OpenAir-Lab/capstone-project/README.md

# capstone-project
ECE 438X Senior Design Capstone Project
