OpenAir-Lab/capstone-project/Documentation/Reference Designs/Texas Instruments/BOOSTXL-BATPAKMKII/Readme.txt

BOOSTXL-BATPAKMKII Hardware Design Files v1.00.00
Texas Instruments, Inc.

********************************************************************************
Welcome to the BOOSTXL-BATPAKMKII BoosterPack!
********************************************************************************

In this package, you will find hardware design files that can help you quickly
get started on developing your own project.

Available in the 'Hardware' folder are the complete board schematic and layout,
bill of material, and Gerber files.

You can also find various web links in the 'Documentation' folder pointing to
the Tool Page, Quick Start Guide, and User's Guide.

For more resources, be sure to visit www.ti.com/tool/boostxl-batpakmkii

********************************************************************************
Revision History
********************************************************************************
Ver 1.00.00 - June 3rd, 2016
- Initial Release

********************************************************************************
Project File Listing
********************************************************************************
|--Documentation                      : Folder containing links to more resources
|--Hardware                           : Folder containing hardware design files,
                                        bill of material and gerber files
|--Readme.txt                         : This file
