OpenAir-Lab/capstone-project/Documentation/RF Subsystem/Radio Transceiver/cc1200/Readme.txt

XXXXXXXXXXXXXXXXXXXXXXXXXXXXXXXXXXXXXXXXXXXXXXXXXXXXXXXXXXXXXXXX
X       Artwork and documentation done by: FRS/a0190551        X
X                                                              X
X       TEXAS INSTRUMENTS NORWAY LPRF                          X
X                                                              X
X       Address: Gaustadalléen 21, 0349 OSLO, Norway           X
X       web: www.ti.com/lprF                                   X
X                                                              X
XXXXXXXXXXXXXXXXXXXXXXXXXXXXXXXXXXXXXXXXXXXXXXXXXXXXXXXXXXXXXXXX

PCB NAME: CC120xEM_420_470
REVISION: 1.1
DATE: 2012-10-22

FILE:  PACKED WITH WinZIP 

PCB DESCRIPTION:4 LAYER PCB 1.24 MM nominal
      Copper        1   35 um
      Dielectric  1-2   0.4 mm (e.g. 2x Prepreg 7628 AT05 47% Resin)
      Copper        2   35 um
      Dielectric  2-3   0.3 mm (2 x 2157 49% Resin)
      Copper        3   35 um
      Dielectric  3-4   0.4 mm (e.g. 2x Prepreg 7628 AT05 47% Resin)
      Copper        4   35 um

      DE104iML or equivalent substrate (Resin contents around 45%, which gives Er=4.45@1GHz, TanD=0.016)
      Dimensions in mil (0.001 inch)
      DOUBLE SIDE SOLDER MASK,
      DOUBLE SIDE SILKSCREEN,
      6 MIL MIN TRACE WIDTH AND 6 MIL MIN ISOLATION.

FILE NAME            		      DESCRIPTION                                               FILE TYPE
-----------------------------------------------------------------------------------------------------------------------
***PCB MANUFACTURING FILES:
Layer1.art                            LAYER 1 TOP SIDE/POSITIVE                                 EXT. GERBER
Layer2.art                            LAYER 2/POSITIVE                                          EXT. GERBER
Layer3.art                            LAYER 3/POSITIVE                                          EXT. GERBER
Layer4.art                            LAYER 4 SOLDER SIDE/POSITIVE                              EXT. GERBER
outline.art                           Outline of PCB                                            EXT. GERBER
soldmask_top.art                      SOLDER MASK COMPONENT SIDE/NEGATIVE                       EXT. GERBER
soldmask_bottom.art                   SOLDER MASK SOLDER SIDE/NEGATIVE                          EXT. GERBER
silk_top.art	                      SILKSCREEN COMPONENT SIDE/POSITIVE                        EXT. GERBER
silk_bottom.art                       SILKSCREEN SOLDER SIDE/POSITIVE                           EXT. GERBER
CC120xEM_420_470-1-4.drl              NC DRILL                                                  EXCELLON
CC120xEM_420_470-1-4-np.drl           NC DRILL                                                  EXCELLON

ncdrill.log                           DRILL/NC DRILL REPORT                                     ASCII

*** ASSEMBLY FILES:
paste_top.art                         SOLDER PAST COMPONENT SIDE/POSITIVE                       EXT. GERBER
paste_bottom.art                      SOLDER PAST SOLDER SIDE/POSITIVE                          EXT. GERBER
assembly_top.art                      ASSEMBLY DRAWING COMPONENT SIDE/NEGATIVE                  EXT. GERBER
assembly_bottom.art                   ASSEMBLY DRAWING SOLDER SIDE/NEGATIVE                     EXT. GERBER
pcp_rep.rpt                           PICK AND PLACE FILE                                       ASCII
CC1200EM_420_470_partlist_1_1_0.xlsx  BOM                                                       Excel

PDF FILES:
CC120XEM_420_470_layout_1_1.pdf       Layout                                                    pdf
CC120XEM_420_470_schematic_1_1_0.pdf  Schematic diagram                                         pdf

README.TXT                            THIS FILE                                                 ASCII

END.
Revision history
----------------
rev.0.1.0 Initial design based on CC112xEM
rev.1.0.0 First design CC120xEM_420_470 (Cadence). Included PCB antanna
rev.1.1.0 Minor PCB change; redesigned PCB antanna.
