OpenAir-Lab/capstone-project/Documentation/RF Subsystem/Radio Transceiver/swrr070/Readme.txt

XXXXXXXXXXXXXXXXXXXXXXXXXXXXXXXXXXXXXXXXXXXXXXXXXXXXXXXXXXXXXXXXXXXXXXXXXXXXXXXXX
X                                                                                                                                                                                  X
X   Artwork and documentation done by: Texas Instruments Norway AS              			    X
X   Company: Texas Instruments Norway AS                                                                                                             X
X   Address: Gaustadalléen 21    0349 OSLO                                      					    X
X                                                                                                                                                                                  X
XXXXXXXXXXXXXXXXXXXXXXXXXXXXXXXXXXXXXXXXXXXXXXXXXXXXXXXXXXXXXXXXXXXXXXXXXXXXXXXXX

PCB NAME : CC-Antenna-DK
REVISION:  1.0 (PCB 1.0.0, BOM 1.0.2)
DATE:         2010-08-26

FILE:           SWRR070.ZIP PACKED WITH WinZIP V.11.0 

PCB DESCRIPTION: 

CC-Antenna-DK -  EtchLayer1Top	-------------------------------------------- 	0.5oz +plating
					CORE  57.68mil	 
CC-Antenna-DK -  EtchLayer2	-------------------------------------------- 	0.5oz+ plating
					
                 2 LAYER PCB 1.6 MM NOMINAL THICKNESS FR4		
                 DOUBLE SIDE SOLDER MASK,
                 SINGLE SIDE SILKSCREEN,
                 8 MIL MIN TRACE WIDTH AND 8 MIL MIN ISOLATION
                 Dielectric constant for FR4 is 4.2

FILE NAME            		                        DESCRIPTION                               	                       FILE TYPE
------------------------------------------------------------------------------------------------------------------
***PCB MANUFACTURING FILES:

CC-Antenna-DK -  EtchLayer1Top.gdo            LAYER 1 COMPONENT SIDE/POSITIV                     EXT. GERBER
CC-Antenna-DK -  EtchLayer2.gdo                  LAYER 2 BOTTOM layer/POSITIV                          EXT. GERBER

CC-Antenna-DK -  SoldermaskTop.gdo            SOLDER MASK COMPONENT SIDE/NEGATIVE         EXT. GERBER
CC-Antenna-DK -  SoldermaskBottom.gdo      SOLDER MASK BOTTOM SIDE/NEGATIVE               EXT. GERBER

CC-Antenna-DK -  SilkscreenTop.gdo              SILKSCREEN COMPONENT SIDE/POSITIVE              EXT. GERBER

CC-Antenna-DK -  SolderPasteTop.gdo           SOLDER PAST COMPONENT SIDE/POSITIVE          EXT. GERBER

CC-Antenna-DK -  Vcut.gdo 	                         V-CUT TRACK COMPONENT SIDE/POSITIVE           EXT. GERBER

CC-Antenna-DK -  DrillDrawingThrough.gdo   DRILL THROUGH HOLE                                           EXT. GERBER
CC-Antenna-DK -  ThruHoleNonPlated.ncd     DRILL NON-PLATED                                               EXT. GERBER
CC-Antenna-DK -  ThruHolePlated.ncd           DRILL PLATED                                                       EXT. GERBER

CC-Antenna-DK -  Rev 1_0_2 BOM and XY Coordinates.xls   BOM & PICK AND PLACE FILE        EXCEL
CC-Antenna-DK -  Outline.gdo	        PCB OUTLINE				     EXT. GERBER

***PDF FILES:
CC-Antenna-DK -  Rev 1_0_2 - COMPONENT PLACEMENT BOTTOM.pdf			     PDF
CC-Antenna-DK -  Rev 1_0_2 - COMPONENT PLACEMENT TOP.pdf			     PDF
CC-Antenna-DK -  Rev 1_0_2 - GERBER.pdf					     PDF
CC-Antenna-DK -  Rev 1_0_2 - SCHEMATIC.pdf					     PDF
									
README.TXT              THIS FILE                                   				     ASCII

***REVISION HISTORY
Rev 1.0                 Release of CC-Antenna-DK

END.
