OpenAir-Lab/capstone-project/Meeting Notes/August 25 - First Meeting of Senior Design 2.md

# Meeting Overview Summary - August 26. 2025
#### Attendees: Zack Potersnak, Eric Mutton, Jairo Thiongo, Adrianne Quick
## Meeting Goals
- Discuss and begin CDR slides to present to Dr.Tacca
- Further expand Gantt chart to include more task-based details
- Align on project requirements and goals
- Further elaborate on design specification of modules
- Plan future meetings for the team with and without Dr.Tacca

## Action Items
- [ ] Order parts by Wednesday afternoon (8.29)
  - All members will need to submit their orders by noon Wednesday (8.29)
- [ ] Send email to Dr. Tacca about planning to meet for CDR at 11:00am Friday (and lock in time for future advisor/team meetings)
- [ ] Fill out all slides for CDR by Thursday at 4:00pm
- [ ] Begin assigning tasks with timelines and descriptions under larger parent items in GitHub
- [ ] Identify and label all blockers (using GitHub Relationships)
- [ ] Attend KiCAD tutorial Friday after Lecture
- [ ] Begin design of PCBs (files due by 9.15)
- [ ] Complete all Summer project design tasks assigned to you in GitHub and place them in 'In Review' column
- [ ] Schedule Team Meeting for Tuesday in the Library study rooms

## Items Discussed & Updates
- Explored more of what Arduino Plug and Make is and how we can use it as a framework for design
  - Discussed packaging our final "kit" in the packaging provided or similar to (if applicable)
- Discussed 3d printing a case for protoboard if needed in the future
- EYESPI and QWIIC connectors will need to be ordered and the team will need to familiarize themelves with it
- Schematics are all in one 'master' document in the 'system-testbed' branch of the GitHub
- Issues in GitHub have been split into Summer and Fall Projects
  - We will need to complete and mark completed or merge all remaining summer tasks 
- Discussed putting the USB-PD on the Base PCB and adding power and ground rails to it similar to a breadboard
- Will use a protoboard to configure initial prototype while making sure all modules work
- Power sequencing was discussed and will need to be further clarified
  - RF Power Amplifier will need 5V but all remaining individual component power needs are 3.3V or below
- Discussed pros & cons of software defined power sequence vs hardwired power sequence
- Discovered need for and will be designing a PCB for the MCU (Adrianne)

#### The timeline for September at a glance is:
  - PCB files completed by September 15th (2nd week)
  - Spend following week reviewing designs and placing order (3rd week)
  - Develop Test Plan and receive PCBs (4th week)

## Future Meeting Details & Acknowledgements
For future meetings each team member is responsible for showing up on time, with deliverables and all applicable talking points 
needed for discussion in the meeting taking place. Each member will be expected to contribute not only to the projects but also in 
every meeting going forward. All meetings are madatory, excluding personal reasons, and if a team member is unable to attend a meeting 
or contribute for any reason, this must be communicated to the team in advance so that contigency plans can be made. Communication 
going forward is a vital part of the team work that has to happen for this project to succeed. Each team member is expected to act with 
professionalism when representing themselves and the team in these meetings.

### ** Team Meeting & Working session (members only): Tuesdays 1:00pm - 5:00pm in McDermott Library 
### ** Pre-Advisor Meeting Side Review (members only): Thursdays 4:00pm - 4:30pm on Teams
### ** Advisor Meeting: Fridays 11:00am (pending Dr.Tacca's approval)
