OpenAir-Lab/capstone-project/Documentation/Reference Designs/Texas Instruments/BOOSTXL-BATPAKMKII/Hardware/gerber/Transcode Report.txt

   ---- Transcoding 'C:\Users\a0273630\Documents\EVMs\BoosterPacks\FuelTank\Battery Boosterpack_v5\gerber\Battery Boosterpack_v2.LayerBottom.ger' ----   Thu Nov 20 16:38:33 2014

D10   --> D100
D11   --> D101
-----------------------------------------------------------------

   ---- Transcoding 'C:\Users\a0273630\Documents\EVMs\BoosterPacks\FuelTank\Battery Boosterpack_v5\gerber\Battery Boosterpack_v2.LayerTop.ger' ----   Thu Nov 20 16:38:33 2014

D10   --> D102
D11   --> D103
D12   --> D104
D13   --> D105
D14   --> D106
D15   --> D107
D16   --> D108
D17   --> D109
D18   --> D110
D19   --> D111
D20   --> D112
D21   --> D113
D22   --> D114
-----------------------------------------------------------------

   ---- Transcoding 'C:\Users\a0273630\Documents\EVMs\BoosterPacks\FuelTank\Battery Boosterpack_v5\gerber\Battery Boosterpack_v2.SilkscreenBottom.ger' ----   Thu Nov 20 16:38:34 2014

D10   --> D115
D11   --> D116
D12   --> D117
D13   --> D118
D14   --> D119
D15   --> D120
D16   --> D121
D17   --> D122
D18   --> D123
D19   --> D124
D20   --> D125
D21   --> D126
D22   --> D127
D23   --> D128
D24   --> D129
D25   --> D130
D26   --> D131
D27   --> D132
D28   --> D133
D29   --> D134
D30   --> D135
D31   --> D136
D32   --> D137
D33   --> D138
D34   --> D139
D35   --> D140
D36   --> D141
D37   --> D142
D38   --> D143
D39   --> D144
D40   --> D145
D41   --> D146
D42   --> D147
D43   --> D148
D44   --> D149
D45   --> D150
D46   --> D151
D47   --> D152
D48   --> D153
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

D10   --> D839
D11   --> D840
D12   --> D841
D13   --> D842
D14   --> D843
D15   --> D844
D16   --> D845
D17   --> D846
-----------------------------------------------------------------

   ---- Transcoding 'C:\space\BOOSTXL-BATPAKMKII\pcb\gerber\BOOSTXL-BATTPACKMKII.SolderStopMaskTop.ger' ----   Thu Sep 17 17:39:15 2015

D10   --> D847
D11   --> D848
D12   --> D849
D13   --> D850
D14   --> D851
D15   --> D852
D16   --> D853
D17   --> D854
D18   --> D855
D19   --> D856
D20   --> D857
D21   --> D858
D22   --> D859
D23   --> D860
D24   --> D861
D25   --> D862
D26   --> D863
D27   --> D864
D28   --> D865
D29   --> D866
D30   --> D867
D31   --> D868
D32   --> D869
D33   --> D870
D34   --> D871
D35   --> D872
D36   --> D873
D37   --> D874
D38   --> D875
D39   --> D876
D40   --> D877
-----------------------------------------------------------------
