OpenAir-Lab/capstone-project/Meeting Notes/Midterm Review.md

# OpenAir Lab Capstone — Schedule

**Current Phase:** Fabrication / Assembly  (IV.C in Final Report Structure)
**Objective:** Backfill Wiki with Final Report information up to [IV.B] and transition into firmware, testing, and documentation.

---

## Project Schedule (Weeks 8–13)

| **Week** | **Dates** | **Focus Area(s)** | **Tasks & Milestones** | **Supporting Work** |
|---|---|---|---|---|
| **Week 8** | Oct 12 – Oct 18 | PCB Finalization & Ordering | - Review & finalize PCBs<br>- Firmware workshop<br>- Order PCBs!!<br>- Advisor meeting & firmware updates<br>- Begin fabrication prep | - Begin building out Wiki<br>- Set up YouTube page |
| **Week 9** | Oct 19 – Oct 25 | Firmware Development & Test Setup | - Begin firmware testing framework<br>- Establish initial test setup | - Implement RTOS structure |
| **Week 10** | Oct 26 – Nov 1 | Test Setup & Software Integration | - Hardware/software integration<br>- Refine test procedures<br>- Start system-level software debugging | - Outline & begin YouTube video structure<br>- Continue Wiki documentation |
| **Week 11** | Nov 2 – Nov 8 | **DEMO WEEK** | - Conduct full system tests<br>- Firmware + software validation<br>- Demo preparation and delivery | - Record and edit YouTube videos<br>- Update Wiki with demo results |
| **Week 12** | Nov 9 – Nov 15 | Development & Troubleshooting | - Develop firmware features<br>- Debug system integration<br>- Troubleshoot PCB and interconnect issues | - Begin creating tutorials and lab documentation |
| **Week 13** | Nov 16 – Nov 22 | Refinement & Documentation | - Continue development and testing<br>- Finalize troubleshooting<br>- Build tutorials and educational lab materials | - Publish YouTube tutorials<br>- Finalize Wiki and final report sections |

---

**Deliverables by End of Week 13:**
- All subsystem PCBs fabricated and tested  
- Firmware and RTOS integrated across modules  
- Wiki fully populated with documentation, schematics, and video walkthroughs  
- YouTube tutorials and educational lab materials published  
- Final report completed and cross-referenced to Wiki sections  

# GitHub Wiki Structure

> **Legend:**  
> 🟢 = Backfill (content mostly complete; needs upload/cleanup)  
> 🟠 = In progress  
> 🔴 = Not started  

---

## 1. Background 🟢

---

## 2. Preliminary Design 🟠
- Problem Analysis  
- Specs / Features / Criteria  
- Decision Analysis  
  - Solution Analysis 🟢  
  - Effectiveness Criteria 🟢  

---

## 3. Solution Description 🟠
- List of Subsystems  
- Firmware? (TBD clarification)

---

## 4. Performance Optimization 🟠
- System Component Design  
- Design Criteria 🟢  
- Components (for each subsystem) 🟢  
- Fabrication Process 🔴  
- Performance Evaluation  
  - Metrics (e.g., CS, etc.) 🔴  

---

## 5. Performance Evaluation 🔴
- Metrics (CS, ...)

---

## 6. Project Implementation / Assessment 🟢
- Implementation Overview  
- Quantitative Results  
- Results Related to Design Criteria  

---

## 7. Conclusion, Overview of Work Statements 🟢

---

## 8. Future Work Recommendations 🟢
- Proposal as Conference Material or Lab Resource  

---

## 9. Other Issues 🟢
- Ethics / Environmental Discussion of Issues  
- Operating Instructions  
  - Setup, Modes of Operation  

---

## 10. Cost Estimate 🔴
- Materials, Construction  
- Purchase, Travel, Misc.  

---

## 11. Project Management Summary 🟢
- Tasks Completed / Pending  
- Time Allocated  
- Facilities and Personnel  

---

## 12. Appendices 🟢
- Bibliography  
- Design Schedule 🟠  
- Construction Schedule 🟢  
- Equipment List & Cost Breakdown 🟢  
- Subsystem PCB Pages 🟢  
- Design Drawings  
  - Method Design / Final Design 🟢  
- Code 🟢  

---

### 🔧 Notes
- Wiki sections correspond to Final Report structure ([IV.B] through [IV.C]).  
- Items marked 🟢 are ready to be ported or backfilled into the Wiki.  
- Items marked 🟠 are under current development (firmware, RTOS, design criteria, etc.).  
- Items marked 🔴 have not yet been started and should be scheduled during Weeks 9–11.  

---

**Next Steps**
1. Backfill all 🟢 sections from existing documentation and reports.  
2. Continue developing 🟠 sections during firmware and demo phase.  
3. Assign leads for 🔴 sections before final report compilation.
