OpenAir-Lab/capstone-project/Meeting Notes/september 4 - Team Slide Review.md

# Team Slide Review – Meeting Summary

## General Notes
- Meeting focused on slide preparation for advisor updates.
- Some technical issues with screen sharing and connectivity at the start.
- Emphasis on keeping updates forward-looking (covering both last week’s work and upcoming goals).

---

## Slide Updates & Deadlines
- **Update Content**: Each team member must update their slides with accomplishments and planned tasks by **tomorrow night**.
- **Deadline Concern**: Avoid last-minute updates; aim to finish before going to bed tonight if possible.
- **Format**: Each slide should include at least **3 action items**, broken down into smaller tasks to show steady progress.

---

## Key Slide Sections
1. **Timeline & Testing**
   - Add updated Gantt chart snapshot.
   - Break down remaining testing phases into tasks.
   - Prioritize testing breakdown urgently.

2. **Budget/BOM (Bill of Materials)**
   - Show starting budget, amount spent, and remaining balance.
   - Add tables with order forms.
   - Keep a running slide that tracks BOM progress with color coding:
     - Ordered
     - Received
     - Pending

3. **Subsystem Updates**
   - **Power Supply**: Questions around load switches. Concerns raised about introducing them too early without team-wide discussion.
   - **Microcontroller (Adrianne)**: Completed pin-mapping for CC1200, HMI display, USB-PD, keypad expander, microphone, and amp. Linked GitHub table for updates.
   - **RF System (Eric)**: Created footprints for modular connectors. Focus on routing and SPI interfacing. Considering use of a diplexer for band switching.
   - **Audio (Dominic)**: Addressing CDR feedback about I²S protocol and audio amplifier pin functions. Needs clear action items.
   - **HMI**: Drafting modulino layouts to show how keypad, knobs, and display fit together. Not presentation-ready yet.

---

## Advisor & Presentation Strategy
- Advisor (Dr. Tacca) should review BOM updates weekly, even if approved earlier.
- Slides should highlight **new progress only** to avoid redundancy.
- Upcoming Friday meeting is critical: need presentable PCB drafts.

---

## Educational Deliverables
- Begin planning **educational documentation and videos** soon.
- Zack has video editing skills – formalize his role for tutorials.
- YouTube channel creation in progress.

---

## Action Items
- All team members update slides with:
  - Completed tasks (last week + expected by next Friday).
  - At least 3 action items (smaller, trackable steps).
- Add updated Gantt chart, BOM tables, and budget overview.
- Subsystem owners ensure schematic capture and PCB drafts are included where possible.
- Educational content planning to start – assign roles.
- Next **workflow workshop** scheduled for **Monday** (in person).

---
