OpenAir-Lab/capstone-project/Meeting Notes/june-21-Team-meeting.md

Dominic - Power 

Adrianne - MCU (w/minor RF) &PCB

Jairo - Power

Zach - Power/MCU

Eric - Power/MCU & PCB

Entire Team - Power Amplifier 

Clip board with log sheet at station

We need to make sure the kits don’t exist 

Action Items:

Once over the Team Charter

Turn in Team Charter 

Palatable way to package the project and present it to Dr. Tacca
