OpenAir-Lab/capstone-project/Meeting Notes/PDR-July 21.md

# PDR Meeting 7.21.25

Here is a summary of questions Dr. Tacca would like us to be able to answer & advice he had for our project so far:

### For the Requirements Slide: 

- What constitutes a “standard educational framework”?  
- The requirements should be more attuned to ‘checkpoints’ instead of broad statements about the project. They need to be completable and have justifiable metrics that can verify the requirement has been met by others outside of the team.  
- “Easily accessible” means what? 

### For the Lithium-Ion Battery:

- Cover all bases that entail safety for this type of battery   
  - This includes how to store it when the device is not in use   
  - how to store it before or after assembly  
  - How to monitor it safely 

\*→ He discussed power output values with Jairo, I am a little unclear on what he was asking, I apologize. There was a mention of keeping the power below 20 watts at some point. If Jairo can fill in a little more information here about what they spoke about it would be greatly appreciated ←\*

### For the MCU:

- Look into whether both cores can be used with the Arduino IDE a  
- Is one dedicated to bluetooth/wi-fi?  
- 2 dedicated ports for I2S  
- Consider Pi-W  
- Use custom devkit for WROVER or espressif prebuilt?

### For the Audio:

- Look into what PCM entails and familiarize ourselves with it  
- Look into I2S and what that entails  
- Figure out the sampling rate for ham radio  
- Talk about a combination mic & speaker together in one IC   
- Figure out what we need to know for the audio to communicate with the MCU  
- How many ports and what protocols are needed

### For the HMI:

- Consider Pi-W if we are using a GUI or intricate display

#### Advice moving forward and presenting our project at the Expo as well as CDR:

- We need to be highlighting the educational aspect of our project more \- even at a high level (This means **by the Expo**)  
- Look into the IEEE framework and how our project fits into this  
- How are we going to make it exciting (i.e. documentation is boring)  
- Consider a video-style documentation  
- Consider a YouTube Channel (would Zach or anyone else be interested in the production/filming/editing aspect of this?) (Zach - yes)

We also have permission to start ordering parts as we see fit.

If anyone has anything else to add to this, please feel free
