OpenAir-Lab/capstone-project/Meeting Notes/Team Meeting for CDR slide review.md

# Capstone Team Meeting – CDR Slide Review

**Date/Time:** August 28, 2025  
**Attendees:** Eric Mutton, Adrianne Quick, Zack Potersnak, Jairo Thiongo, Dominic Nguyen  

## Agenda / Purpose  
- Review CDR slide deck in detail.  
- Assign presenters for each section.  
- Confirm content completeness (requirements, subsystems, statements).  
- Identify open questions for Dr. Tacca during the CDR.  

## Discussion Summary  
- **Agenda & Updates:** Agenda aligns with CDR requirements. Hours logged weekly. Gantt chart complete at high level, more detail needed. “Initial communication verification between CC1200 and MCU” added as next step.  
- **Abstract:** Condensed to three main points. Zack presenting.  
- **Presenter Assignments:**  
  - Agenda/Updates: Eric  
  - Abstract & Requirements: Zack  
  - Power Delivery: Jairo  
  - MCU & Interfaces: Adrianne  
  - RF: Eric  
  - Audio: Dominic  
  - HMI: Eric (backup Adrianne)  
  - Educational Goals: Zack  
  - Ethics: Dominic  
  - Lifelong Learning: Eric  
  - Contemporary Issues: Jairo  
  - Multidisciplinary: Adrianne  
- **Materials & Budget:** Slide is a summary; renamed “Materials & Budget.” $400 spent of $2000 budget.  
- **Subsystem Slides:** Power Delivery, MCU, RF, Audio, HMI covered. Notes on refinements: risk mitigation for RF, complete MCU schematics, expand Audio notes.  
- **Educational Goals:** Documentation to include schematics and firmware notes plus GitHub Wiki and YouTube channel tutorials.  
- **Statements:** Ethics, Lifelong Learning, Contemporary Issues, and Multidisciplinary statements assigned.  
- **Questions for DT:** OLED vs. TFT trade-offs; final product expectations (breadboard vs. enclosure); additional subsystem questions (Jairo, Domi
