OpenAir-Lab/capstone-project/Meeting Notes/notion/data-Sheets.md

# Data Sheets

[BQ24193](https://www.ti.com/product/BQ24193)

### Sub-1 GHz Radio Transceivers

The CC1101 is used in the [Flipper Zero](https://docs.flipper.net/sub-ghz)!

[CC1101](https://www.ti.com/product/CC1101)

There are two CC1200 evaluation boards currently at our table 👀

[CC1200](https://www.ti.com/product/CC1200)
