OpenAir-Lab/capstone-project/Meeting Notes/notion/resource-links.md

# Resource Links
#### When adding links to this file please include a brief description along with the link for ease and organization

- The UTDesign official [general project schedule](https://utdesignstudents.utdallas.edu/resources/project-schedule/) that gives a high level flow chart
- The [Team Charter](https://cometmail-my.sharepoint.com/:w:/g/personal/ejm190004_utdallas_edu/EQ1LKnZOM8VIiSS7B3VIxckBgWL9uP-HIgmwtFDW-8lb2w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) that opens Microsoft Office in your browser
- Amateur Radio Licensing [study application](https://blog.hamstudy.org/links/) - opens to helpful links
- KiCAD [Getting Started](https://docs.kicad.org/9.0/en/getting_started_in_kicad/getting_started_in_kicad.pdf) docs
- [GitHub Projects](https://docs.github.com/en/issues/planning-and-tracking-with-projects/learning-about-projects/about-projects) docs
- [GitHub Repositories](https://docs.github.com/en/repositories) docs
- [Learn Git Branching](https://learngitbranching.js.org/)
- [AWR RF Design Environment](https://www.cadence.com/en_US/home/tools/system-analysis/rf-microwave-design/awr-design-environment-platform.html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)
- [RF Cafe](https://www.rfcafe.com/) - recommended by Dr. Tacca
- Microwave [Information](https://www.microwaves101.com/) Resource
- Textbook information on [Matching Networks](https://eng.libretexts.org/Bookshelves/Electrical_Engineering/Electronics/Microwave_and_RF_Design_III_-_Networks_(Steer)/06%3A_Chapter_6/6.2%3A_Matching_Networks)
- Open Source Hardware (OSHWA) [Certification](https://certification.oshwa.org/)
