OpenAir-Lab/capstone-project/Meeting Notes/notion/youtube-channels.md

## PCB Design Guidance

[Phil’s Lab](https://www.youtube.com/@PhilsLab)

[PCB Design](https://www.youtube.com/playlist?list=PLXSyc11qLa1b9VA7nw8-DiLRXVhZ2iUN2)

### Power Delivery Board Design

[USB-C Power Delivery Hardware Design - Phil's Lab #104](https://www.youtube.com/watch?v=W13HNsoHj7A&list=PLXSyc11qLa1YhVCZ5xWPuPsE5MkgEy5TF&index=9&pp=iAQB)

### Design-for-Manufacturing

[PCB Design for Manufacturing Tips (DFM) - Phil's Lab #40](https://www.youtube.com/watch?v=T922aFyN6bw&list=PLXSyc11qLa1YhVCZ5xWPuPsE5MkgEy5TF&index=44&pp=iAQB)

Investigate [Hammond Cases](https://www.hammfg.com/part/1455L801BK?referer=1203) for common PCB sizing constraints and project enclosures

[Making Enclosure Panels Using PCBs - Phil's Lab #102](https://www.youtube.com/watch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)

### RF PC Board Design

[Practical RF Hardware and PCB Design Tips - Phil's Lab #19](https://www.youtube.com/watch?v=_Hfzq1QES-Q&list=PLXSyc11qLa1YhVCZ5xWPuPsE5MkgEy5TF&index=56&pp=iAQB)

[PCB Traces 101 - Phil's Lab #112](https://www.youtube.com/watch?v=xEVntmYLARw&list=PLXSyc11qLa1YhVCZ5xWPuPsE5MkgEy5TF&index=3&pp=iAQB)

## Low-Level Programming Guidance

[Ben Eater](https://www.youtube.com/@BenEater)
