OpenAir-Lab/capstone-project/Meeting Notes/notion/previous-SD-posters.md

## Wi-SUN Smart Traffic System

[Submit-Poster-for-EXPO_Team-2024_attempt_2024-12-09-21-13-23_FinalPosterFall2024-Copy(1).pptx](attachment:9f649d76-8c50-418c-89ad-cf9f179707b4:Submit-Poster-for-EXPO_Team-2024_attempt_2024-12-09-21-13-23_FinalPosterFall2024-Copy(1).pptx)

- IoT Mesh using TI radio chips (CoAP Packet Error Rates)
- Embedded Programming (RTOS)
- PCB Design for Concept Testbench
- Long-Distance Smart City EMCOMM

## Hackers: Dynamic Engineering Puzzle Game

[Submit-Poster-for-EXPO_Team-2028_attempt_2024-12-09-21-33-17_PosterTeam2028-Copy.pptx](attachment:733f7303-a750-412c-9e36-0c41140147e4:Submit-Poster-for-EXPO_Team-2028_attempt_2024-12-09-21-33-17_PosterTeam2028-Copy.pptx)

- High-school ECE Fundamentals Educational Platform
- PCB design for Vault Puzzle Games
- Embedded Programming and Game Design

## Solar Charging Station

[Submit-Poster-for-EXPO_Team-2052_attempt_2024-12-09-21-16-13_Team-2052-Senior-Project-Expo-Poster-Solar-Charging-Station-UTDExpo21-Copy.pptx](attachment:7120a6c9-f75b-4df4-9edf-7ee4e6276949:Submit-Poster-for-EXPO_Team-2052_attempt_2024-12-09-21-16-13_Team-2052-Senior-Project-Expo-Poster-Solar-Charging-Station-UTDExpo21-Copy.pptx)

- Initial Project Work as Recreational/Hobby Drone Battery charger
- Extended to more Power Delivery options for different LiPo batteries
- Ethics Statement: Our team pledges that our project will conform to IEC and UL safety guidelines and standards for charging devices.
- 3D Printed Chassis

## Project 21cm

[Submit-Poster-for-EXPO_Team-2022_attempt_2024-12-09-23-56-22_EXPO2_Poster_Team2022-Copy.pptx](attachment:e78a06b2-2662-46c9-a283-69ed7613edb1:Submit-Poster-for-EXPO_Team-2022_attempt_2024-12-09-23-56-22_EXPO2_Poster_Team2022-Copy.pptx)

- Hobbyist Astronomic Telescopy using Software Defined Radio
- Actuating antenna (Az/El) for Magnitude Heatmap
- Embedded Programming for stepper motor driver boards and 6-DoF Gyro
- Rectangular Horn Antenna Modelling (Gain/Beam Plot)
