OpenAir-Lab/capstone-project/Documentation/Datasheets/Adafruit/adafruit-eyespi-pinout.png

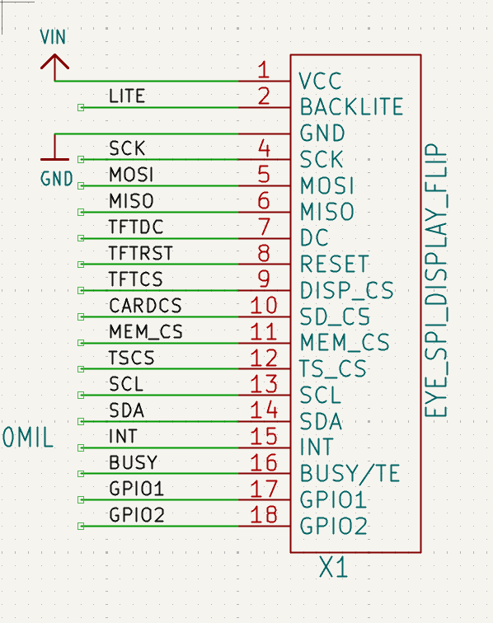
Documentation/Datasheets/Adafruit/adafruit-eyespi-pinout.png
