OpenAir-Lab/capstone-project/Documentation/RF Subsystem/Radio Transceiver/cc1200/8623.timing.png

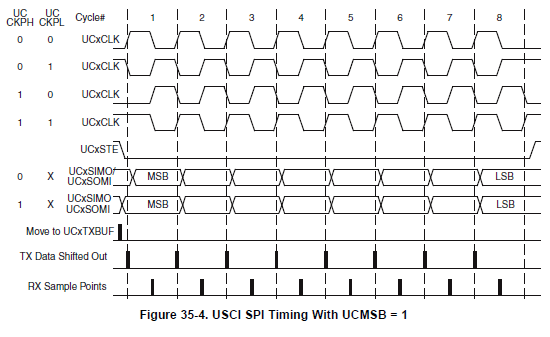
Documentation/RF Subsystem/Radio Transceiver/cc1200/8623.timing.png
