OpenAir-Lab/capstone-project/Documentation/RF Subsystem/Radio Transceiver/swrr070/CC-Antenna-DK -  Rev 1_0_2 BOM and XY Coordinates.xls

Sheet: TI BOM Rev 1.0.2
AntennaKit Board Rev: 1.0.2
This list is automatically linked up to the G:\06_TEKNISK\06H_Cadstar\purchase_library\PurchaseLib.xls
Enter columns in green
Ref. | Part name | Pcs/unit | Description | Manufacturer | Part number | Supplier | Ordering code | Alt. Manufacturer | Alt. Part number | Alt. Supplier | Alt. Ordering code | Comments
P1, P2, P3, P4, P5, P6, P7, P8, P9, P10, P11, P12, P13, P14, P15, P16 | SMA_Female_ThroughHole | 16 | SMA connector, female, through hole | Wellshow Techology | C02AN31P00101 | Freber | C02AN31P00101
R21, R22 | R_100_0402_F | 2 | Resistor, 100 ohms, 0402, ±1% | Koa | RK73H1ETTP1000F | ELFA | 60-475-75
A3, A12 | AMD1103-ST01T | 2 | MITSUBISHI CHIP ANTENNA | Mitsubishi | AMD1103-ST01T | Mitsubishi | AMD1103-ST01T
A4 | W3013 | 1 | PULSE CHIP ANTENNA | Pulse | W3013 | Pulse | W3013
A8 | W3127 | 1 | PULSE HELICAL ANTENNA | Pulse | W3127 | Pulse | W3127
A16 | W3126 | 1 | PULSE HELICAL ANTENNA | Pulse | W3126 | Pulse | W3126
A141, A142 | ANT-315-HETH | 2 | ANTENNA FACTOR (ANT-315-HETH), ANTENNA 315MHZ THRU HOLE | Linx Technologies Inc | ANT-315-HETH | Digikey | ANT-315-HETH-ND
A13 | ANT-433-HETH | 1 | ANTENNA FACTOR (ANT-433-HETH), ANTENNA 433MHZ THRU HOLE | Linx Technologies Inc | ANT-433-HETH | Digikey | ANT-433-HETH-ND
A11 | ANT-916-HETH | 1 | ANTENNA FACTOR (ANT-916-HETH), ANTENNA 916MHZ THRU HOLE | Linx Technologies Inc | ANT-916-HETH | Digikey | ANT-916-HETH-ND
Z31, Z42, Z53, Z63, Z71, Z73, Z103, Z111, Z121, Z131, Z141, Z151 | C_0402 | 12 | Capacitor, general, 0402; Do not mount
Z33, Z41, Z54, Z72, Z83, Z104, Z152 | R_0_0402 | 7 | Resistor, 0 ohm, 0402 | Koa | RK73Z1ETTP | ELFA | 60-470-05
Z113, Z132 | L_27N_0402_J | 2 | Inductor, 27n, 0402, ±5% | Murata | LQG15HS27NJ02D | ACTE
Z43 | C_8P2_0402_NP0_C_50 | 1 | Capacitor, 8p2, 0402, NP0, +-0.25pF, 50V | Murata | GRM1555C1H8R2CZ01D
Z101, Z61 | L_10N_0402_J | 2 | Inductor, 10n, 0402, ±5% | Murata | LQG15HS10NJ02D |  |  | Coilcraft
Z32, Z82, Z162 | L_22N_0402_J | 3 | Inductor, 22n, 0402, ±5% | Murata | LQG15HS22NJ02D | ACTE
Z102 | L_12N_0402_J | 1 | Inductor, 12n, 0402, ±5% | Murata | LQG15HS12NJ02D | ACTE
Z123 | L_39N_0402_J | 1 | Inductor, 39n, 0402, ±5% | Murata | LQG15HS39NJ02D
Z112 | L_18N_0402_J | 1 | Inductor, 18n, 0402, ±5% | Murata | LQG15HS18NJ02D | ACTE
Z62 | C_2P7_0402_NP0_C_50 | 1 | Capacitor, 2p7, 0402, NP0, +-0.25pF, 50V | Murata | GRM1555C1H2R7CZ01D
Z81 | C_7P5_0402_NP0_C_50 | 1 | Capacitor, 7p5, 0402, NP0, +/-0.25pF 50V | Murata | GRM1555C1H7R5CZ01D
Z122 | L_68N_0402_J | 1 | Inductor, 68n, 0402, ±5% | Coilcraft
Z51 | C_6P2_0402_NP0_C_50 | 1 | Capacitor, 6p8, 0402, NP0, +-0.25pF 50V | Murata | GRM1555C1H6R2CZ01D
Z133 | C_5P6_0402_NP0_C_50 | 1 | Capacitor, 5p6, 0402, NP0, +-0.25pF, 50V | Murata | GRM1555C1H5R6CZ01D
Z142 | L_47N_0402_J | 1 | Inductor, 47n, 0402, ±5% | Murata | LQG15HS47NJ02D
Z143 | L_100N_0402_J | 1 | Inductor, 100n, 0402, ±5% | Murata | LQG15HSR10J02
Z153 | C_1P2_0402_NP0_C_50 | 1 | Capacitor, 1p2, 0402, NP0, +/-0.25pF 50V | Murata | GRM1555C1H1R2CZ01D
Z161 | C_22P_0402_NP0_J_50 | 1 | Capacitor, 22p, 0402, NP0, 5%, 50V | Murata | GRM1555C1H220JZ01D
Z52 | L_5N6_0402_S | 1 | Inductor, 5n6, 0402, Monolithic type, +/-0.3 nH | Murata | LQG15HS5N6S02D | ACTE |  | Coilcraft |  | FINNES IKKE SOM 5%, GJO 18_03_2004, bruk S-tolerance
Z163 | L_4N7_0402_S | 1 | Inductor, 4n7, 0402, +/-0.3 nH | Murata | LQG15HS4N7S02D | ACTE
 |  | 68

Sheet: XY Coordinates Rev 1.0.2
XY Coordinates
Reference Designator | X | Y | Side
P9 | 20.00 | 51.70 | BOTTOM
P10 | 40.00 | 51.70 | BOTTOM
P11 | 66.00 | 51.70 | BOTTOM
P12 | 98.00 | 51.70 | BOTTOM
P13 | 135.00 | 51.70 | BOTTOM
P14 | 175.00 | 51.70 | BOTTOM
P15 | 214.00 | 51.70 | BOTTOM
P16 | 246.00 | 51.70 | BOTTOM
P8 | 246.00 | 146.70 | BOTTOM
P7 | 217.30 | 146.70 | BOTTOM
P6 | 182.40 | 146.70 | BOTTOM
P5 | 136.00 | 146.70 | BOTTOM
P4 | 110.00 | 150.90 | BOTTOM
P3 | 65.00 | 146.70 | BOTTOM
P2 | 40.00 | 146.70 | BOTTOM
P1 | 20.00 | 146.70 | BOTTOM
A11 | 65.95 | 88.41 | TOP
Z83 | 245.95 | 168.45 | TOP
Z163 | 245.95 | 73.41 | TOP
A142 | 182.60 | 99.00 | TOP
A141 | 182.60 | 86.60 | TOP
A13 | 137.90 | 99.00 | TOP
Z71 | 217.70 | 165.26 | TOP
Z61 | 182.80 | 165.26 | TOP
Z51 | 136.40 | 165.27 | TOP
Z31 | 65.40 | 165.27 | TOP
Z101 | 40.40 | 70.27 | TOP
Z121 | 98.40 | 70.27 | TOP
Z131 | 135.40 | 70.27 | TOP
Z133 | 135.40 | 72.97 | TOP
Z143 | 175.40 | 72.97 | TOP
Z153 | 214.40 | 72.97 | TOP
Z103 | 40.40 | 72.97 | TOP
Z73 | 217.70 | 167.97 | TOP
Z63 | 182.79 | 167.97 | TOP
Z53 | 136.40 | 167.97 | TOP
Z151 | 214.39 | 70.27 | TOP
Z141 | 175.40 | 70.27 | TOP
Z112 | 65.95 | 71.62 | TOP
Z111 | 66.39 | 70.27 | TOP
Z113 | 66.41 | 72.97 | TOP
A8 | 254.75 | 174.25 | TOP
A16 | 254.75 | 79.25 | TOP
Z32 | 64.95 | 169.40 | TOP
Z33 | 64.95 | 171.40 | TOP
A12 | 86.70 | 101.70 | TOP
A3 | 56.50 | 196.95 | TOP
Z42 | 92.13 | 151.30 | TOP
Z43 | 89.43 | 151.30 | TOP
Z41 | 90.78 | 150.85 | TOP
A4 | 83.00 | 159.90 | TOP
Z122 | 97.93 | 74.40 | TOP
Z123 | 97.91 | 76.26 | TOP
Z162 | 245.95 | 71.60 | TOP
Z161 | 246.40 | 70.24 | TOP
Z81 | 246.40 | 165.26 | TOP
Z82 | 245.95 | 166.62 | TOP
Z104 | 39.95 | 75.10 | TOP
Z54 | 135.96 | 169.92 | TOP
R22 | 40.84 | 165.27 | TOP
R21 | 39.03 | 165.27 | TOP
Z132 | 134.95 | 71.62 | TOP
Z142 | 174.95 | 71.62 | TOP
Z152 | 213.95 | 71.62 | TOP
Z102 | 39.95 | 71.62 | TOP
Z52 | 135.95 | 166.62 | TOP
Z62 | 182.35 | 166.62 | TOP
Z72 | 217.25 | 166.62 | TOP
