OpenAir-Lab/capstone-project/Documentation/Reference Designs/Texas Instruments/BOOSTXL-BATPAKMKII/Hardware/BOOSTXL-BATPAKMKII.xls

Item | Embest P/N | Material Name | Material P/N |  | Usage | Location | Manufacturer | Description | Package
1 | 1009002200110 | Pin Socket | CRD-081413-A-G | PCS | 2 | J1,J2, J3, J4 | Major League | Connector,Pin Socket,Straight,Female,2x10Pin,2.54MM pitch,8.5,9.92,Gold Flash 1u, black,DIP | DIP
2 | 1009001200003 | Pin Header | P6E02A-602530-B1 | PCS | 1 | JP6 | CHI-BAN | Connector,Pin Header,Straight,Male,1x2Pin,2.54MM pitch,6.06,3.00,Gold Flash 1u, black,DIP | DIP
3 | 1009003100046 | Wafer | S2B-PH-SM4-TB(LF)(SN) | PCS | 1 | BATT | JST | Connector,PH Series PCB Header,Right Angle,Male,1x2Pin,2.0MM pitch,Tin Plated,white,SMD | SMD
4 | 1003001100161 | Thick film Resistor | RC0603JR-070RL | PCS | 7 | R2, R11, R12, R13, R25, R26,R28 | YAGEO | RES,0R,+/-5%,1/10W,SMD0603 | 0603
5 | 1003001100456 | Thick film Resistor | CRF1206-FX-R010ELF | PCS | 1 | R10 | Bourns | RES,0R01,+/-1%,1W,SMD1206 | 1206
6 | 1004001100116 | Ceramic Capacitor | GRM188R71C474KA88D | PCS | 3 | C6, C11, C12 | Murata | CAP,470NF,+/-10%,X7R,16V,SMD0603 | 0603
7 | 1003001100654 | Thick film Resistor | RC0603FR-071M8L | PCS | 1 | R14 | YAGEO | RES,1M8,+/-1%,1/10W,SMD0603 | 0603
8 | 1003001100202 | Thick film Resistor | RC0603JR-071KL | PCS | 1 | R3 | YAGEO | RES,1K,+/-5%,1/10W,SMD0603 | 0603
9 | 1004001100120 | Ceramic Capacitor | GRM188R71C105KA12D | PCS | 5 | C3, C8, C13, C16, C17 | Murata | CAP,1UF,+/-10%,X7R,16V,SMD0603 | 0603
10 | 1005004100006 | Inductor | LQM2HPN1R0MG0L | PCS | 1 | L3 | Murata | Power Inductor,Magnetic shielded,1uH,1.6A,0.055ohm,2.5X2.0X0.9mm,SMD | 1008
11 | 1005004100074 | Inductor | VLF4012AT-2R2M1R5 | PCS | 2 | L1, L2 | TDK | Power Inductor,Magnetic shielded,2.2uH,1.5A,0.076ohm,3.7x3.5x1.2mm,SMD | 3.7x3.5x1.2mm
12 | 1003001100223 | Thick film Resistor | RC0603JR-075K1L | PCS | 4 | R15,R5, R6, R7 | YAGEO | RES,5K1,+/-5%,1/10W,SMD0603 | 0603
13 | 1003001100229 | Thick film Resistor | RC0603FR-077K5L | PCS | 1 | R16 | YAGEO | RES,7K5,+/-1%,1/10W,SMD0603 | 0603
14 | 1003001100235 | Thick film Resistor | RC0603JR-0710KL | PCS | 6 | R8, R18, R20, R29, R30, R31 | YAGEO | RES,10K,+/-5%,1/10W,SMD0603 | 0603
15 | 1004001100129 | Ceramic Capacitor | GRM188R61A106KE69D | PCS | 4 | C1, C2, C9, C10 | Murata | CAP,10UF,+/-10%,X5R,10V,SMD0603 | 0603
16 | 1004001100162 | Ceramic Capacitor | GRM21BR60J226ME39L | PCS | 1 | C15 | Murata | CAP,22UF,+/-20%,X5R,6.3V,SMD0805 | 0805
17 | 1004001100106 | Ceramic Capacitor | GRM188R71C333KA01D | PCS | 1 | C14 | Murata | CAP,33NF,+/-10%,X7R,16V,SMD0603 | 0603
18 | 1003001100270 | Thick film Resistor | RC0603FR-07100KL | PCS | 1 | R22 | YAGEO | RES,100K,+/-1%,1/10W,SMD0603 | 0603
19 | 1003001100191 | Thick film Resistor | RC0603FR-07200RL | PCS | 2.00 | R23, R24 | YAGEO | RES,200R,+/-1%,1/10W,SMD0603 | 0603
20 | 1003001100584 | Thick film Resistor | RC0603FR-07270RL | PCS | 1 | R1 | YAGEO | RES,270R,+/-1%,1/10W,SMD0603 | 0603
21 | 1003001100655 | Thick film Resistor | RC0603FR-07274KL | PCS | 1 | R21 | YAGEO | RES,274K,+/-1%,1/10W,SMD0603 | 0603
22 | 1003001100364 | Thick film Resistor | RC0603FR-07499RL | PCS | 1 | R4 | YAGEO | RES,499R, +/-1%,1/10W,SMD0603 | 0603
23 | 1002004100080C | Power Management | BQ24250RGE | PCS | 1 | U2 | TI | IC,2A Single Input I2C, Standalone Switch-Mode Li-Ion Battery Charger with Power-Path Ion Battery Charger with Power-Path,VQFN-24,SMD | VQFN-24
24 | 1002004100081C | Power Management | BQ27441DRZT-G1A | PCS | 1 | U1 | TI | IC,ystem-Side Impedance Track. Fuel Gauge,SON-12,SMD | SON-12
25 | 1009007100030 | USB Connector | ZX62-B-5PA | PCS | 1 | USB | Hirose | Connector,MicroUSB B port,5 Position,Right Angle,Gold Flash 1u,black,SMD | SMD
26 | 1006002100036 | Diode | DFLS130L-7 | PCS | 2 | D1, D2 | Diodes | Diode,Schottky Diode,DFLS130L-7,21V,1A,PowerDI-123,SMD | PowerDI-123
Replaced |  | Thick film Resistor | RC0805JR-070RL | PCS | 2 |  | YAGEO | 0 ohm
27 | 1002005100052 | DC-DC | TPS63001DRCTG4 | PCS | 1 | IC3 | TI | IC,High efficient single inductor buck-boost converter,1.2A,QFN10,SMD;Customer Supply | QFN-10
28 | 1002005100053 | DC-DC | TPS63002DRCTG4 | PCS | 1 | IC4 | TI | IC,High efficient single inductor buck-boost converter,1.2A,QFN10,SMD;Customer Supply | QFN-10
29 | 1010002200002 | Toggle switch | TS-6 | PCS | 1 | S1 | Hongju | Switch,Toggle switch SPDT,right angle,3A@120VAC,red housing,nature plunger,19.63*9.13MM,DIP | DIP
30 | 1006001100033 | LED | FY1101F-TR | PCS | 1 | LED2 | Stanley | LED,Brightness Yellow,Water Clear,Right Angle Type,20mA,3.2x2.0mm,SMD | 3.2x2.0mm
31 | 1016001000004 | Battery | AE503759P6HA | PCS | 1 |  | AEenergy | Battery,Li Polymer Rechargeable Battery,3.7V,1200mAh,37x60x5mm
32 | 1001001000364 | PCB | Boostxl-Battpack PCB | PCS | 1 |  |  | 2 layers PCB,Green Soldermask,white Silkscreen,66x58mm,Immersion gold,Boostxl-Battpack PCB
