OpenAir-Lab/capstone-project/Documentation/RF Subsystem/Radio Transceiver/CC120X vs CC112X.xlsx

CC1200 EM 446 MHz version
Including LPF
Ref. | CC112X selection | CC120X selection
C11 | C_47N_0402_X7R_K_25 | 47nF | Same value
C12 | C_100N_0402_X5R_K_10 | DNM | FOR REGULATOR
C41 | C_10N_0402_X7R_K_25 | DNM | FOR REGULATOR
C51 | C_47N_0402_X7R_K_25 | 47nF | Same value
C52 | C_2U2_0603_X5R_K_10 | 2.2uF | Same value
C53 | DNM | 47nF | FOR REGULATOR
C61 | C_220N_0402_X5R_K_10 | 220nF | Same value
C121 | C_47N_0402_X7R_K_25 | 47nF | Same value
C131 | C_47N_0402_X7R_K_25 | 47nF | Same value
C151 | C_47N_0402_X7R_K_25 | 47nF | Same value
C171 | C_10N_0402_X7R_K_25 | 10nF | Same value
C172 | C_100P_0402_NP0_J_50 | 100pF | Same value
C173 | C_100P_0402_NP0_J_50 | 56pF | Frequency dependence?
C174 | C_82P_0402_NP0_J_50 | 39pF | Frequency dependence?
C175 | C_15P_0402_NP0_J_50 | 6.2pF | Frequency dependence?
C176 | C_12P_0402_NP0_J_50 | 2.2pF | Frequency dependence?
C177 | C_1P2_0402_NP0_B_50 | DNM
C181 | C_12P_0402_NP0_J_50 | 5.1pF | Frequency dependence?
C191 | C_12P_0402_NP0_J_50 | 5.1pF | Frequency dependence?
C201 | C_12P_0402_NP0_J_50 | 5.1pF | Frequency dependence?
C211 | C_10N_0402_X7R_K_25 | 10nF | Same value
C221 | C_47N_0402_X7R_K_25 | 47nF | Same value
C231 | C_1N8_0402_U2J_J_10 | 1.5nF | Frequency dependence?
C251 | C_47N_0402_X7R_K_25 | 47nF | Same value
C261 | C_47N_0402_X7R_K_25 | 47nF | Same value
C271 | C_47N_0402_X7R_K_25 | 47nF | Same value
C281 | C_47N_0402_X7R_K_25 | 47nF | Same value
C291 | C_47N_0402_X7R_K_25 | 47nF | Same value
C301 | C_15P_0402_NP0_J_50 | 15pF | 0k FOR TCXO
C302 | C_0402 | DNM
C311 | C_15P_0402_NP0_J_50 | 15pF | Same value
C321 | C_100N_0402_X5R_K_10 | DNM | FOR TCXO
C322 | C_22P_0402_NP0_J_50 | DNM | FOR TCXO
L1 | L_BEAD_102_0402 | BLM15HG102SN1 | FOR REGULATOR
L171 | L_220N_0402_J | 56nH | Frequency dependence?
L172 | L_18N_0402_J_LQW | 15nH | Frequency dependence?
L173 | L_100N_0402_J_LQW | 43mH | Frequency dependence?
L174 | L_68N_0402_J_LQW | 22nH | Frequency dependence?
L191 | L_150N_0402_J | 56nH | Frequency dependence?
L192 | L_82N_0402_J_LQW | 27nH | Frequency dependence?
L193 | L_39N_0402_J_LQW | 15nH | Frequency dependence?
L201 | L_82N_0402_J_LQW | 27nH | Frequency dependence?
P1 | SMD_SOCKET_2x10 | SFM-110-02-S-D-A-K-TR | Mechanical
P2 | SMD_SOCKET_2x10 | SFM-110-02-S-D-A-K-TR | Mechanical
P3 | SMA_SMD | SMA-10V21-TGG | Mechanical
R12 | 0 | 0 | IS XTAL SHUNT FOR EXT_XOSC
R141 | R_56K_0402_F | 56k | Same value
R171 | R_22_0402_J | 18 | Different value
R321 | DNM | DNM | NO TCXO & XTAL?
R322 | R_0_0402 | DNM | FOR TCXO
U1 | CC112X | CC120xRHB | SAME FAMILY
U2 | TPS79930 | DNM | FOR REGULATOR
X1 | X_32.000/10/20/60/10 | 40MHz | IS XTAL
X2 | TG_5021CG | DNM | IS TCXO
