OpenAir-Lab/capstone-project/Documentation/Reference Designs/Guerrilla RF/GRF-DFN6-15-23A/DFN6-15-23-A.dxf

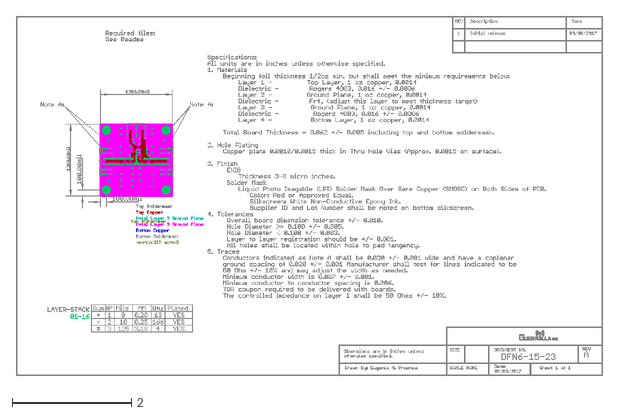
[picture p3: CAD file, 2025-10-23]
Documentation/Reference Designs/Guerrilla RF/GRF-DFN6-15-23A/DFN6-15-23-A.dxf
9.82 x 6.02
