OpenAir-Lab/capstone-project/Documentation/Reference Designs/Arduino/ABX00110-cad-files/ABX00110 DXF/ABX00110_DXF_BOTTOM ASSEMBLY.DXF

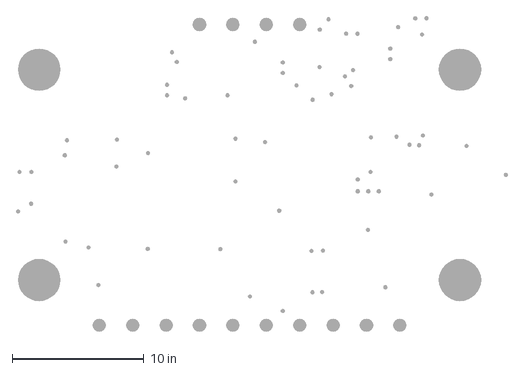
[picture p4: CAD file, 2025-10-23]
Documentation/Reference Designs/Arduino/ABX00110-cad-files/ABX00110 DXF/ABX00110_DXF_BOTTOM ASSEMBLY.DXF
37.4 x 24.0 in
