OpenAir-Lab/capstone-project/Documentation/Reference Designs/Arduino/ABX00110-cad-files/ABX00110 STEP/ABX00110.step

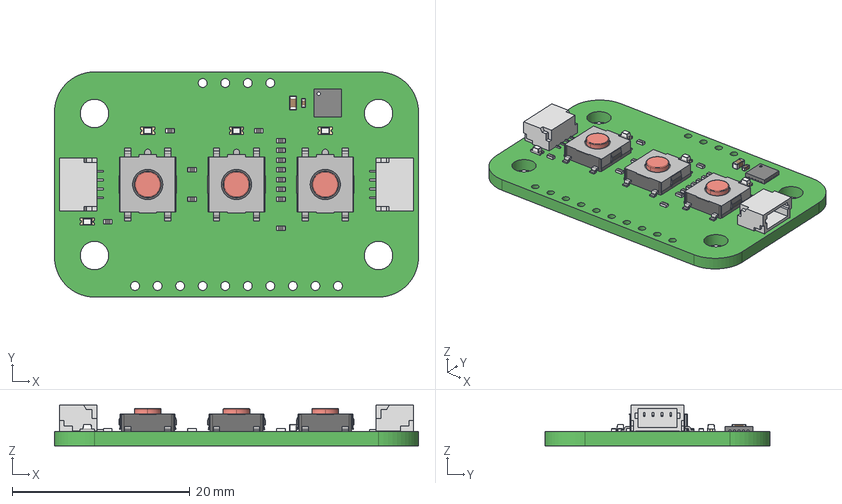
[picture p5: CAD file, 2025-10-23]
Documentation/Reference Designs/Arduino/ABX00110-cad-files/ABX00110 STEP/ABX00110.step
41.0 x 25.4 x 4.58 mm
RES-0402 x 13
CAP-0603
CAP-0402
SM04B-SRSS-TB_RGB12040119 x 2
HSMx-190 x 4
TETactileSwitch1571636 x 3
