OpenAir-Lab/capstone-project/Documentation/Reference Designs/Arduino/ABX00110-cad-files/ABX00110 DXF/ABX00110_DXF_BOTTOM SOLDER.DXF

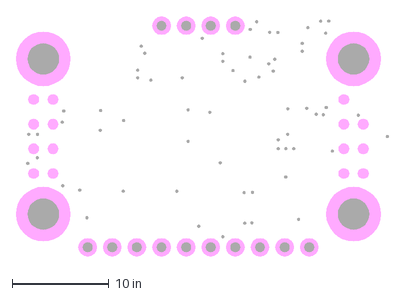
[picture p6: CAD file, 2025-10-23]
Documentation/Reference Designs/Arduino/ABX00110-cad-files/ABX00110 DXF/ABX00110_DXF_BOTTOM SOLDER.DXF
38.4 x 24.8 in
