OpenAir-Lab/capstone-project/(list of files, cad)

Other CAD files:
Documentation/Reference Designs/Guerrilla RF/QFN16-30-46-A/QFN16-30-46-A.DWG
Documentation/Reference Designs/Arduino/ABX00110-cad-files/ABX00110 DXF/ABX00110_DXF_TOP ASSEMBLY.DXF
Documentation/Reference Designs/Arduino/ABX00110-cad-files/ABX00110 DXF/ABX00110_DXF_TOP SOLDER.DXF
Documentation/Reference Designs/Arduino/ABX00110-cad-files/ABX00110 DXF/ABX00110_DXF_TOP.DXF
Documentation/Reference Designs/Arduino/ABX00110-cad-files/ABX00110 DXF/ABX00110_DXF_ALL.DXF
Documentation/Reference Designs/Arduino/ABX00110-cad-files/ABX00110 DXF/ABX00110_DXF_OUTLINE.DXF
Documentation/Reference Designs/Arduino/ABX00110-cad-files/ABX00110 DXF/ABX00110_DXF_BOTTOM.DXF
