OpenAir-Lab/capstone-project/(threads)

Thread 2 (2025-06-30):

Research and compare MCUs for project

AdrianneQuick, 2025-06-30:
I will be comparing different MCUs to use for the project. I know we want one that can operate in low power and has bluetooth capabilities. If the are more requirements or constraints I should be looking out for please comment below and let me know

ericmutton, 2025-07-01:
Along the RP2040/RP2350 route, the newly released $4 [Radio Module 2](https://www.raspberrypi.com/news/raspberry-pi-radio-module-2-available-now-at-4/) adds comprehensive wireless connectivity for the RPI SoCs.

Dominicc1, 2025-07-17:
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

Thread 3 (2025-07-01):

Research on Battery Management System

RawToast54, 2025-07-01:
Utilizing a USB-C to deliver 5V charging power to the battery. Research on the components needed to design a circuit to manage the distribution and safety measures for a lithium-ion battery.

Relevant Resources:
- [TI-BOOSTER PACK users guide](https://www.ti.com/lit/ug/slau618a/slau618a.pdf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)
- [BQ25620 User Guide](https://www.ti.com/lit/ug/sluuck2a/sluuck2a.pdf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)

BMS Datasheets:
- [BQ25620](https://www.ti.com/lit/ds/symlink/bq25620.pdf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) (3.5A)
- [BQ24250](https://www.ti.com/lit/ds/symlink/bq24250.pdf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) (2A)
- [MAX8903A](https://www.analog.com/media/en/technical-documentation/data-sheets/MAX8903-MAX8903Y.pdf) (2A)
- [BQ25611D](https://www.ti.com/lit/ds/symlink/bq25611d.pdf?ts=1752858513315) (BQ25611DRTWR) (3A)

Resource on why we use a BMS and its function/benifits:
- [How BMS ensure safety and performance](https://www.monolithicpower.com/en/learning/resources/how-lithium-ion-battery-management-systems-enhance-battery-performance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)

DigiKey Links:
- [BQ25620RYKR](https://www.digikey.com/en/products/detail/texas-instruments/BQ25620RYKR/16982067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)

ericmutton, 2025-07-02:
Here is the direct download for the [BOOSTXL-BATPAKMKII](https://software-dl.ti.com/msp430/msp430_public_sw/mcu/msp430/BOOSTXL-BATPAKMKII/latest/index_FDS.html) design files.

ericmutton, 2025-07-05:
This may also require evaluating whether to go single-cell or multi-cell.

Once the estimated power consumption of the system is known, current limits and system voltage settings can be defined in our specification.

Mobile amateur radio stations, such as those in consumer vehicles, are typically rated for 12A 13.8V supply power and output approximately 50W. In QRP applications, the ratings are lower, allowing for the use of 3.7V Li-Ion cells with lower current ratings (e.g. <10A)

RawToast54, 2025-07-19:
Current Progress on mapping and Organizing favored BMS

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

Closed 2025-09-02.

Thread 4 (2025-07-01):

Deciding on whether using a Linear Voltage Regulator or Switching Regulator

RawToast54, 2025-07-01:
Linear Reg -> Low Noise, Easy to implement, Find one with Low-Drop-Out to minimize P-loss

Switching Reg -> If we need more than 3.3V in the circuit, we will most likely need to implement a boost regulator.
                        -> High Efficiency, however, at the cost of Noise, more components

Thread 5 (2025-07-01):

Select between ESP32-WROOM and ESP32-WROVER

AdrianneQuick, 2025-07-01:
All of my MCU research for this parent and sub issue will be located in the repository called [NOTION-merge](https://github.com/OpenAir-Lab/NOTION-merge.git) in the file [MCU-info](https://github.com/OpenAir-Lab/NOTION-merge/blob/7720a083adbd99a688af0d599e59c1ee48b8a8a7/mcu-info.md)

We need to choose between ESP32-WROOM and ESP32-WROVER. I will put my comparisons in the file I linked above.

We also need to decide how much memory (flash) and PSRAM we should include with the board in order to select the right model.

AdrianneQuick, 2025-07-02:
Some questions that need to be answered:
- Will we be processing audio, doing any digital buffering, or storing modulated data streams?
- Will we have voice compression/decompression as a feature?
- Offline recordings of transmissions?
- Graphical displays & file system logs?
- Do we want to give target audience freedom to experiment?
- Digital Signal Processing done with MCU?

ericmutton, 2025-07-04:
Having an SD card or PSRAM partition readied for settings persistence and messages (i.e. images, voice recordings) could address the offline transmissions aspect of this work.

Thread 10 (2025-07-02):

Develop a subsystem block diagram for ESP32

AdrianneQuick, 2025-07-02:
In the block diagram specifically for the ESP32 subsystem it will need to show pin/function mapping, peripherals, and power sources that will be controlled (high level). Also need to include reset and boot sequence logic.

AdrianneQuick, 2025-07-17:
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

Thread 6 (2025-07-02):

Define Schematic Recapture

ericmutton, 2025-07-02:
## Scope
Describe the process of going from captured schematics and board artifacts to valid KiCAD (9.0) Project files. In doing so, existing design artifacts can be clearly included as device evaluation and prototyping commences.

- Multiple KiCAD projects must be maintained under `Hardware/KiCAD`
  - `.gitignore` must ignore all local KiCAD files to avoid 'polluted' KiCAD Projects
  -  'polluted' KiCAD projects can result in KiCAD believing files are already open on local machine when unopened.
-  Recapture process must be repeatable and possibly defined for multiple vendors

### Texas Instruments
Many devices have their evaluation board design files published in CADStar format. This will involve sourcing an archive of all corresponding designs made publicly available for download, then converting the fabrication files into an importable form for KiCAD project creation. Must seek conformity across vendors for ease of import and design evaluation.

### Espressif Systems
All SoC (System-on-Chip) Development Kits and their corresponding Modules all have publicly available design and fabrication files, going so far as including design specification for 'interposer' and 'module' development.
- 'interposer' is the board that is to be soldered to an application board that mounts the requisite devices for an ESP32 SoC to interoperate with external peripheral devices.
- 'module' is the self-contained and shielded device purchasable with an integrated [Meandering F-type Antenna](https://en.wikipedia.org/wiki/Inverted-F_antenna) for the 2.4GHz wireless connectivity.

### Raspberry Pi Foundation
Many of the Raspberry Pi families of Broadcom evaluation boards offer extensive educational-quality technical documentation with varied amounts of design files publicly published for educational use. As such, KiCAD already has symbols and footprints for much of these offerings, and recapture may be wholly unnecessary.

ericmutton, 2025-07-05:
@RawToast54 could you share your thoughts after recapturing the TI BOOSTXL-BATPAKMKII?

Closed 2025-09-02.

Thread 7 (2025-07-02):

Clarify RF Subsystems

ericmutton, 2025-07-02:
## Scope
These Radio Frequency (RF) subsystems must satisfy the definition of an amateur experiment and offer feasible uses for the RFICs selected. In doing so, this subsystem constitutes a peripheral to be interacted with by amateur radio operators.

The amateur radio subsystem must be designed for device operating frequencies in the VHF and UHF amateur radio frequency bands, 2m (144-148 MHz) and 70cm (420-450 MHz) respectively. These are both considered narrowbands.

### Radio Transceiver (TRX)
The radio transceiver must be capable of receiving and transmitting amateur radio communications in a two-way fashion. This will require putting the radio control unit in the proper modes in a real-time operating system.

The ability to flow the radio control unit through its state diagram in software will meter the firmware design artifact.

### Impedance Matching Network (Z Match)
A major design artifact will be the impedance matching network necessary for 2m operation, as Texas Instruments does not seem to offer as many EMKs for the SRD (Short Range Device) frequency band settings compared to ISM (Industrial, Scientific, and Medical) bands. There exists an evaluation board for the CC1200 at 70cm operation and a CC1120 169 MHz RF frontend that can be used in developing the required matching networks.

The efficiency of transmission and reception must be evaluated for this design artifact.

### Power Amplifier (PA)
The PA is an RFIC that must provide the amount of gain necessary to operate the radio transceiver in transmit mode at a level comparable with handheld transceivers (HTs).

The PA must be chosen to either be wideband enough to fit the two narrowbands, or there must be an RF switch network of some kind such as a single-pole-double-throw (SPDT) rated for sub-GHz operation. If a switch is required, two tuned PAs for each narrowband is possible, raising efficiency at the cost of complexity and necessary downtimes in two-way communications for switching and thus must be evaluated for effectiveness and limitation.

This artifact can be evaluated through the capability of accessing the local amateur radio repeater infrastructure including that of the TAGER tower on campus. In addition, further localized testing can be done with existing two-way radios and HTs.

ericmutton, 2025-07-02:
[RF Signal Chain Basics](https://www.analog.com/en/resources/analog-dialogue/articles/rf-signal-chain-discourse-part-2-essential-building-blocks.html)

It appears that many RFICs operate at a VDD of +5VDC. This is an additional Power Delivery Network design artifact evaluation to make, notably in including this rail at a low enough noise factor relating to RF Ground.

ericmutton, 2025-07-07:
### Clarifying Power Amplifiers

From GuerrillaRF there are a few different offerings in the following [GRF_DFN6_Solutions.pdf](https://github.com/user-attachments/files/21110559/GRF_DFN6_Solutions.pdf) document.

The [GRF2106](https://www.guerrilla-rf.com/products/detail/sku/GRF2106) is wideband and has very linear behavior which reduces the need for narrowband tuning. This very well means that just one RF frontend can be created instead of two, simplifying this subsystem down to just the transmit or receive paths.

The path switching may be handled by the TRX_SW on the transceiver side, with special consideration taken in whether the TX power amplifier can remain in-chain when in RX. This must be clarified in a revised subsystem block diagram.

The GRF-DFN6-15-23A is an evaluation board available for recapture or purchase. The [GRF2016](https://mou.sr/3xaI5A6) chip standalone is the cheapest option found thus far.

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

#### Alternatives

NXP and Mini Circuits are other vendors that offer devices with similar specifications to those I have found in discovery.

NXP [MMZ09332BT1](https://mou.sr/4eunRCE) and Mini Circuits [GALI-74+](https://mou.sr/4kGBSzR)

Closed 2025-08-19.

Thread 9 (2025-07-02):

Build Pin Mapping Table

AdrianneQuick, 2025-07-02:
GPIOs will need to be allocated for:

- [ ] SPI interface (CC1200)
- [ ] UART for logging & debug
- [ ] GPIOs for PA control, buttons, status LEDs
- [ ] SPI or I2C for LCD

Also, it is important to be aware of any pin conflicts for bootstrapping purposes. Keep this in mind when allocating the pins

Thread 11 (2025-07-03):

Clarify Physical Subsystems and Their Purposes

ericmutton, 2025-07-03:
### Scope
The complete system to design is comprised of several peripherals connected to a microcontroller.
- The power supply shall communicate with the microcontroller any information regarding the status of the battery management system.
- The microcontroller shall handle any peripheral digital signals through a General Purpose Input/Output (GPIO) expander to ensure that the MCU's GPIO Multiplexer (MUX) can prioritize communications interfaces.
- The audio subsystem shall allow for the use of [Pulse-Code Modulated (PCM)](https://en.wikipedia.org/wiki/Pulse-code_modulation) audio for both source and sink to minimize signal conversions.
- The human-machine interface shall inform the end-user of the state of the system and enable the reconfiguration of subsystems into different operating modes.
- The amateur radio subsystem shall allow two-way ham radio communications on a selected one of two narrow frequency bands ranged for repeater access.

### Outcomes
By clarifying each physical subsystem and their purpose, each subsystem can then begin the **sourcing process** for parts that satisfy their specified requirements. Thus a project **Bill of Materials (BoM)** can be generated.

A BoM can be generated through the use of **KiCAD schematic capture** of device reference designs and application circuit diagrams from device datasheets.

Thread 12 (2025-07-03):

Clarify Firmware Requirements and Constraints

ericmutton, 2025-07-03:
### Scope
Firmware requirements shall be based upon the state diagrams of peripherals with communications interfaces throughout all subsystems. Devices with error handling considerations must be given priority.

Firmware constraints shall be made in good consideration of specifications outlined in the selected device's datasheet defined in task #2.

### Outcomes
With firmware requirements and constraints defined, design work can begin on writing the software artifacts including the firmware to be uploaded to the primary microcontroller defined in task #2.

Closed 2025-09-02.

Thread 13 (2025-07-03):

Clarify Audio Subsystem

Dominicc1, 2025-07-03:
Network and Data Communication Protocol base on Range, Latency, Bandwidth, Security, Power Consumption
[DFR0954](https://mou.sr/3U2zFTo) I2S for Speaker

Dominicc1, 2025-07-15:
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

Dominicc1, 2025-07-15:
https://wiki.dfrobot.com/SKU_DFR0954_MAX98357_I2S_Amplifier_Module,
https://piembsystech.com/i2s-protocol-framing-working-applications/,
https://www.robotics.org.za/DFR0954
https://diyi0t.com/i2s-sound-tutorial-for-esp32/
https://learn.adafruit.com/adafruit-max98357-i2s-class-d-mono-amp/overview
https://www.amazon.com/PAM8403-Channel-Amplifier-Envistia-Mall/dp/B07N12VPTS
https://www.atomic14.com/videos/posts/lgDu88Y411o

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
PAM8403 Mini 2 Channel 3W Stereo Class D Audio Power Amplifier 3W+3W
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
Adafruit MAX98357 I2S Class-D Mono Amp
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
DF Robot MAX98357A I2S Amp Module

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

Dominicc1, 2025-07-18:
https://web.ece.ucsb.edu/Faculty/rodwell/Classes/ece2c/labs/lm386.pdf
LM386

AdrianneQuick, 2025-07-18:
@Dominicc1 will you please start adding more comments written by you into this so that I can better understand what you are doing. I see a lot of links and images but I don’t know why each one is there or what to pay attention to. It  will help me organize everything better if you stay on top of commenting and documentation please and thank you!

Closed 2025-09-02.

Thread 16 (2025-07-15):

Clarify RF Power Amplifier

ericmutton, 2025-07-15:
### Scope

From GuerrillaRF there are a few different offerings in the following [GRF_DFN6_Solutions.pdf](https://github.com/user-attachments/files/21110559/GRF_DFN6_Solutions.pdf) document.

The [GRF2106](https://www.guerrilla-rf.com/products/detail/sku/GRF2106) is wideband and has very linear behavior which reduces the need for narrowband tuning. This very well means that just one RF frontend can be created instead of two, simplifying this subsystem down to just the transmit or receive paths.

The path switching may be handled by the TRX_SW on the transceiver side, with special consideration taken in whether the TX power amplifier can remain in-chain when in RX. This must be clarified in a revised subsystem block diagram.

The GRF-DFN6-15-23A is an evaluation board available for recapture or purchase. The [GRF2106](https://mou.sr/3xaI5A6) chip standalone is the cheapest option found thus far.

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

#### Alternatives

NXP and Mini Circuits are other vendors that offer devices with similar specifications to those I have found in discovery.

NXP [MMZ09332BT1](https://mou.sr/4eunRCE) and Mini Circuits [GALI-74+](https://mou.sr/4kGBSzR)

ericmutton, 2025-07-16:
GuerrillaRF has an [application note](https://www.guerrilla-rf.com/support/application/notes/amp-power-up-down-procedures) on power up and power down procedures for their RF amplifiers.

ericmutton, 2025-09-01:
This issue may be revisited throughout the semester as this amplifier currently does not have any publicly available S parameters. Given our current equipment capabilities, S11 and S22 parameters can be created with advice from Dr. Lehmann's office hours and Dr. Henderson's coursework.

Thread 21 (2025-07-19):

Power Supply System

CURAC, 2025-07-19:
The power supply unit for this project is a smart charging and power management system. It is designed to safely and efficiently power the HAM radio from a universal USB-C SOURCE while managing the internal battery.

Its function entails three key operations:
  1. **Intelligent Negotiation**: Using a USB Power Delivery (PD) controller, the unit communicates with a USB-C charger to request a higher voltage (e.g., 12 V or 15 V) needed for the radio's circuits
  2. **Power Conversion & Charging**: It takes the negotiated high voltage and uses an efficient buck-boost converter to charge the internal Li-ion battery pack.
  3. **System Power Management**: It features a "Power Path" that allows the radio to be powered directly from the USB-C source, even if the battery is completely drained, ensuring uninterrupted operation while charging.

The following parts make up a part of the power supply. A sample BOM for visualization has been added below

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

ericmutton, 2025-07-22:
I restructured this power supply issue as a parent issue for all research tasks regarding power.

@CURAC you mention the use of a different battery management system than the BQ25620 described in research task #3, the [BQ25792](https://www.ti.com/product/BQ25792). @RawToast54 what are your thoughts on this?

RawToast54, 2025-07-31:
USB-PD IC's

- [TPS25762-Q1](https://www.ti.com/lit/ds/symlink/tps25762-q1.pdf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)
- [TPS25751 ](https://www.ti.com/lit/ds/symlink/tps25751.pdf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)

ericmutton, 2025-08-19:
@RawToast54 please let me know if you need assistance finishing the symbol and footprint import for your BMS recapture. Make sure to use the [system-testbed](https://github.com/OpenAir-Lab/capstone-project/tree/system-testbed) branch. https://github.com/OpenAir-Lab/capstone-project/commit/53f1a9e2cd4bad450e87ae31cc7b78fd570bf8c6

Thread 26 (2025-07-22):

Battery Selection and Safety Guides

RawToast54, 2025-07-22:
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

 _Originally posted by @RawToast54 in [#3](https://github.com/OpenAir-Lab/capstone-project/issues/3#issuecomment-3102938063)_

Thread 29 (2025-08-11):

Research On Modular System Compatibility

ericmutton, 2025-08-11:
## Scope

Here is an introduction of the [Adafruit Stemma QT/SparkFun Qwiic](https://learn.adafruit.com/introducing-adafruit-stemma-qt/sparkfun-qwiic) I2C prototyping system. Many I2C-based modules have been created by vendors implementing these 4-pin connectors.

The Arduino [Plug and Make Kit](https://store-usa.arduino.cc/products/plug-and-make-kit) is a popular example of a kit with guided tutorials for pluggable modules using Stemma QT/Qwiic called "Modulinos." **Notably, this approach is namely for exploring I2C devices.**

Here is some quality Arduino [documentation](https://docs.arduino.cc/resources/datasheets/ABX00110-datasheet.pdf) describing one "Modulino."

Adafruit sells the [connectors, cables, and accessories](https://learn.adafruit.com/introducing-adafruit-stemma-qt/featured_products) for implementation.

For other communication interfaces, this connector should be avoided for risk of hardware incompatibility. This must also exclude [SeeedStudio Grove](https://wiki.seeedstudio.com/Grove_System/#interface-of-grove-modules) connectors. **This means investigating alternatives for SPI and I2S due to a mismatch of signal count and pin count.**

Thread 30 (2025-08-14):

Workflow Runthrough

RawToast54, 2025-08-14:
A sitdown so that we have consistency in our circuit/PCB designs

AdrianneQuick, 2025-09-02:
I would like to suggest we begin learning about kicad as a group. Perhaps we begin a tips and tricks document and we start familiarizing ourselves with it   in today’s working session (09.02.25)

Thread 43 (2025-08-14):

PSU PCB Testing

RawToast54, 2025-08-14:

RawToast54, 2025-09-02:
Testing Battery stabilization, output voltage, regulation control, communication, Batt level reading, charging.

Thread 53 (2025-09-02):

MCU Pin Mapping and Interconnects

AdrianneQuick, 2025-09-02:
This is where we are deciding how the MCU will physically talk to everything else.

This includes:
- Defining the subsystem interconnects
- Pin mapping
- Bootstrapping requirements

Here are the peripherals/subsystems we need to connect:
- CC1200 (SPI, GDO interrupts, reset pin) [forum discussing CC1200 GDO pin](https://e2e.ti.com/support/wireless-connectivity/sub-1-ghz-group/sub-1-ghz/f/sub-1-ghz-forum/399163/cc1200-and-gdo-pin-for-pa-lna-control)
- Dispay(TFT) (SPI)
- Keypad Matrix & Roatary Encoder (GPIO)
- BMS & Fuel Guage (I2C)
- Programming/Debug (UART, JTAG header, EN/reset lines)
- Audio(mic & speaker) (I2S)

AdrianneQuick, 2025-09-03:
| Bus/Subsystem | Signal | ESP32 GPIO | Notes |
|--------|--------|--------|--------|
| VSPI —> CC1200 | SCLK | GPIO18 | reliable at high speeds |
| | MOSI | GPIO23 |  |
|  | MISO | GPIO19 |  |
|  | CS | GPIO32 |  |
|  | GDO0(IRQ) | GPIO34 | interrupt |
|  | GDO2(IRQ) | GPIO35 | second interrupt line |
| HSPI —> TFT Display | SCLK | GPIO14 |  |
| | MOSI | GPIO13 |  |
| | MISO | -- | TFT doesn’t need MISO (for writing on SD card) leave NC |
| | CS | GPIO04 | separate CS from radio |
| | DC | GPIO26 | data/command |
| | RST | -- | tie to 3V3 w/RC or to board’s reset |
| I2C —> BQ25620 + I/O Expander + STUSB4500| SDA | GPIO21 | shared bus - use 4.7-10 kΩ pull-up resistor |
| | SCL | GPIO22 | |
| | Expander INT| GPIO39 | wakes HMI task on change |
| | STUSB4500 ALERT | GPIO38 | open‑drain, pull‑up to 3V3, PD event interrupt |
| I2S —> Audio (full-duplex) | BCLK | GPIO27 | connect to Mic SCK + Amp BCLK, one clock for both devices |
| | LRCLK/WS | GPIO25 | connect to Mic WS + Amp LRCLK, shared LRCLK/WS  |
| | DOUT (ESP32—>Amp) | GPIO33 | connected to MAX98357A DIN, no MCLK needed |
| | DIN (mic—>ESP32) | GPIO36 | connected to CS‑43434 SD, no MCLK needed |
| HMI encoder | A/B | -- | put both phases on expander, INT—>GPIO39 |
| Keypad | Rows/cols | -- | entire matrix on expander, INT—>GPIO39 |
| Debug UART | TX0 / RX0 | GPIO1/GPIO3 | keep default for logs/CLI |

Avoid boot strapping pins (GPIO0/2/5/12/15). GPIO34–39 are input‑only. WROVER modules reserve GPIO16/17 internally for PSRAM

Thread 57 (2025-09-02):

Recapture Modulino for Templating

ericmutton, 2025-09-02:
Using the Adafruit and Arduino documentation for Modulinos and Adafruit Stemma QT/SparkFun Qwicc, a blank Modulino PCB design file must be made available.

ericmutton, 2025-09-02:
Regarding the EYESPI connector on the [Adafruit EYESPI Breakout Board](https://learn.adafruit.com/adafruit-eyespi-breakout-board%20breakout%20board) referenced in the following:
- #29
- #34
- #33

The SMT, 18-pin, 0.5mm pitch FPC connector recommended by an [Adafruit Forums Admin](https://forums.adafruit.com/viewtopic.php?t=219305) is the DigiKey [687118149022](https://www.digikey.com/en/products/detail/w%C3%BCrth-elektronik/687118149022/5047793).

This connector will need to be put in the MCU (2x), RF (1x) and HMI (1x) for utilizing the SPI interfaces of the devices and peripherals used in these subsystems.

ericmutton, 2025-09-04:
Here is a mockup of a Modulino for the #32 so far. I need help finding what connector would make sense to use for the I2S interface (3 pins) #29

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

Thread 59 (2025-09-02):

Testing PSU Output Voltage (Regulation control)

RawToast54, 2025-09-02:
Measuring the voltage seen at the output of the power supply. Here we expect to see a stable 3.3V.
Also here we can test the efficiency of the system.

Thread 60 (2025-09-02):

Design MCU PCB

AdrianneQuick, 2025-09-02:
Use Modulino format see #57

AdrianneQuick, 2025-09-04:
@ericmutton Would an 8bit one be too little?

ericmutton, 2025-09-04:
No, not at all, especially if we have on on each Modulino. For reference the keypad matrix being 4x4 needs a port (8 bits) exactly. Port 2 of the 16-bit one is so far the three DIO for the rotary encoder, so a 16-bit one is almost perfect for #33

ericmutton, 2025-09-04:
Heads up that the volume control may need to be on the #63 seeing as it is an analog signal. However, according to GROVE system compatibility #29 the I2C pins of a third Adafruit Stemma QT connector could be repurposed as Analog IO pins. Or we can do what [Arduino Knob](https://store-usa.arduino.cc/products/modulino-knob) board did but for a potentiometer.

Thread 62 (2025-09-02):

Power Budget

CURAC, 2025-09-02:
Please input the power consumption of your modules in the table below. This will help in deciding which regulators to use among other safety considerations.

| Module| Voltage rail | Current (Rx Mode) | Current (Tx Mode) | Assigned To|
| :--- | :--- | :--- | :--- | :--- |
| `RF Module (PA)` | +5 V|_ |_|`@ Eric`
| `RF Module (LNA)` | * |_ |_ |`@ Eric`
| `Wrover Module` | +3.3 V| _ |_ |`@ Adrianne`
| `Audio Module` | +3.3 V| _|_| `@ Dominic`
| `HMI Module` | +3.3 V | _ |_|`@ Eric/Adrianne`

Thread 64 (2025-09-03):

Outline FreeRTOS task architecture

AdrianneQuick, 2025-09-03:
For this we are deciding what runs, how often, at what priority, how pieces talk to each other, and how hardware ISRs hand work to tasks.

What this entails (concrete deliverables):
- Task list & priorities (radio, HMI, power, logging, plus system services).
- Timing model: which tasks are periodic vs. event-driven, and their periods.
- Comms map: queues, stream buffers, and event groups between tasks.
- Driver/ISR handoff plan: exactly what each ISR does and which queue/event it pokes.
- Shared-bus arbitration: SPI/I²C mutex plan and device handles.
- Memory & stack sizing: initial stack sizes, queue depths, and where PSRAM is used.
- Fail-safes: watchdog, brownout & error reporting path.

Thread 66 (2025-09-04):

Review Hardware Design Guidelines for ESP32

AdrianneQuick, 2025-09-04:
In order to build a schematic for the WROVER, I will first need to familiarize myself with the hardware guidelines for the ESP32 when designing a board for it  .

The guidelines can be found [here](https://docs.espressif.com/projects/esp-hardware-design-guidelines/en/latest/esp32/index.html)
