OpenAir-Lab/capstone-project/Hardware/KiCAD/system-testbed/system-testbed.pdf

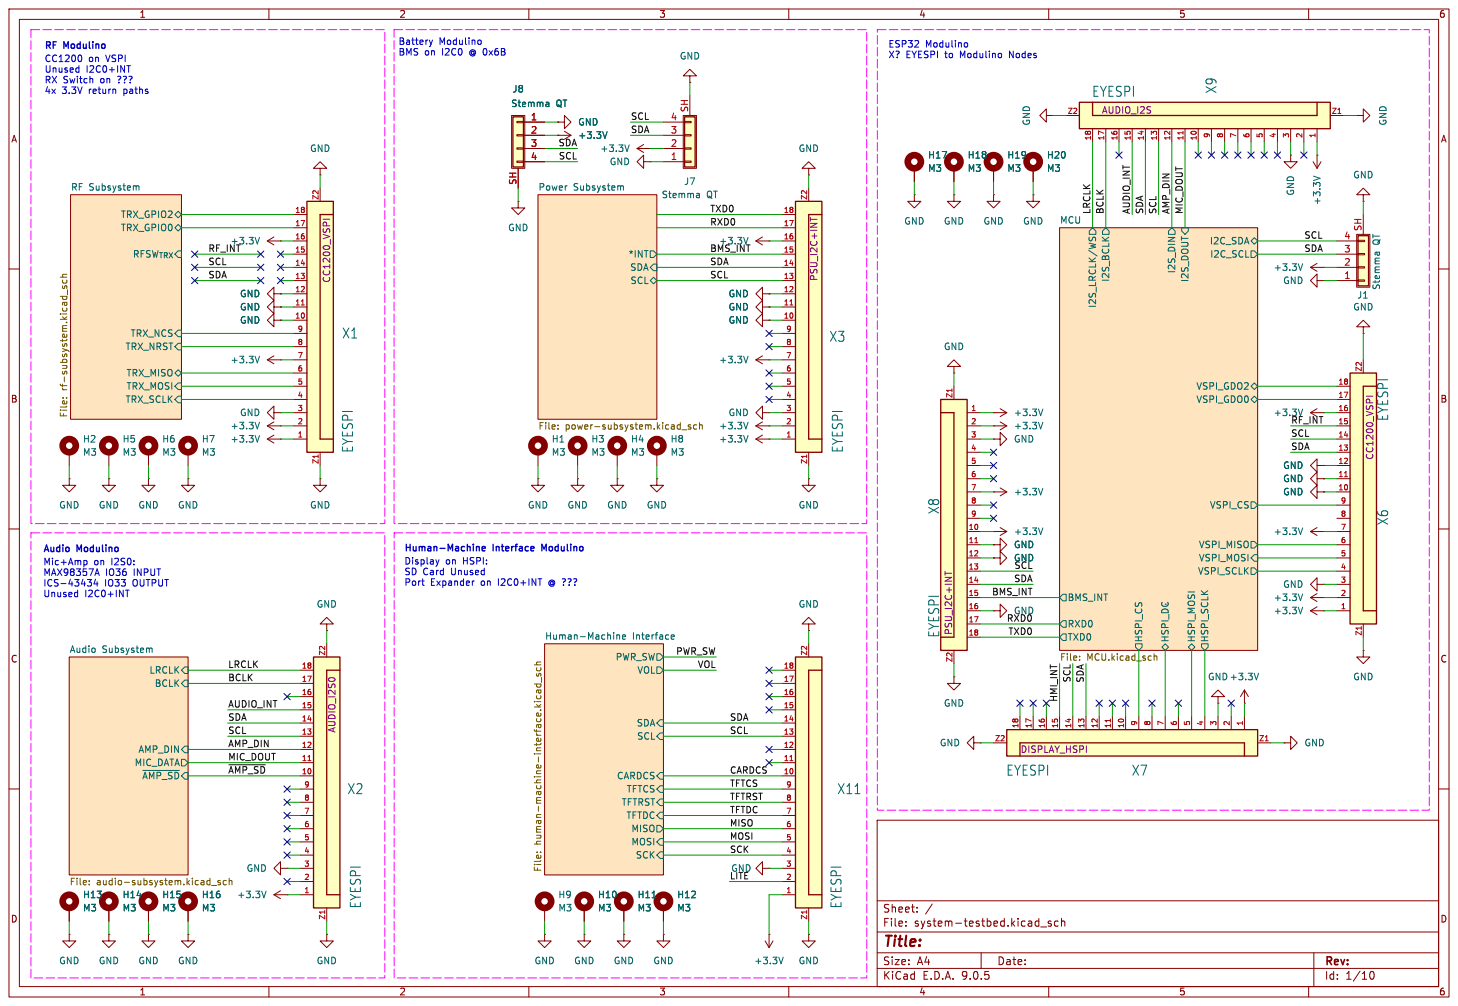
[picture p7: page 1]

RF Modulino CC1200 on VSPI Unused I2C0+INT RX Switch on ???

Battery Modulino BMS on I2C0 @ 0x6B

VOL
TFTCS CARDCS SCL SDA

Id: 1/10 Title: File: system-testbed.kicad_sch Sheet: /

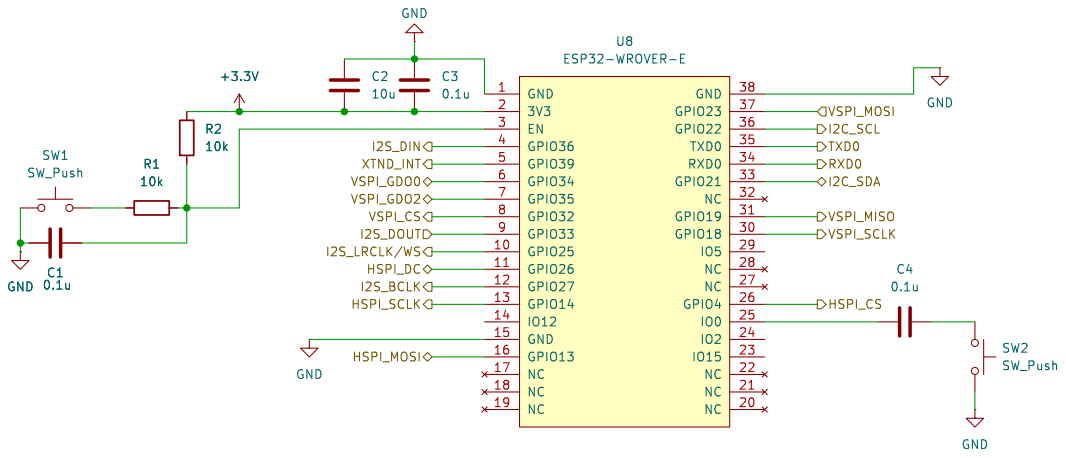
[picture p8: page 2]

Id: 2/10 Title: File: MCU.kicad_sch Sheet: /MCU/

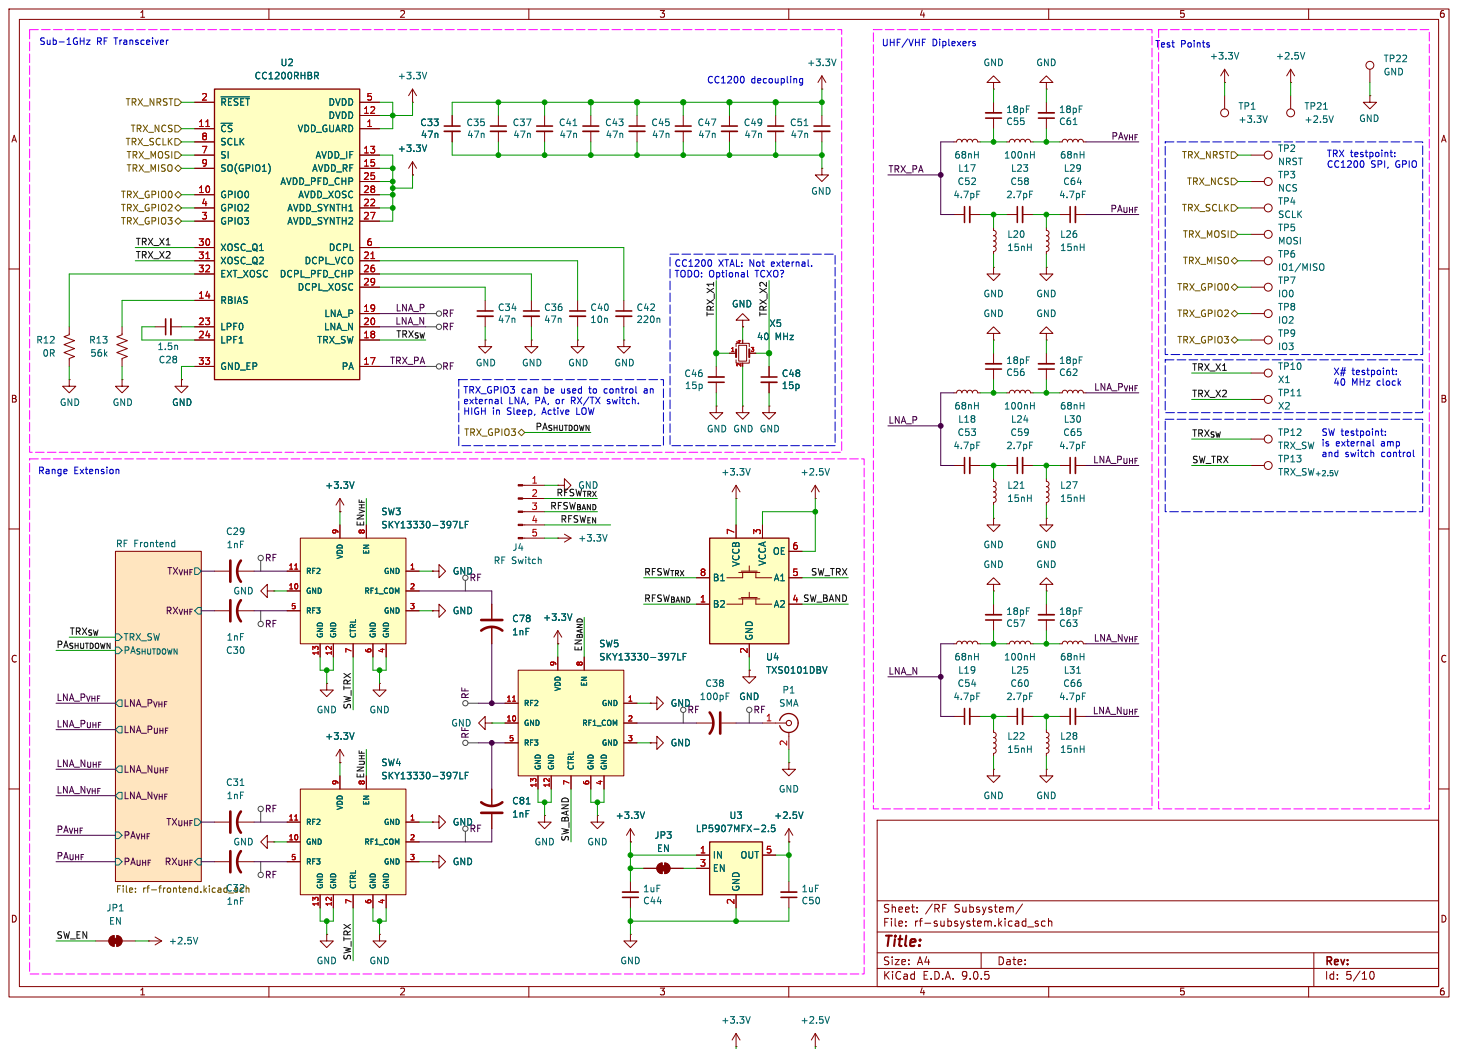
[picture p9: page 3]

RF Frontend File: rf-frontend.kicad_sch

9 GND 12 GND 13 RF2 11 GND 10 GND GND

9 GND 12 GND 13 RF2 11 GND 10 SW4 SKY13330-397LF OE 6 A1 5 A2 4 VCCA

9 GND 12 GND 13 RF2 11 GND 10 SW5 SKY13330-397LF GND

9 GND 12 GND 13 RF2 11 GND 10 GND

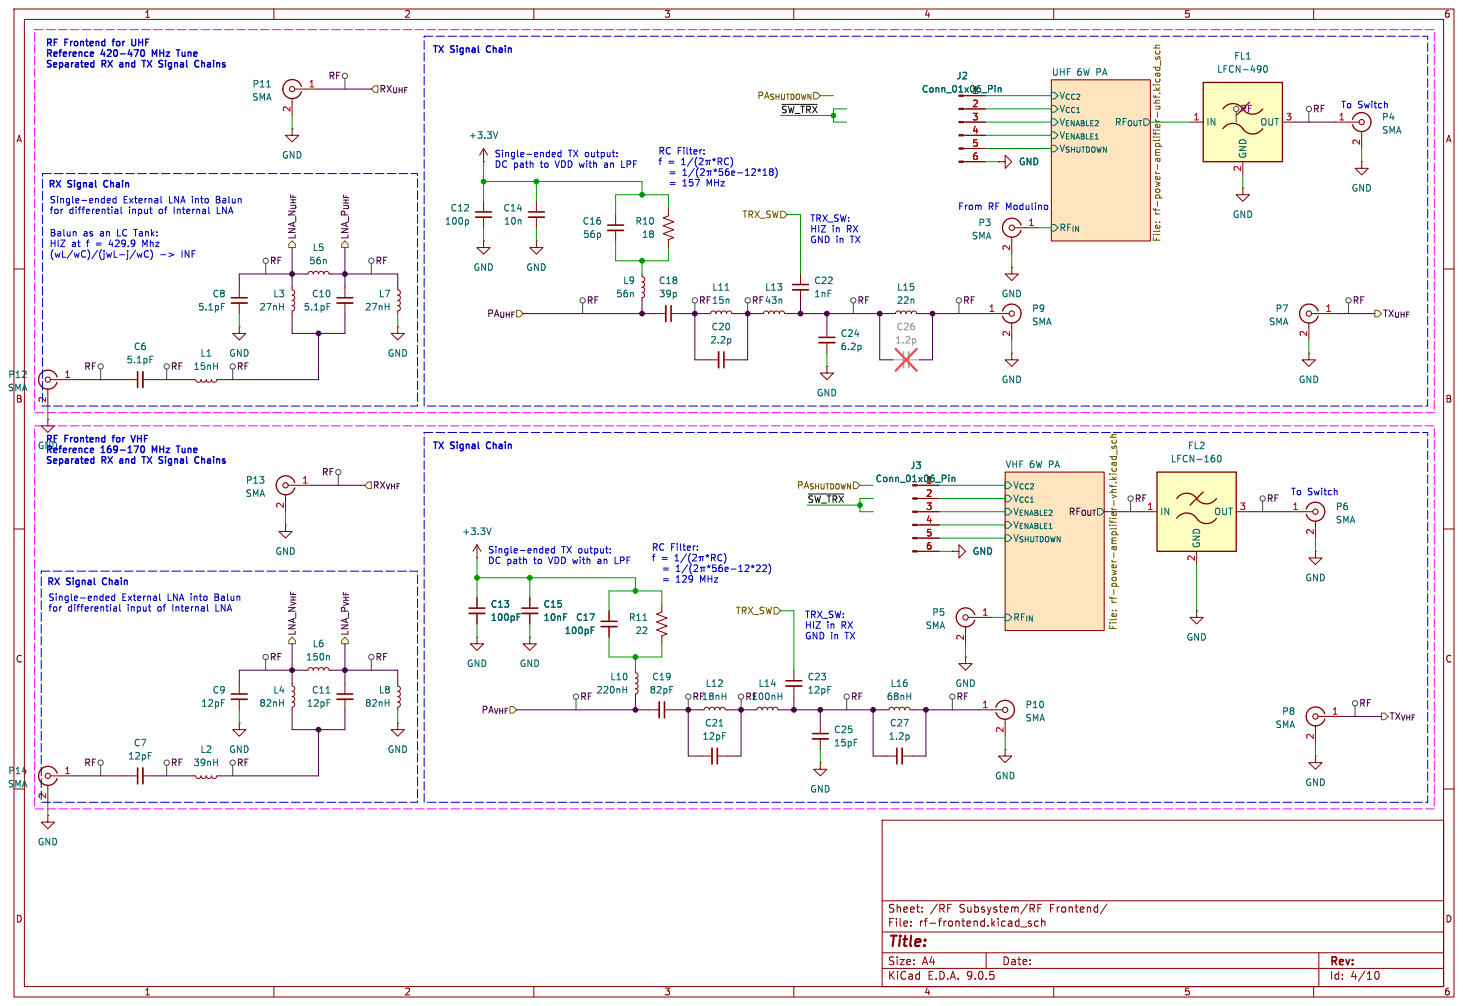
[picture p10: page 4]

TX Signal Chain Balun as an LC Tank: HIZ at f = 429.9 Mhz

From RF Modulino RX Signal Chain

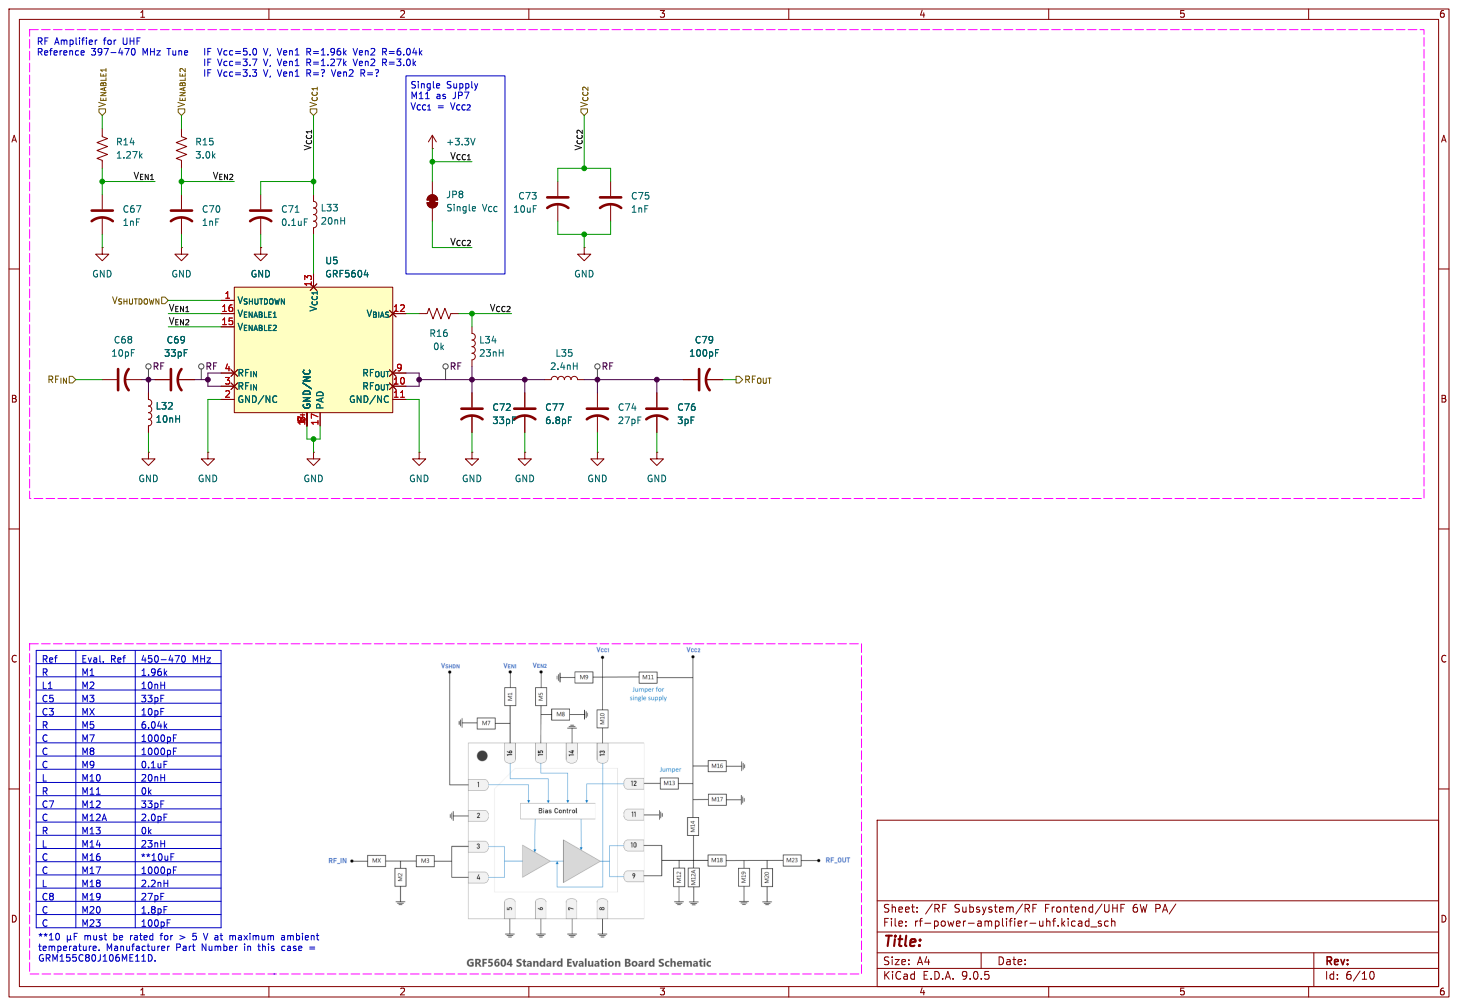
[picture p11: page 5]

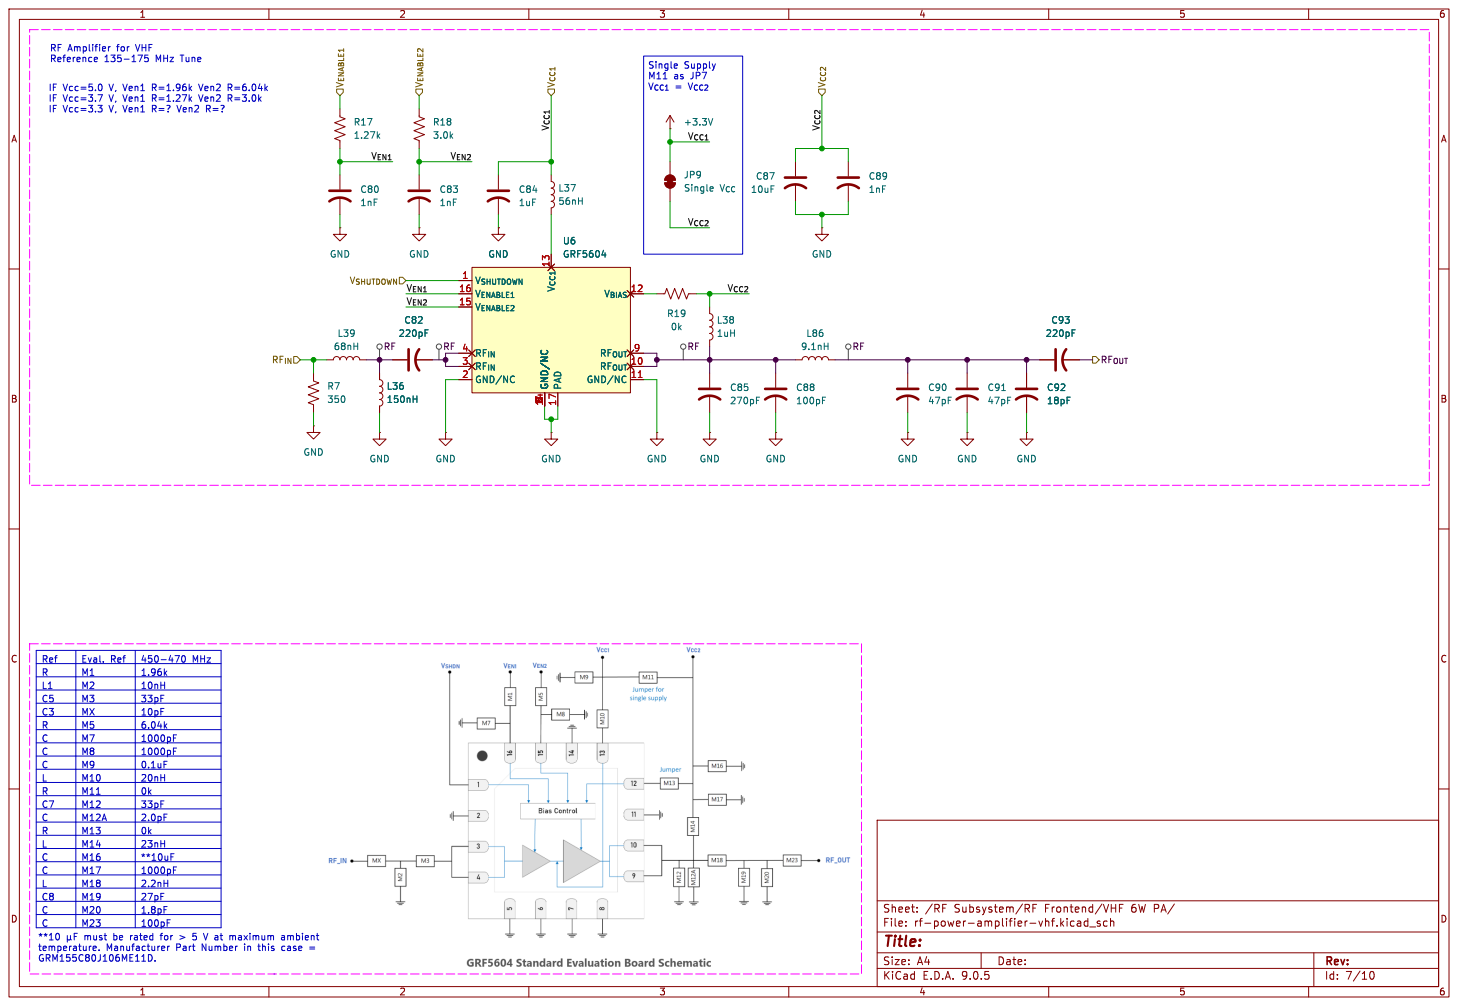
[picture p12: page 6]

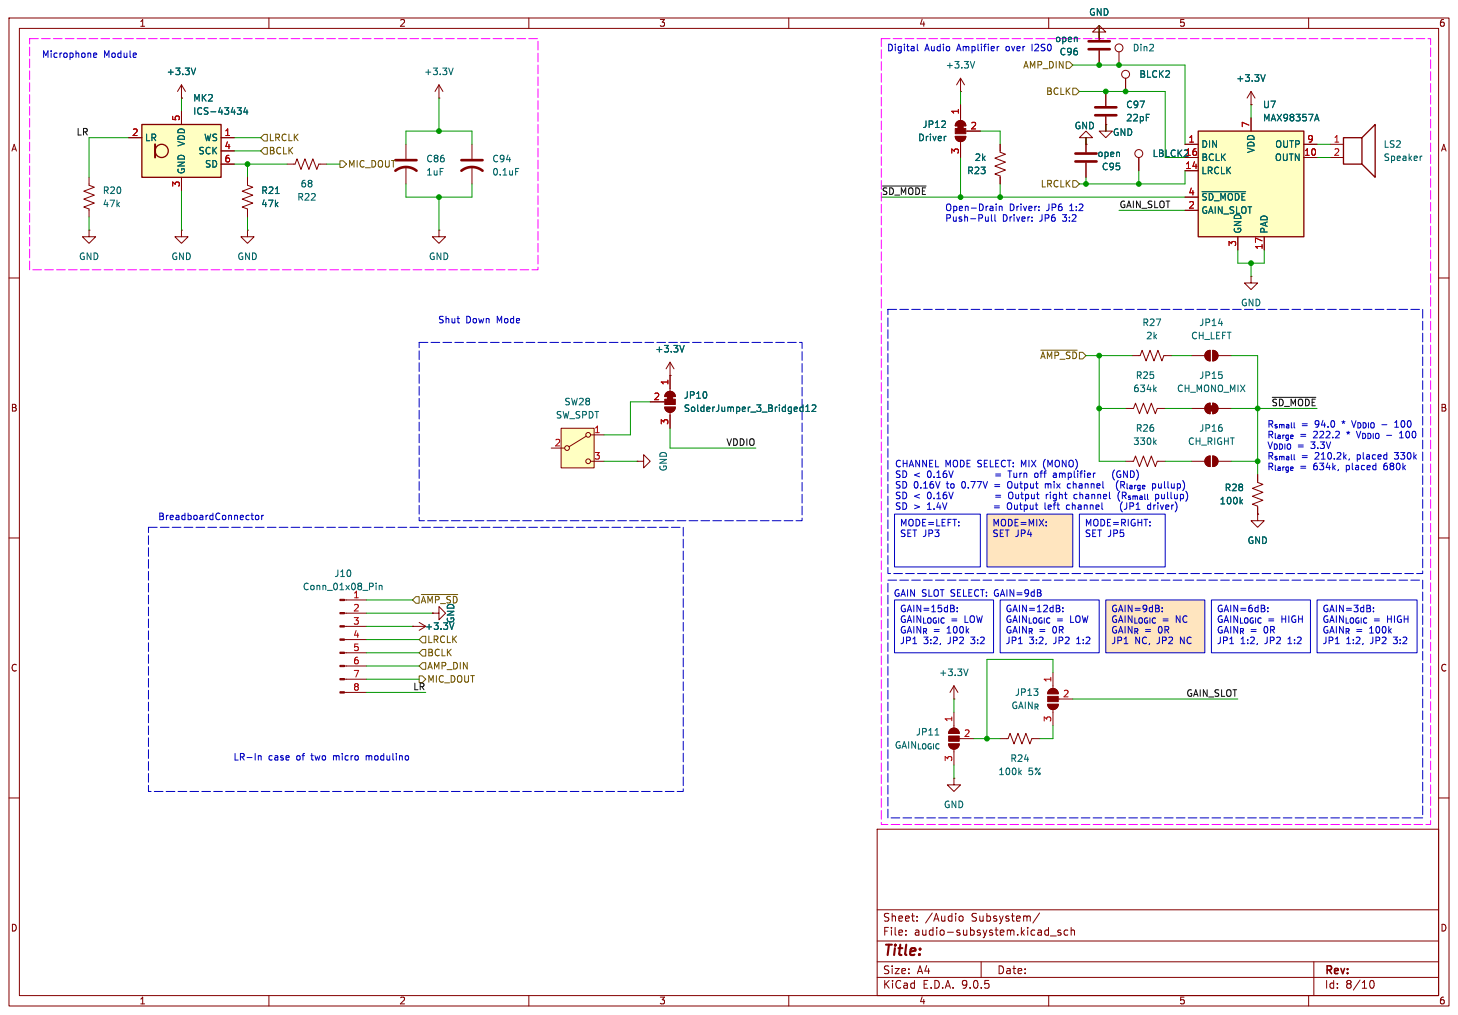
[picture p13: page 7]

7 PAD 17 OUTP 9 OUTN 10 GND

JP1 1:2, JP2 3:2 MODE=RIGHT: SET JP5 GAIN SLOT SELECT: GAIN=9dB

JP1 3:2, JP2 1:2 MODE=MIX: SET JP4 GAIN=15dB: GAIN_{LOGIC} = LOW

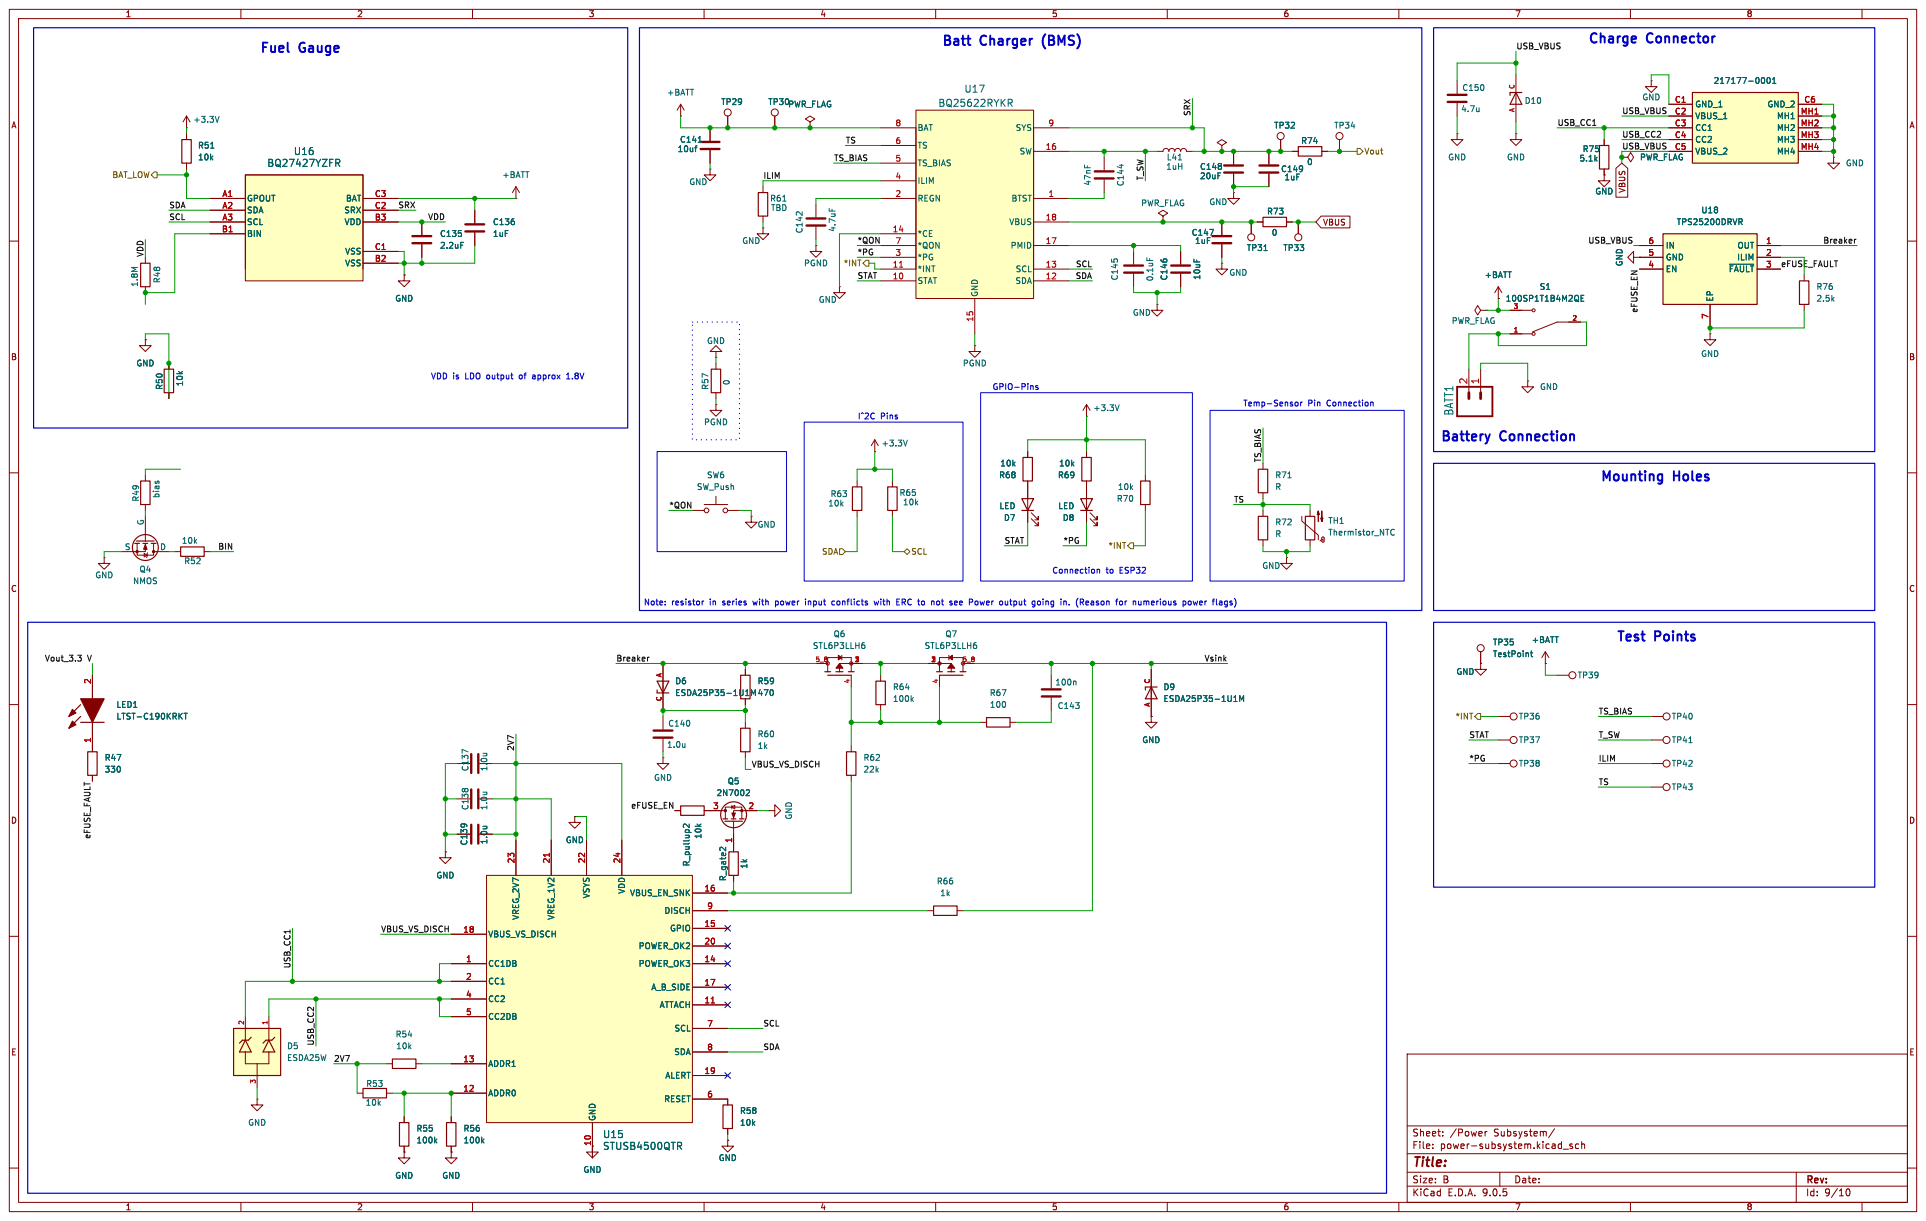
[picture p14: page 8]

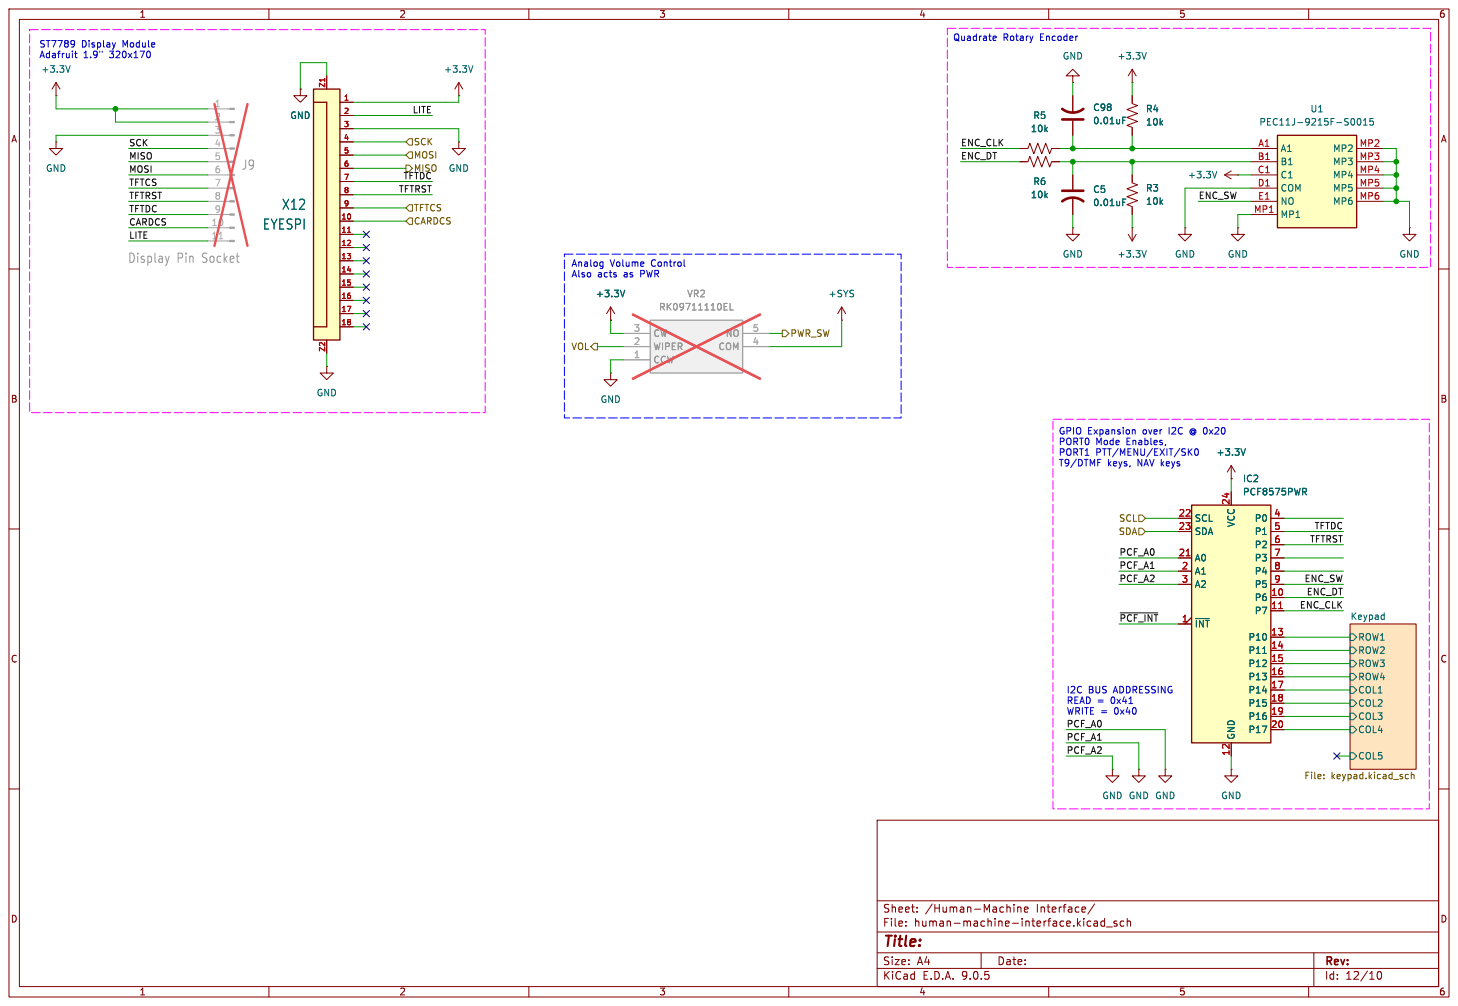
[picture p15: page 9]

VOL MOSI SCK CARDCS MISO

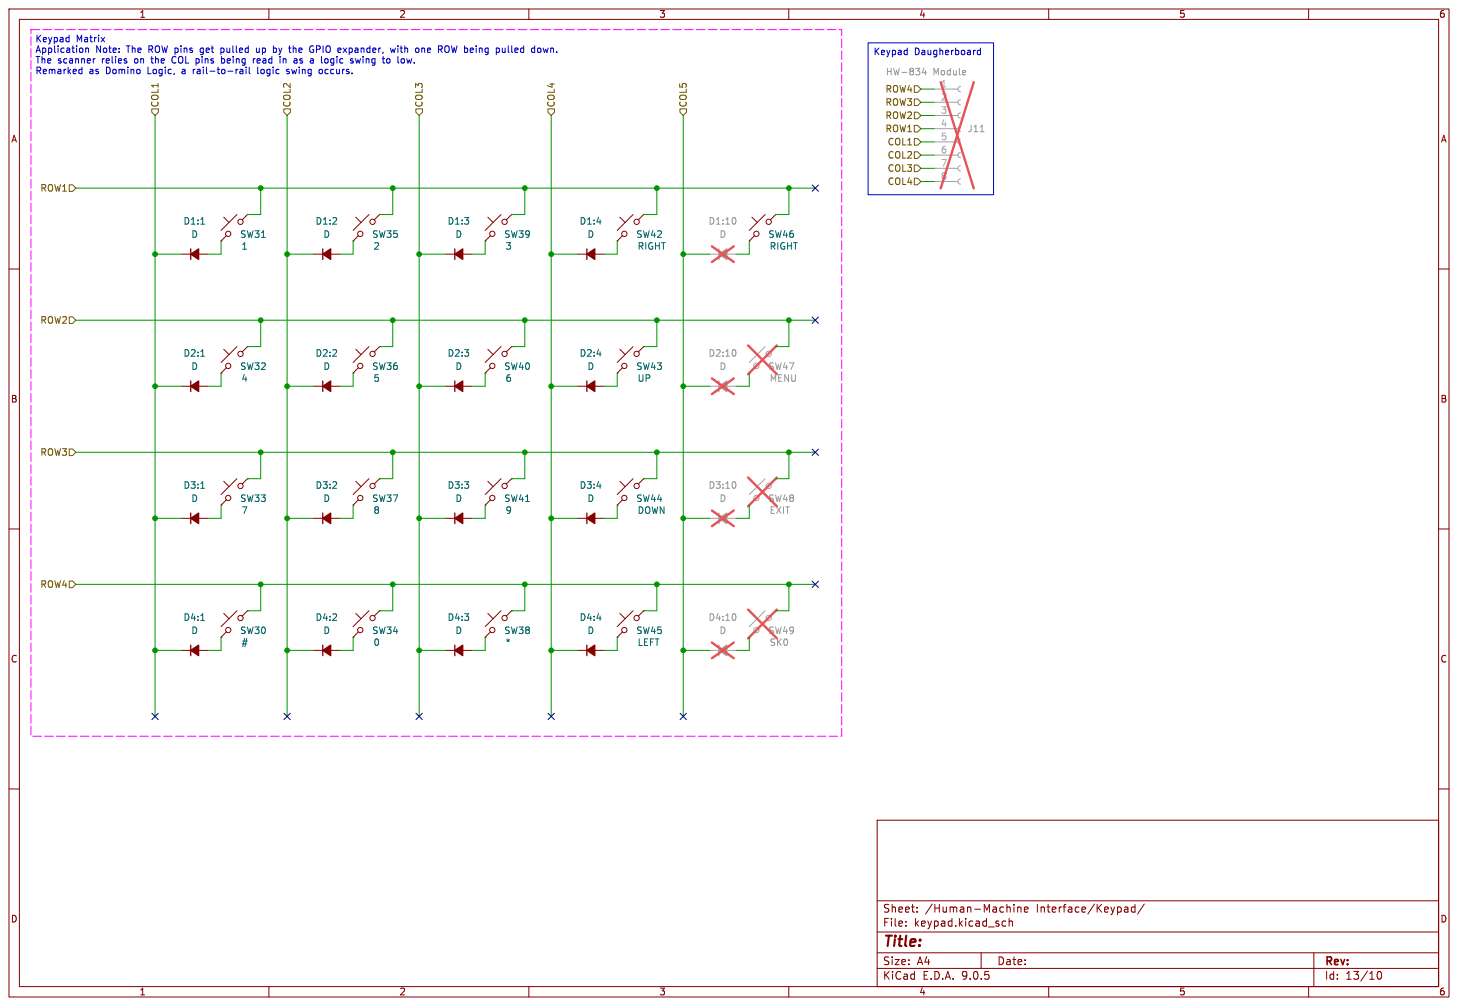
[picture p16: page 10]
