OpenAir-Lab/capstone-project/Documentation/Reference Designs/Guerrilla RF/GRF-DFN6-15-23A/GRF-DFN6-15-23A.pdf

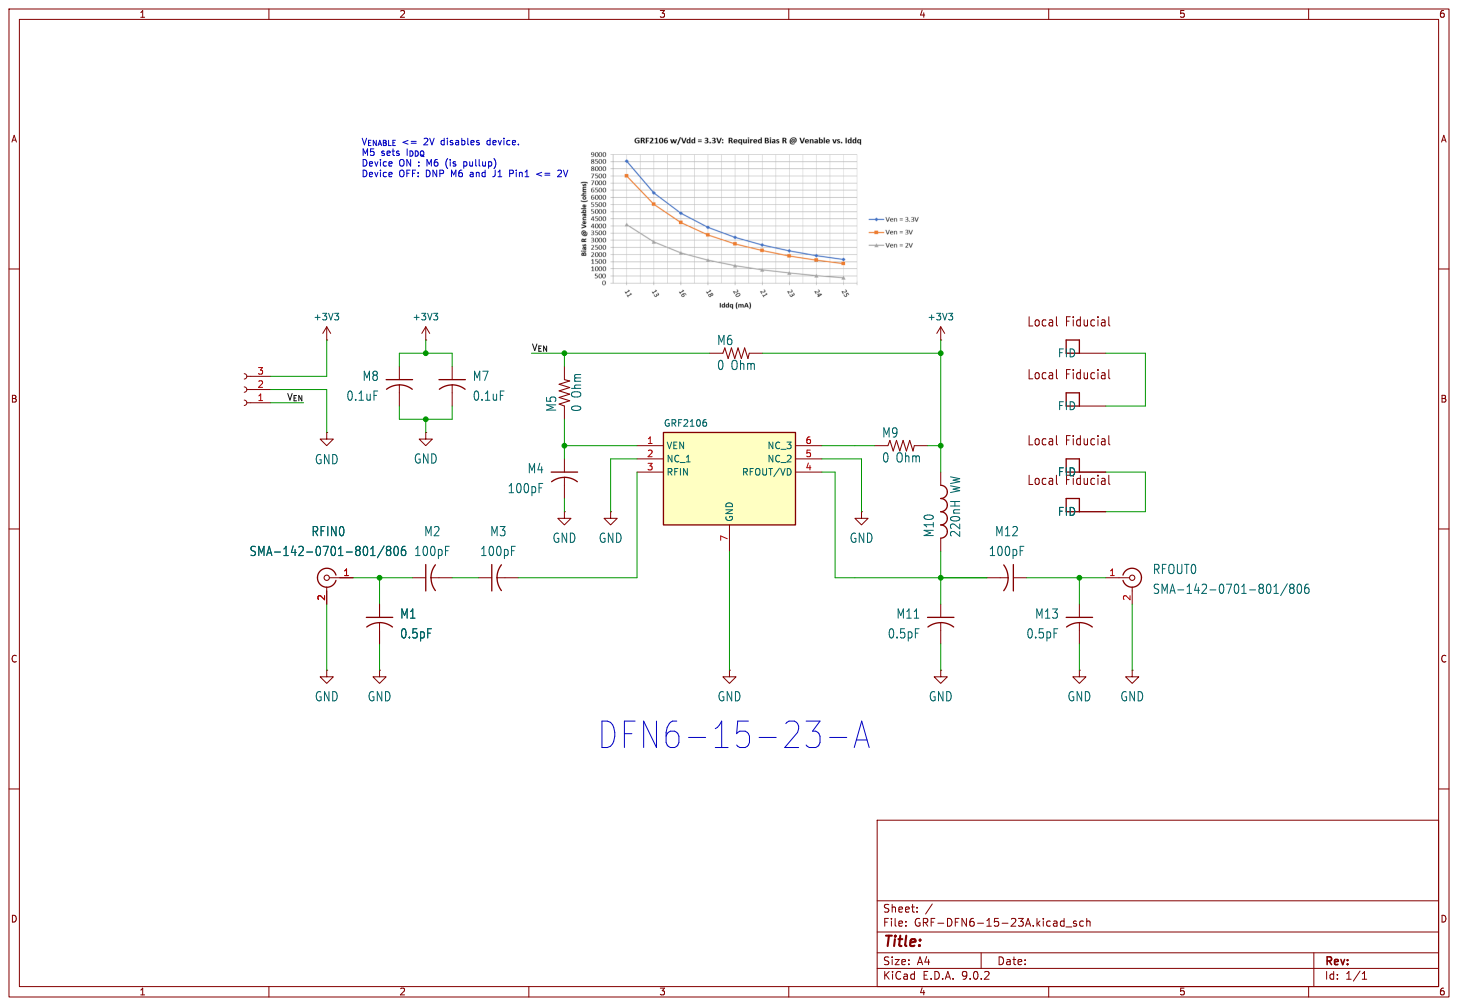
[picture p17: page 1]

Id: 1/1 Title: File: GRF-DFN6-15-23A.kicad_sch Sheet: /
