OpenAir-Lab/capstone-project/Documentation/RF Subsystem/Radio Transceiver/cc1200/CC120XEM_420_470_schematic_1_1_0.pdf

## L1 is a Bead to be mounted if the regulator U2 and capacitors C12 and C41 are not mounted. By

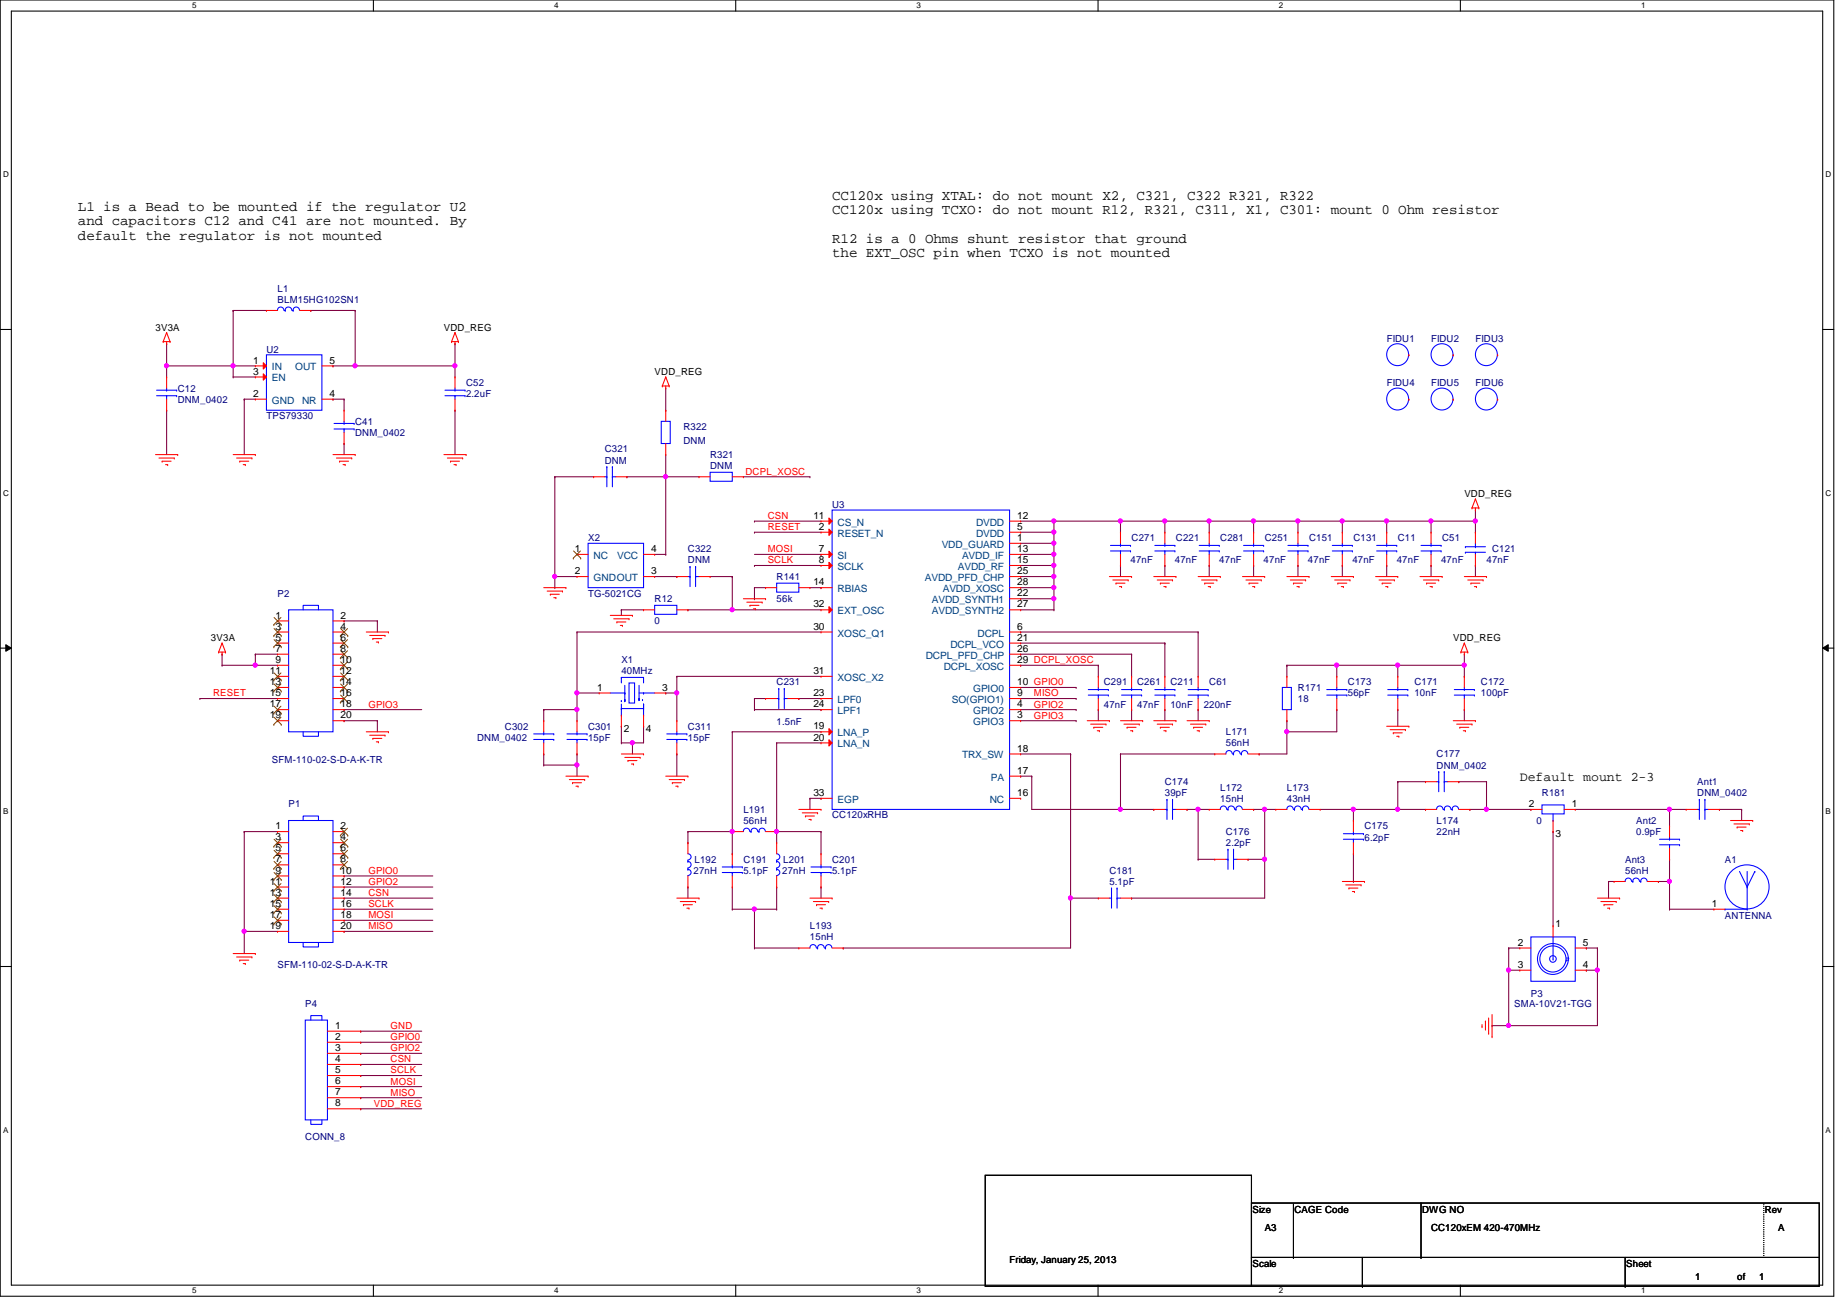
[picture p18: page 1]

CC120x using XTAL: do not mount X2, C321, C322 R321, R322
CC120x using TCXO: do not mount R12, R321, C311, X1, C301: mount 0 Ohm resistor
R12 is a 0 Ohms shunt resistor that ground
the EXT_OSC pin when TCXO is not mounted

default the regulator is not mounted
