OpenAir-Lab/capstone-project/Documentation/RF Subsystem/Radio Transceiver/swrr070/CC-Antenna-DK -  Rev 1_0_2 - COMPONENT PLACEMENT TOP.pdf

CC-Antenna-Kit | Texas Instruments | Component Placement - Top

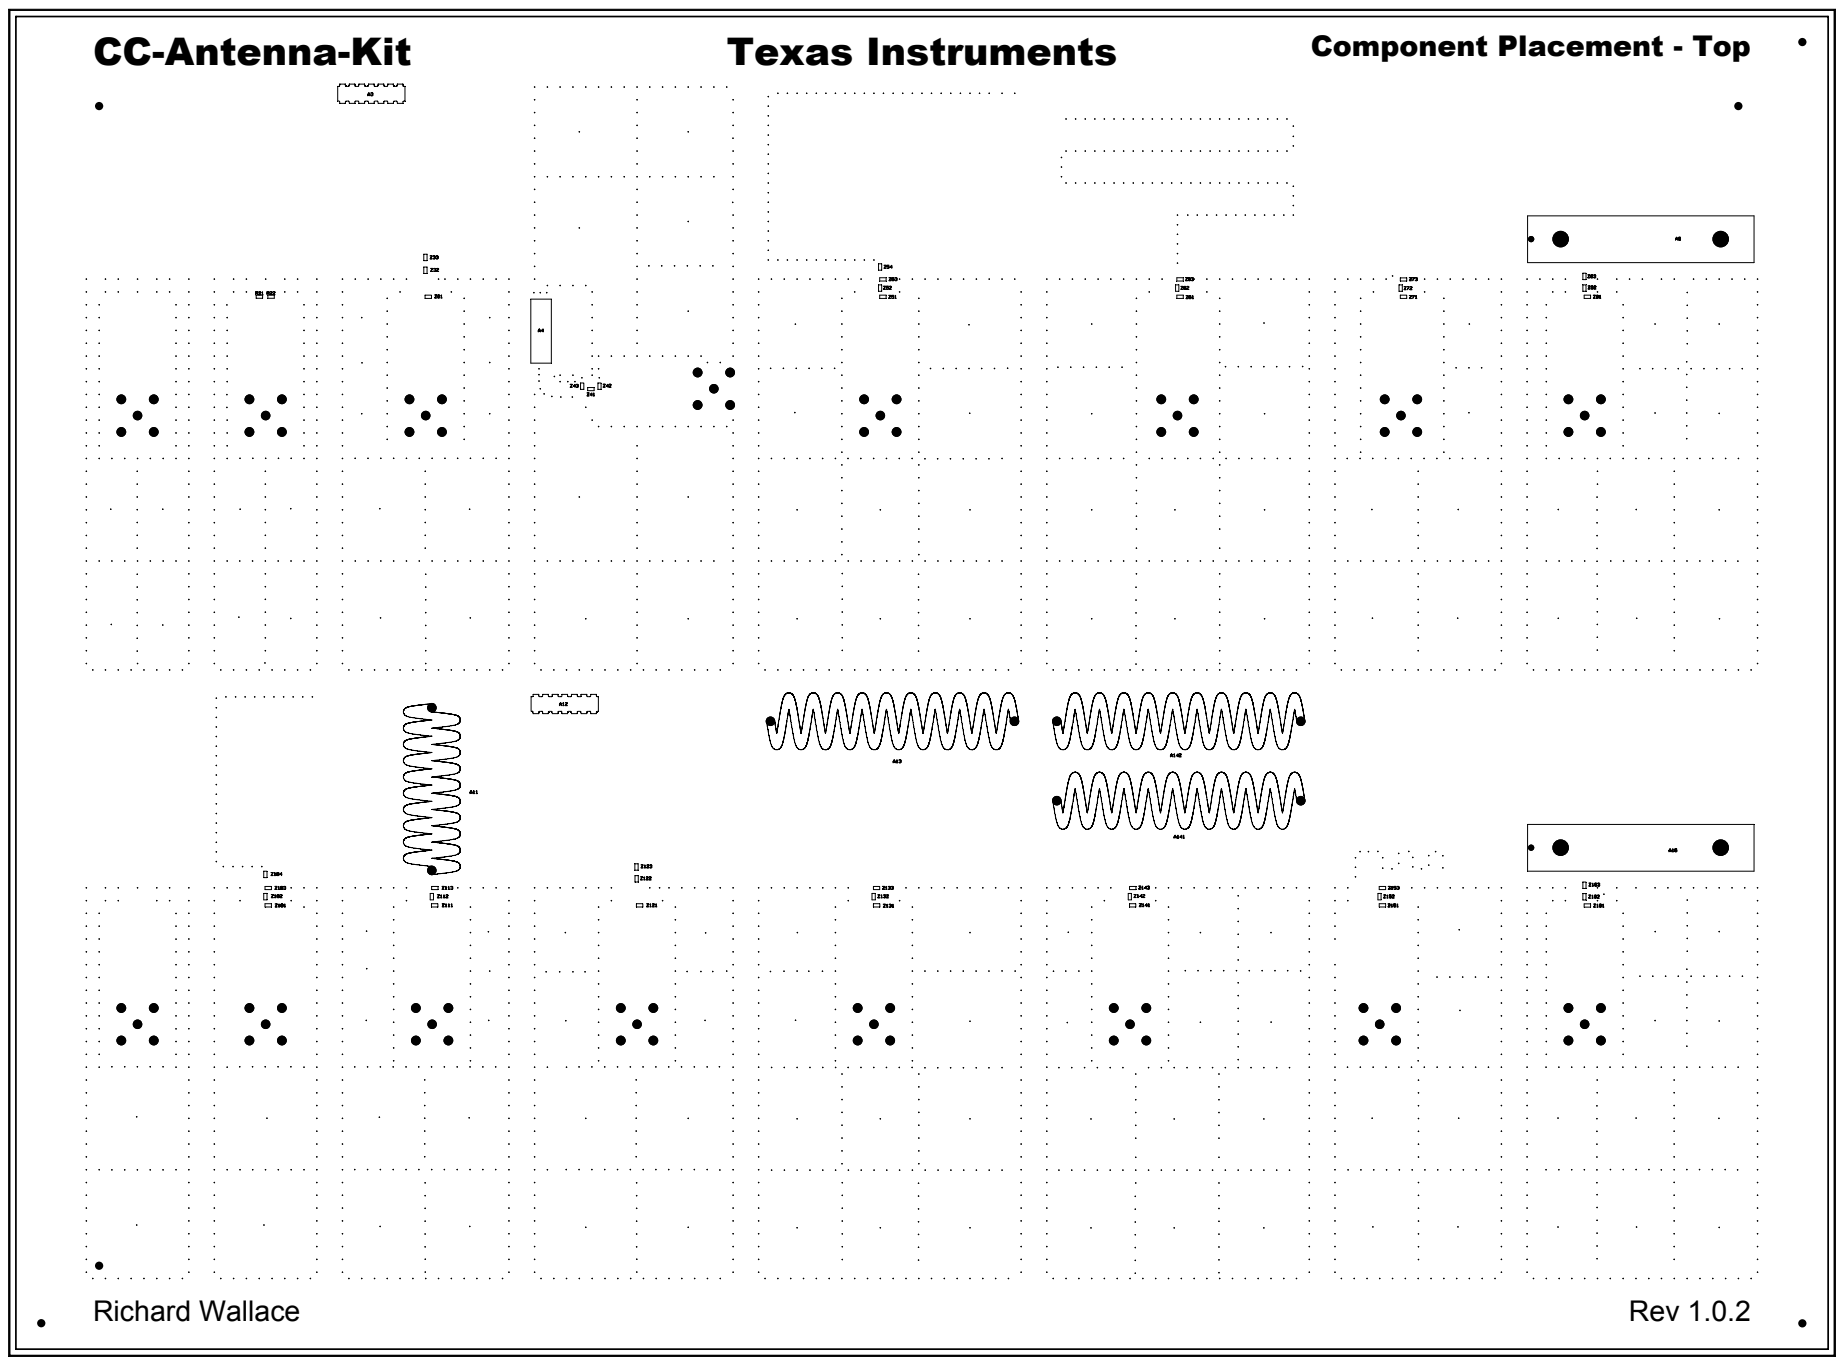
[picture p19: page 1]
Richard Wallace; Rev 1.0.2
