OpenAir-Lab/capstone-project/Documentation/RF Subsystem/Radio Transceiver/swrr070/CC-Antenna-DK -  Rev 1_0_2 - SCHEMATIC.pdf

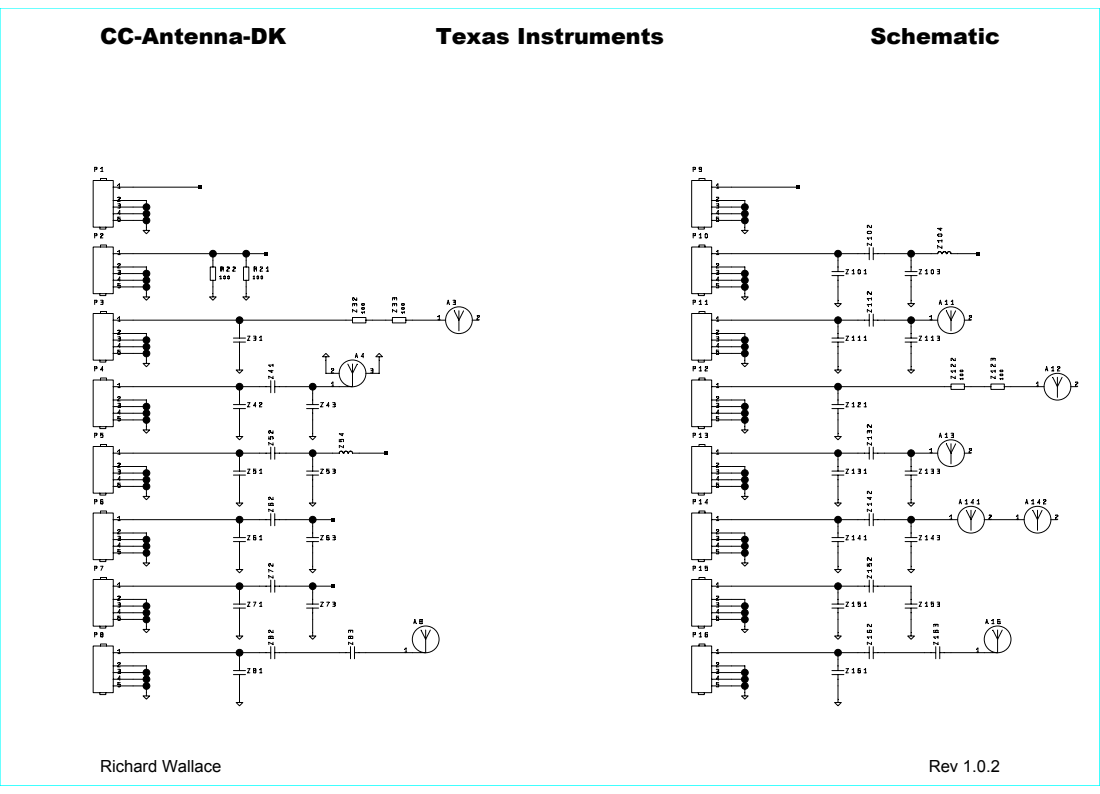
[picture p20: page 1]
CC-Antenna-DK; Texas Instruments; Schematic; Richard Wallace; Rev 1.0.2
