OpenAir-Lab/capstone-project/Documentation/Reference Designs/Guerrilla RF/QFN16-30-46-A/QFN16-30-46-A.PDF

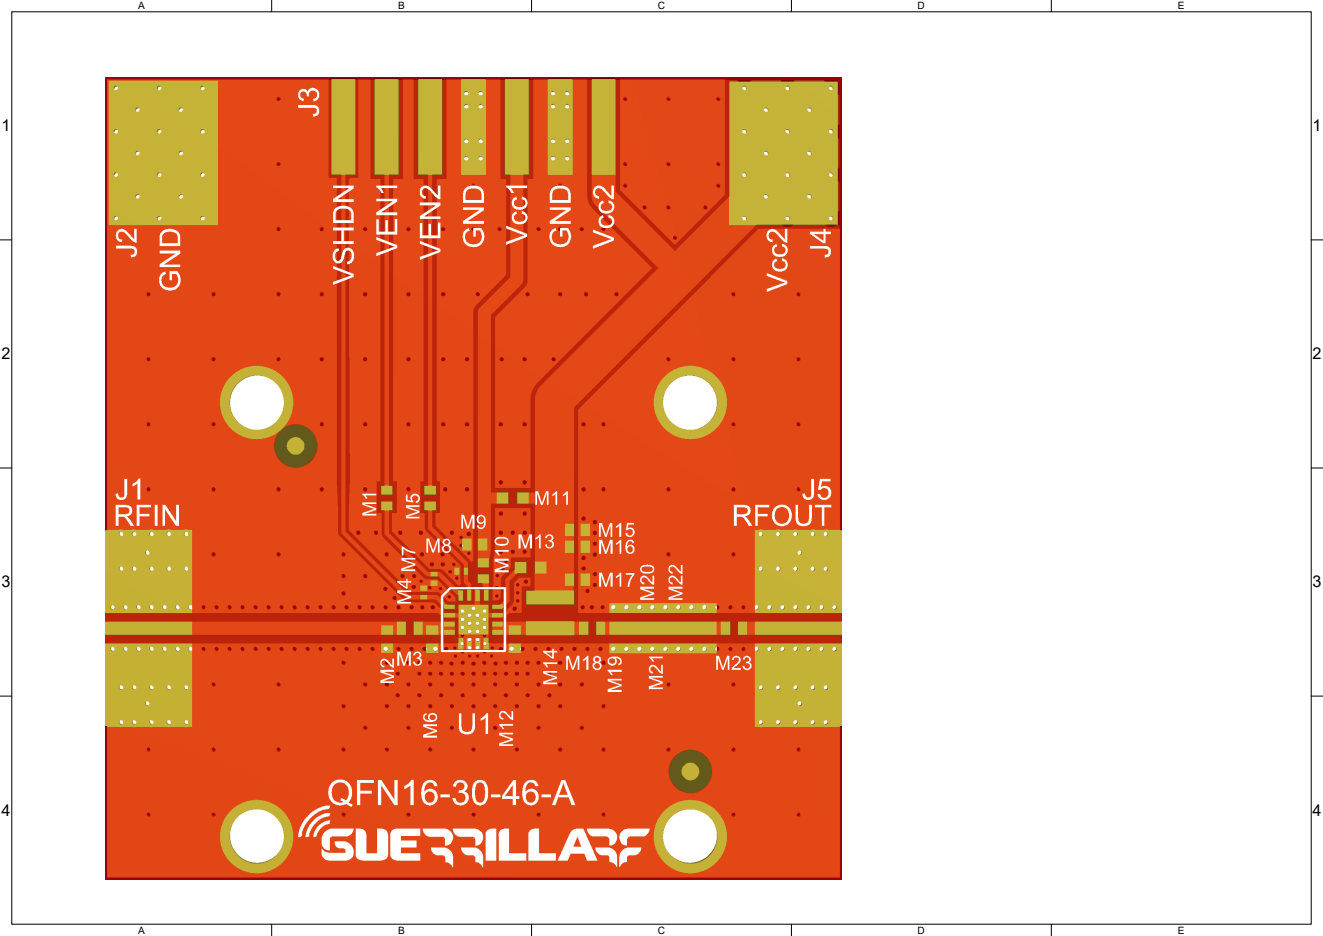
[picture p21: page 1]
