OpenAir-Lab/capstone-project/Documentation/Reference Designs/Guerrilla RF/QFN16-30-46-A/QFN16-30-46-A_Fab-Doc.PDF

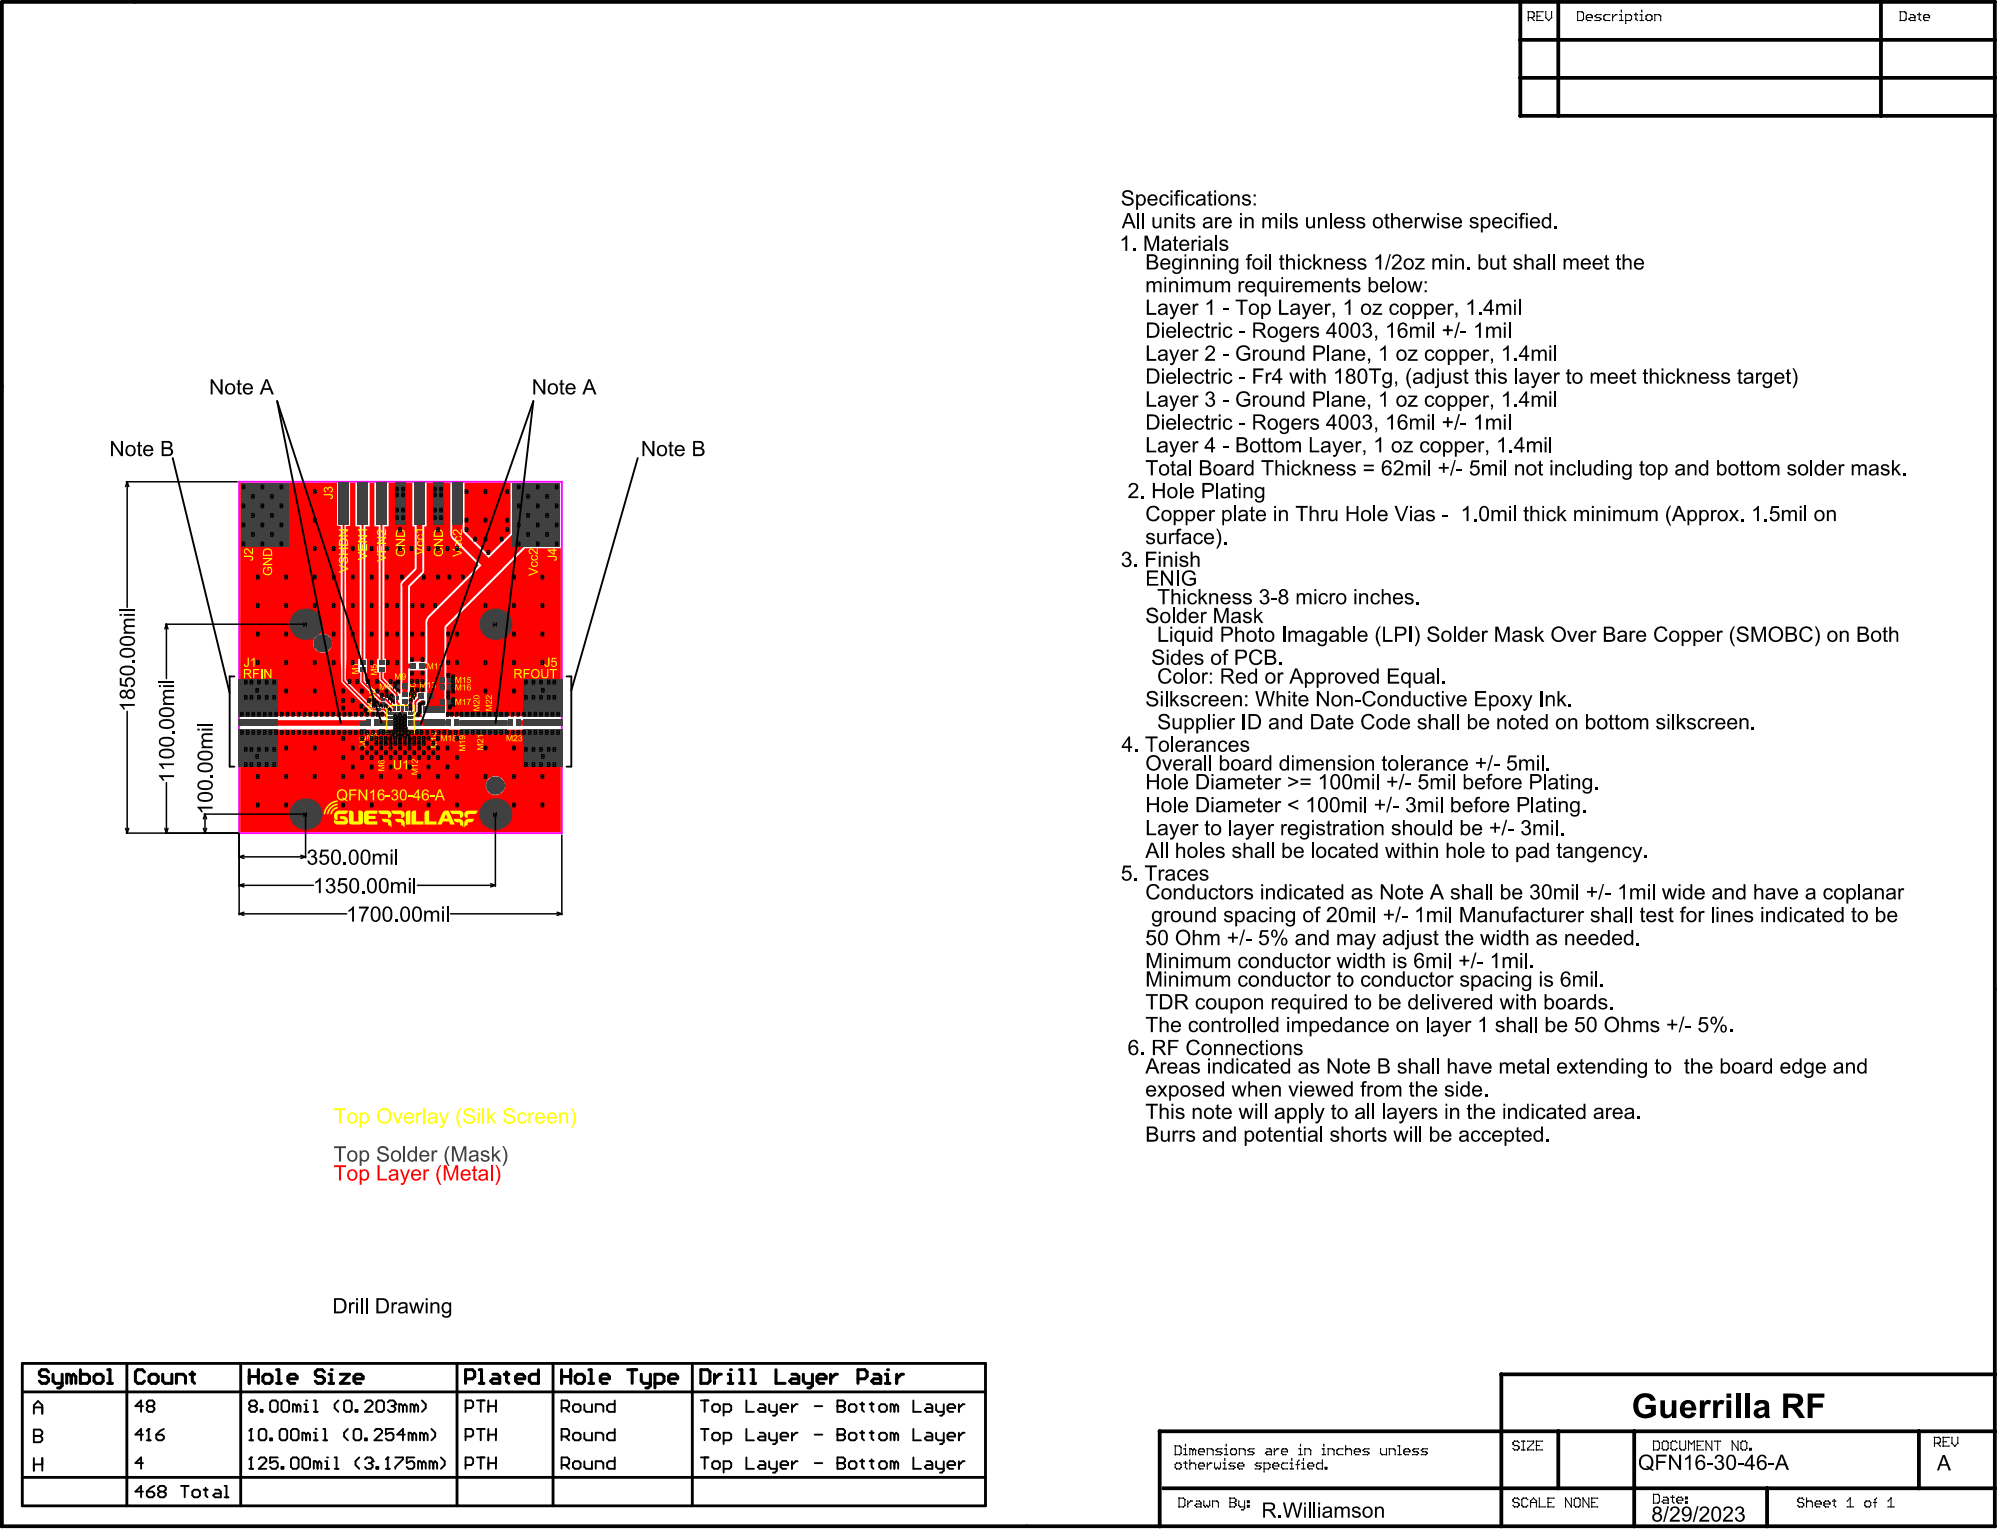
[picture p22: page 1]
