OpenAir-Lab/capstone-project/Documentation/Reference Designs/Guerrilla RF/GRF-DFN6-15-23A/DFN6-15-23-A.pdf

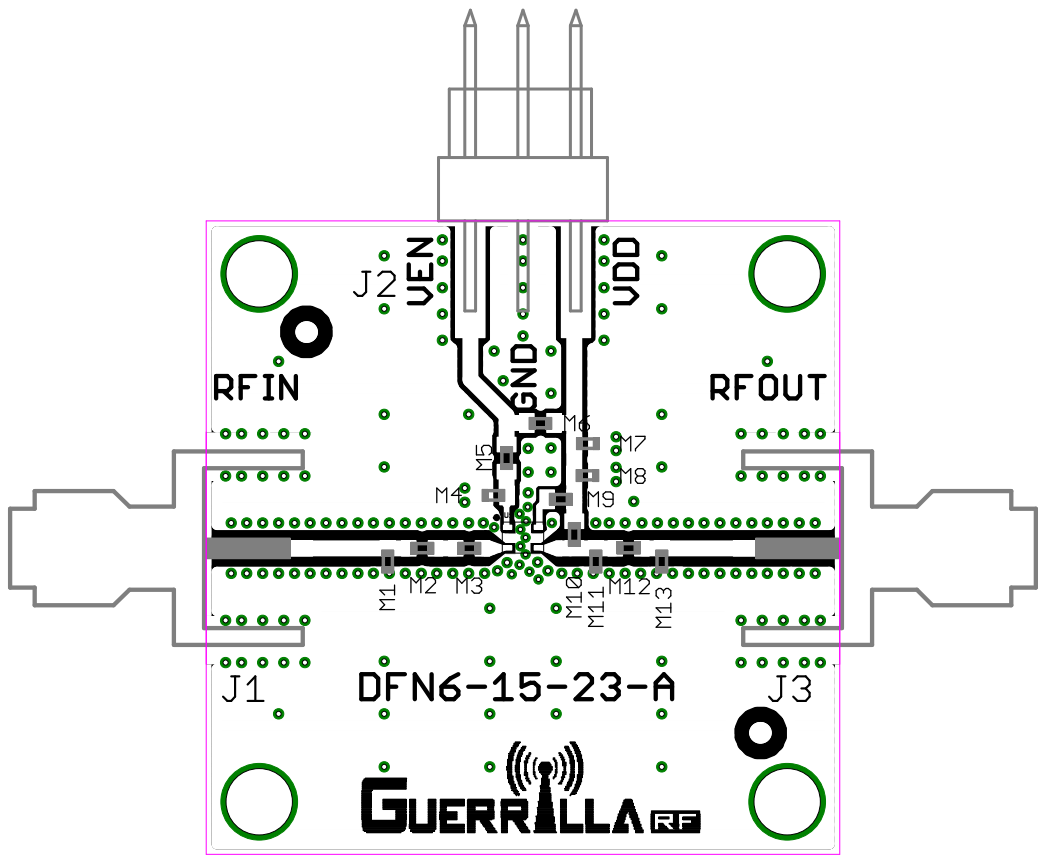
[picture p23: page 1]
