OpenAir-Lab/capstone-project/Documentation/RF Subsystem/Radio Transceiver/swrr070/CC-Antenna-DK -  Rev 1_0_2 - COMPONENT PLACEMENT BOTTOM.pdf

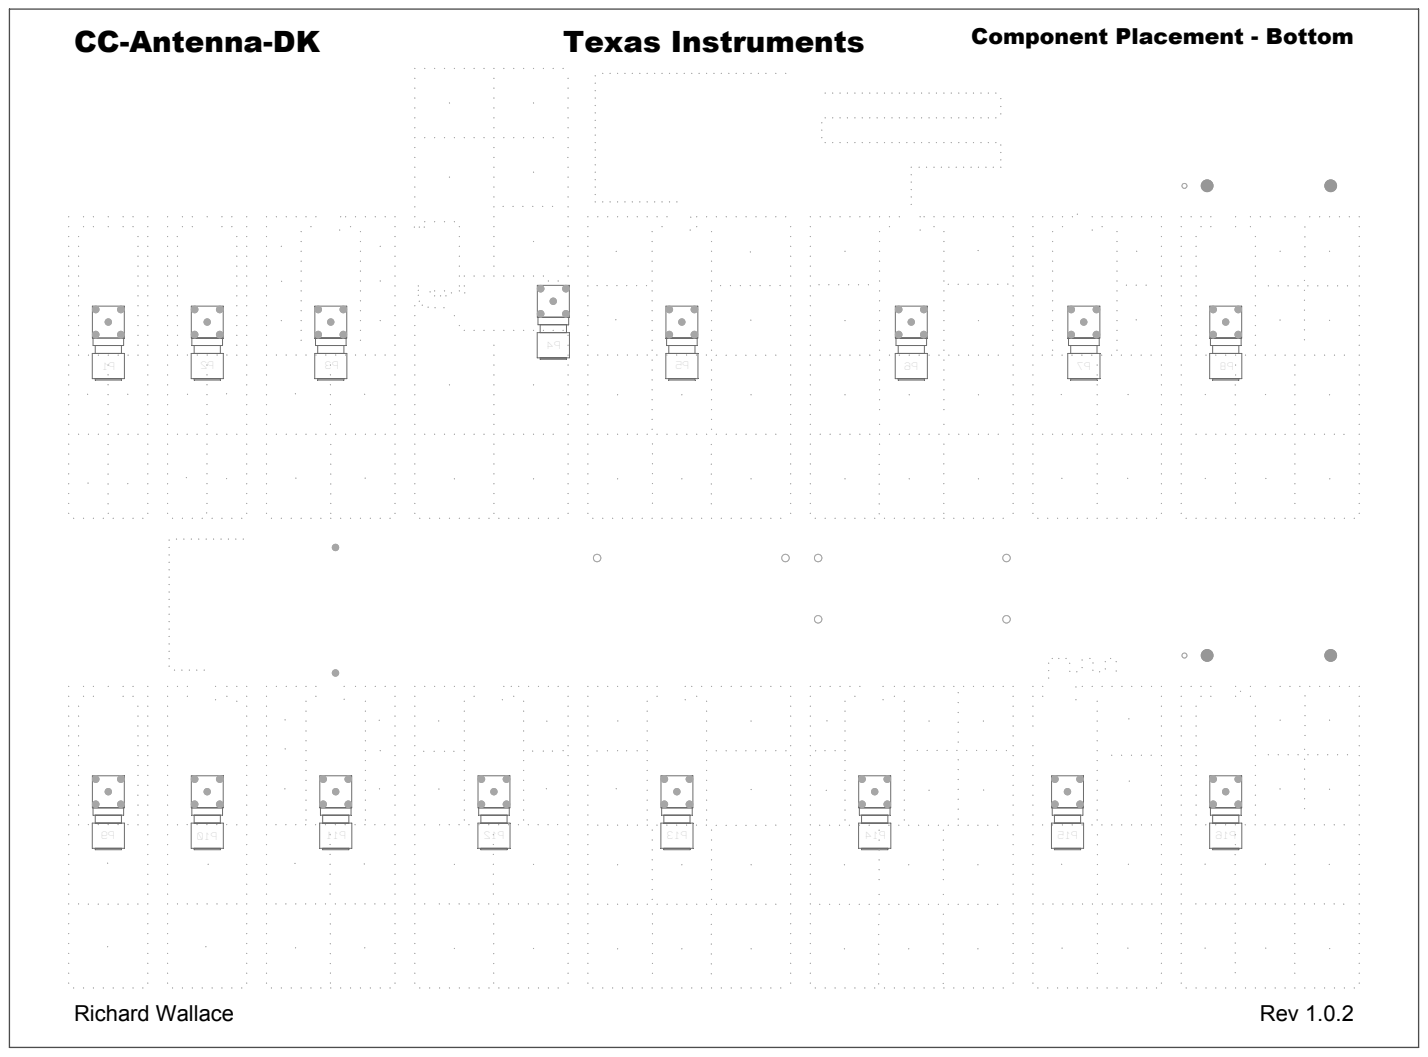
[picture p24: page 1]
