OpenAir-Lab/capstone-project/Documentation/Reference Designs/Texas Instruments/BOOSTXL-BATPAKMKII/Hardware/BOOSTXL-BATPAKMKII_Schematic.pdf

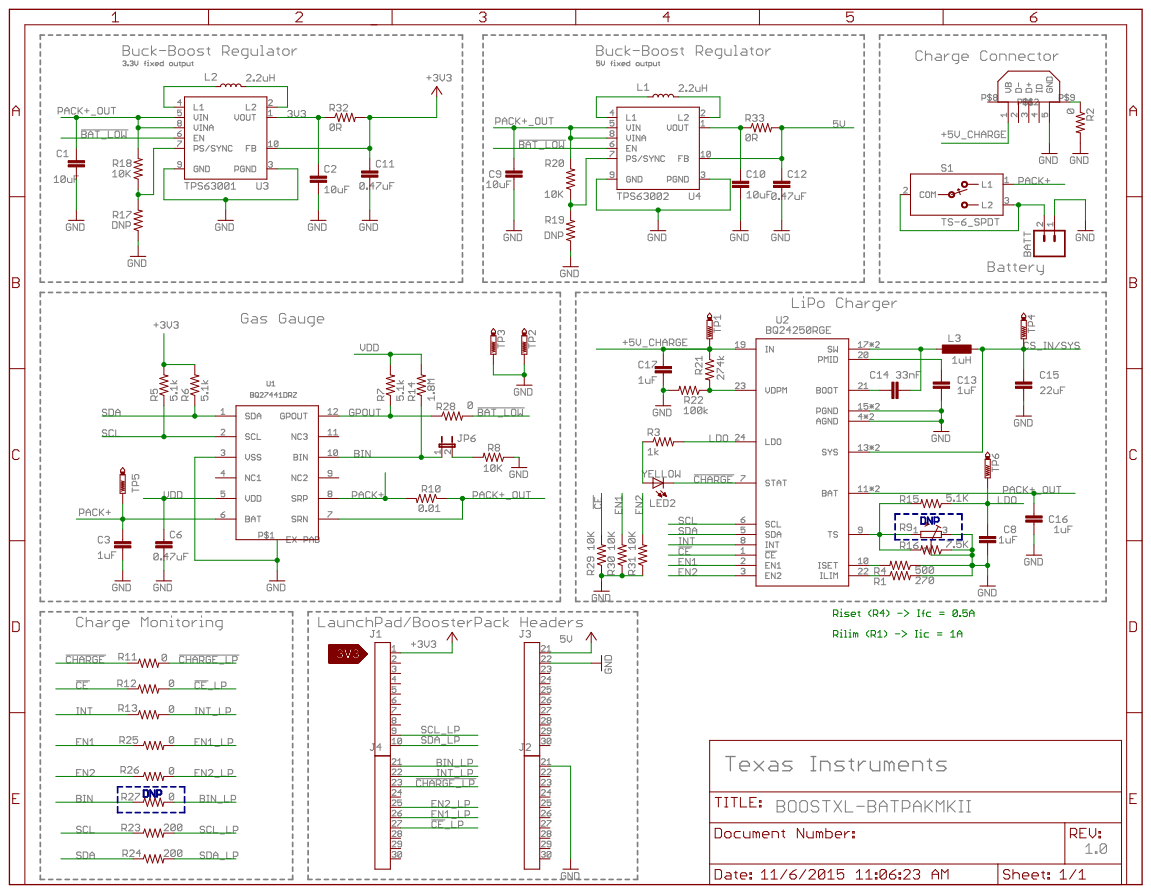
[picture p25: page 1]
