OpenAir-Lab/capstone-project/(list of files, drawings)

Other design files:
Documentation/Reference Designs/Arduino/ABX00110-cad-files/ABX00110 Altium files/MICROCONTROLLER.SchDoc
Documentation/Reference Designs/Arduino/ABX00110-cad-files/ABX00110 Altium files/NODE10 - BUTTON.PrjPcb
Documentation/Reference Designs/Arduino/ABX00110-cad-files/ABX00110 Altium files/PCB.PcbDoc
Documentation/Reference Designs/Arduino/ABX00110-cad-files/ABX00110 Altium files/TOP.SchDoc
Documentation/Reference Designs/Guerrilla RF/QFN16-30-46-A/QFN16-30-46-A.PcbDoc
Documentation/Reference Designs/Guerrilla RF/QFN16-30-46-A/QFN16-30-46-A.PrjPcb
Documentation/Reference Designs/Guerrilla RF/QFN16-30-46-A/QFN16-30-46-A.SchDoc
Documentation/RF Subsystem/Radio Transceiver/cc1120/swrc220/CC112xEM.pcb
