OpenAir-Lab/capstone-project/Hardware/KiCAD/rf-transceiver-modulino/rf-transceiver-modulino.kicad_pcb

## KiCad design Hardware/KiCAD/rf-transceiver-modulino/rf-transceiver-modulino.kicad_pcb (2025-10-23)

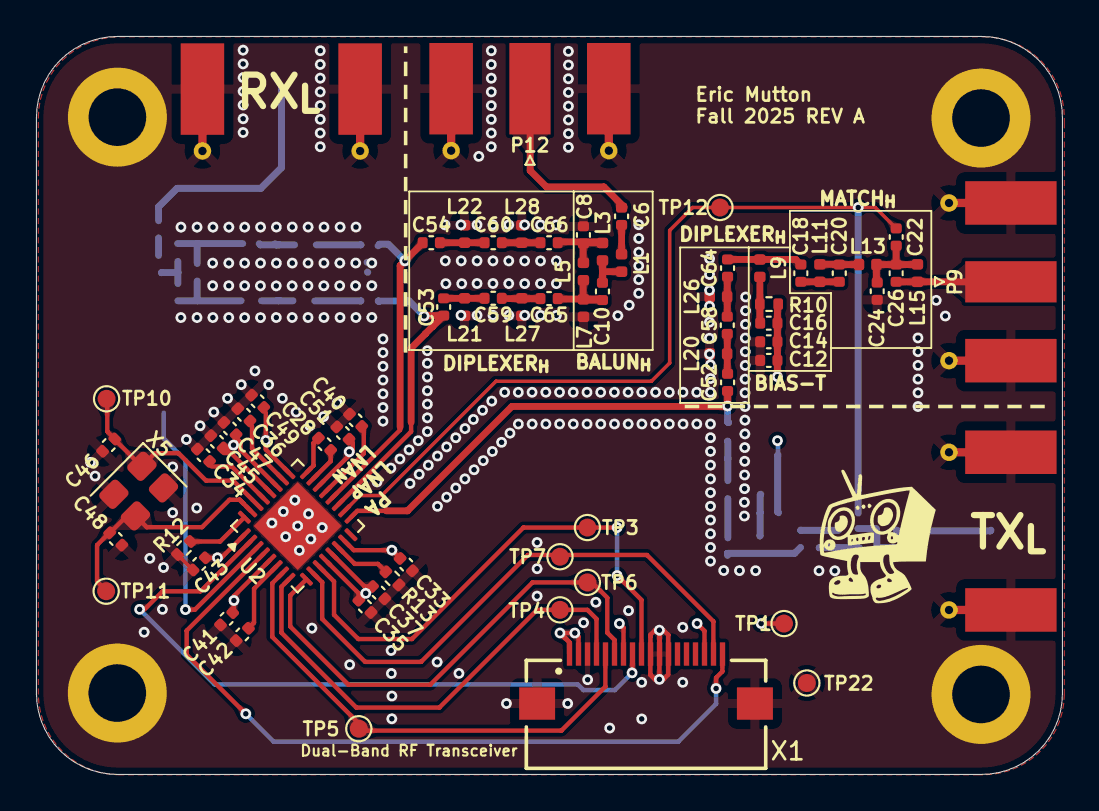
[picture p26: board rf-transceiver-modulino.kicad_pcb from above]

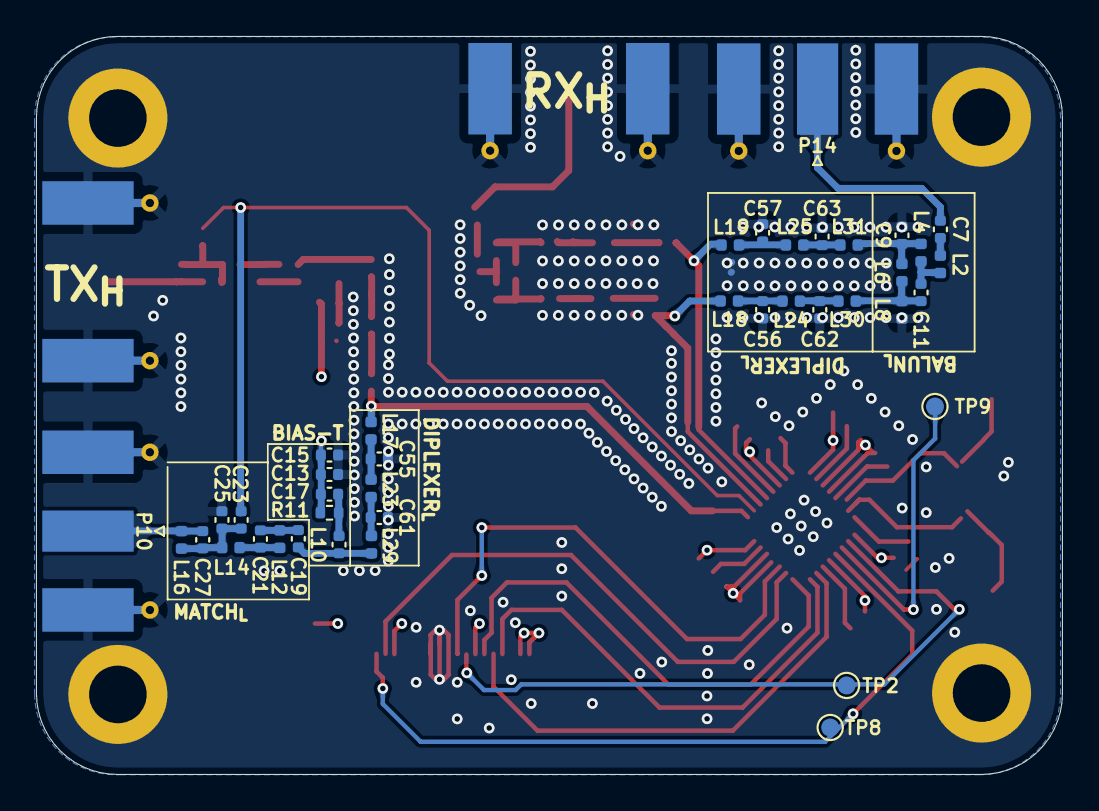
[picture p27: board rf-transceiver-modulino.kicad_pcb from below]

Board: 4 copper layers, 57.0 x 41.0 mm, 112 parts (40 on the bottom side), 58 nets.

Parts:
C6, C8, C10: 5.1pF; C_0402_1005Metric
C7, C9, C11, C21, C23: 12pF; C_0402_1005Metric
C12: 100p; C_0402_1005Metric
C13, C17: 100pF; C_0402_1005Metric
C14, C40: 10n; C_0402_1005Metric
C15: 10nF; C_0402_1005Metric
C16: 56p; C_0402_1005Metric
C18: 39p; C_0402_1005Metric
C19: 82pF; C_0402_1005Metric
C20: 2.2p; C_0402_1005Metric
C22: 1nF; C_0402_1005Metric
C24: 6.2p; C_0402_1005Metric
C25: 15pF; C_0402_1005Metric
C26, C27: 1.2p; C_0402_1005Metric
C28: 1.5n; C_0402_1005Metric
C33, C34, C35, C36, C37, C41, C43, C45, C47, C49, C51: 47n; C_0402_1005Metric
C42: 220n; C_0402_1005Metric
C46, C48: 15p; C_0402_1005Metric
C52, C53, C54, C64, C65, C66: 4.7pF; C_0402_1005Metric
C55, C56, C57, C61, C62, C63: 18pF; C_0402_1005Metric
C58, C59, C60: 2.7pF; C_0402_1005Metric
H1, H2, H3, H5: M3; MountingHole_3.2mm_M3_ISO14580_Pad
L1, L20, L21, L22, L26, L27, L28: 15nH; L_0402_1005Metric
L2: 39nH; L_0402_1005Metric
L3, L7: 27nH; L_0402_1005Metric
L4, L8: 82nH; L_0402_1005Metric
L5, L9: 56n; L_0402_1005Metric
L6: 150n; L_0402_1005Metric
L10: 220nH; C_0402_1005Metric
L11: 15n; L_0402_1005Metric
L12: 18nH; L_0402_1005Metric
L13: 43n; L_0402_1005Metric
L14, L23, L24, L25: 100nH; L_0402_1005Metric
L15: 22n; L_0402_1005Metric
L16, L17, L18, L19, L29, L30, L31: 68nH; L_0402_1005Metric
P9, P10, P12, P14: SMA; SMA_Molex_73251-1153_EdgeMount_Horizontal
R10: 18; R_0402_1005Metric
R11: 22; R_0402_1005Metric
R12: 0R; R_0402_1005Metric
R13: 56k; R_0402_1005Metric
TP1: +3.3V; TestPoint_Pad_D1.0mm
TP2: NRST; TestPoint_Pad_D1.0mm
TP3: NCS; TestPoint_Pad_D1.0mm
TP4: SCLK; TestPoint_Pad_D1.0mm
TP5: MOSI; TestPoint_Pad_D1.0mm
TP6: IO1/MISO; TestPoint_Pad_D1.0mm
TP7: IO0; TestPoint_Pad_D1.0mm
TP8: IO2; TestPoint_Pad_D1.0mm
TP9: IO3; TestPoint_Pad_D1.0mm
TP10: X1; TestPoint_Pad_D1.0mm
TP11: X2; TestPoint_Pad_D1.0mm
TP12: TRX_SW; TestPoint_Pad_D1.0mm
TP22: GND; TestPoint_Pad_D1.0mm
U2: CC1200RHBR; QFN-32-1EP_5x5mm_P0.5mm_EP3.45x3.45mm
X1: EYESPI; Adafruit EYESPI FPC Connector
X5: 40 MHz; Crystal_SMD_3225-4Pin_3.2x2.5mm

Connections:
+3.3V: C12.1, C13.1, C14.1, C15.1, C16.1, C17.1, C33.1, C35.1, C37.1, C41.1, C43.1, C45.1, C47.1, C49.1, C51.1, R10.1, R11.1, TP1.1, U2.1 (VDD_GUARD), U2.5 (DVDD), U2.12 (DVDD), U2.13 (AVDD_IF), U2.15 (AVDD_RF), U2.22 (AVDD_SYNTH1), U2.25 (AVDD_PFD_CHP), U2.27 (AVDD_SYNTH2), U2.28 (AVDD_XOSC), X1.1, X1.2, X1.7, X1.16
/RF Subsystem/LNA_N: C54.1, L19.1, U2.20 (LNA_N)
/RF Subsystem/LNA_N_{UHF}: C8.1, C66.2, L3.1, L5.2
/RF Subsystem/LNA_N_{VHF}: C9.1, L4.1, L6.2, L31.2
/RF Subsystem/LNA_P: C53.1, L18.1, U2.19 (LNA_P)
/RF Subsystem/LNA_P_{UHF}: C10.1, C65.2, L5.1, L7.1
/RF Subsystem/LNA_P_{VHF}: C11.1, L6.1, L8.1, L30.1
/RF Subsystem/PA_{SHUTDOWN}: TP9.1, U2.3 (GPIO3)
/RF Subsystem/PA_{UHF}: C18.2, C64.2, L9.2
/RF Subsystem/PA_{VHF}: C19.2, L10.2, L29.2
/RF Subsystem/TRX_GPIO0: TP7.1, U2.10 (GPIO0), X1.17
/RF Subsystem/TRX_GPIO2: TP8.1, U2.4 (GPIO2), X1.18
/RF Subsystem/TRX_MISO: TP6.1, U2.9 (SO(GPIO1)), X1.6
/RF Subsystem/TRX_MOSI: TP5.1, U2.7 (SI), X1.5
/RF Subsystem/TRX_NCS: TP3.1, U2.11 (~CS), X1.9
/RF Subsystem/TRX_NRST: TP2.1, U2.2 (~RESET), X1.8
/RF Subsystem/TRX_PA: C52.1, L17.1, U2.17 (PA)
/RF Subsystem/TRX_SCLK: TP4.1, U2.8 (SCLK), X1.4
/RF Subsystem/TRX_X1: C46.2, TP10.1, U2.30 (XOSC_Q1), X5.1
/RF Subsystem/TRX_X2: C48.1, TP11.1, U2.31 (XOSC_Q2), X5.3
/RF Subsystem/TRX_{SW}: C22.1, C23.1, TP12.1, U2.18 (TRX_SW)
GND: C8.2, C9.2, C12.2, C13.2, C14.2, C15.2, C24.2, C25.2, C33.2, C34.2, C35.2, C36.2, C37.2, C40.2, C41.2, C42.2, C43.2, C45.2, C46.1, C47.2, C48.2, C49.2, C51.2, C55.2, C56.2, C57.2, C61.2, C62.2, C63.2, H1.1, H2.1, H3.1, H5.1, L7.2, L8.2, L20.2, L21.2, L22.2, L26.2, L27.2, L28.2, P9.2 (Ext), P10.2 (Ext), P12.2 (Ext), P14.2 (Ext), R12.1, R13.2, TP22.1, U2.33 (GND_EP), X1.3, X1.10, X1.11, X1.12, X1.Z1, X1.Z2, X5.2, X5.4
unnamed: C6.2, L1.1
unnamed: C7.2, L2.1
unnamed: C10.2, L1.2, L3.2
unnamed: C11.2, L2.2, L4.2
unnamed: C16.2, L9.1, R10.2
unnamed: C17.2, L10.1, R11.2
unnamed: C18.1, C20.2, L11.1
unnamed: C19.1, C21.2, L12.1
unnamed: C20.1, L11.2, L13.1
unnamed: C21.1, L12.2, L14.1
unnamed: C22.2, C24.1, C26.1, L13.2, L15.1
unnamed: C23.2, C25.1, C27.1, L14.2, L16.1
unnamed: C52.2, C58.1, L20.1
unnamed: C53.2, C59.1, L21.1
unnamed: C54.2, C60.1, L22.1
unnamed: C55.1, L17.2, L23.1
unnamed: C56.1, L18.2, L24.1
unnamed: C57.1, L19.2, L25.1
unnamed: C58.2, C64.1, L26.1
unnamed: C59.2, C65.1, L27.1
unnamed: C60.2, C66.1, L28.1
unnamed: C61.1, L23.2, L29.1
unnamed: C62.1, L24.2, L30.2
unnamed: C63.1, L25.2, L31.1
unnamed: C26.2, L15.2, P9.1 (In)
unnamed: C27.2, L16.2, P10.1 (In)
unnamed: C6.1, P12.1 (In)
unnamed: C7.1, P14.1 (In)
unnamed: C42.1, U2.6 (DCPL)
unnamed: C36.1, U2.26 (DCPL_PFD_CHP)
unnamed: C40.1, U2.21 (DCPL_VCO)
unnamed: C34.1, U2.29 (DCPL_XOSC)
unnamed: R12.2, U2.32 (EXT_XOSC)
unnamed: C28.2, U2.23 (LPF0)
unnamed: C28.1, U2.24 (LPF1)
unnamed: R13.1, U2.14 (RBIAS)
