OpenAir-Lab/capstone-project/Hardware/KiCAD/mcu-modulino/mcu-modulino.kicad_pcb

## KiCad design Hardware/KiCAD/mcu-modulino/mcu-modulino.kicad_pcb (2025-11-24)

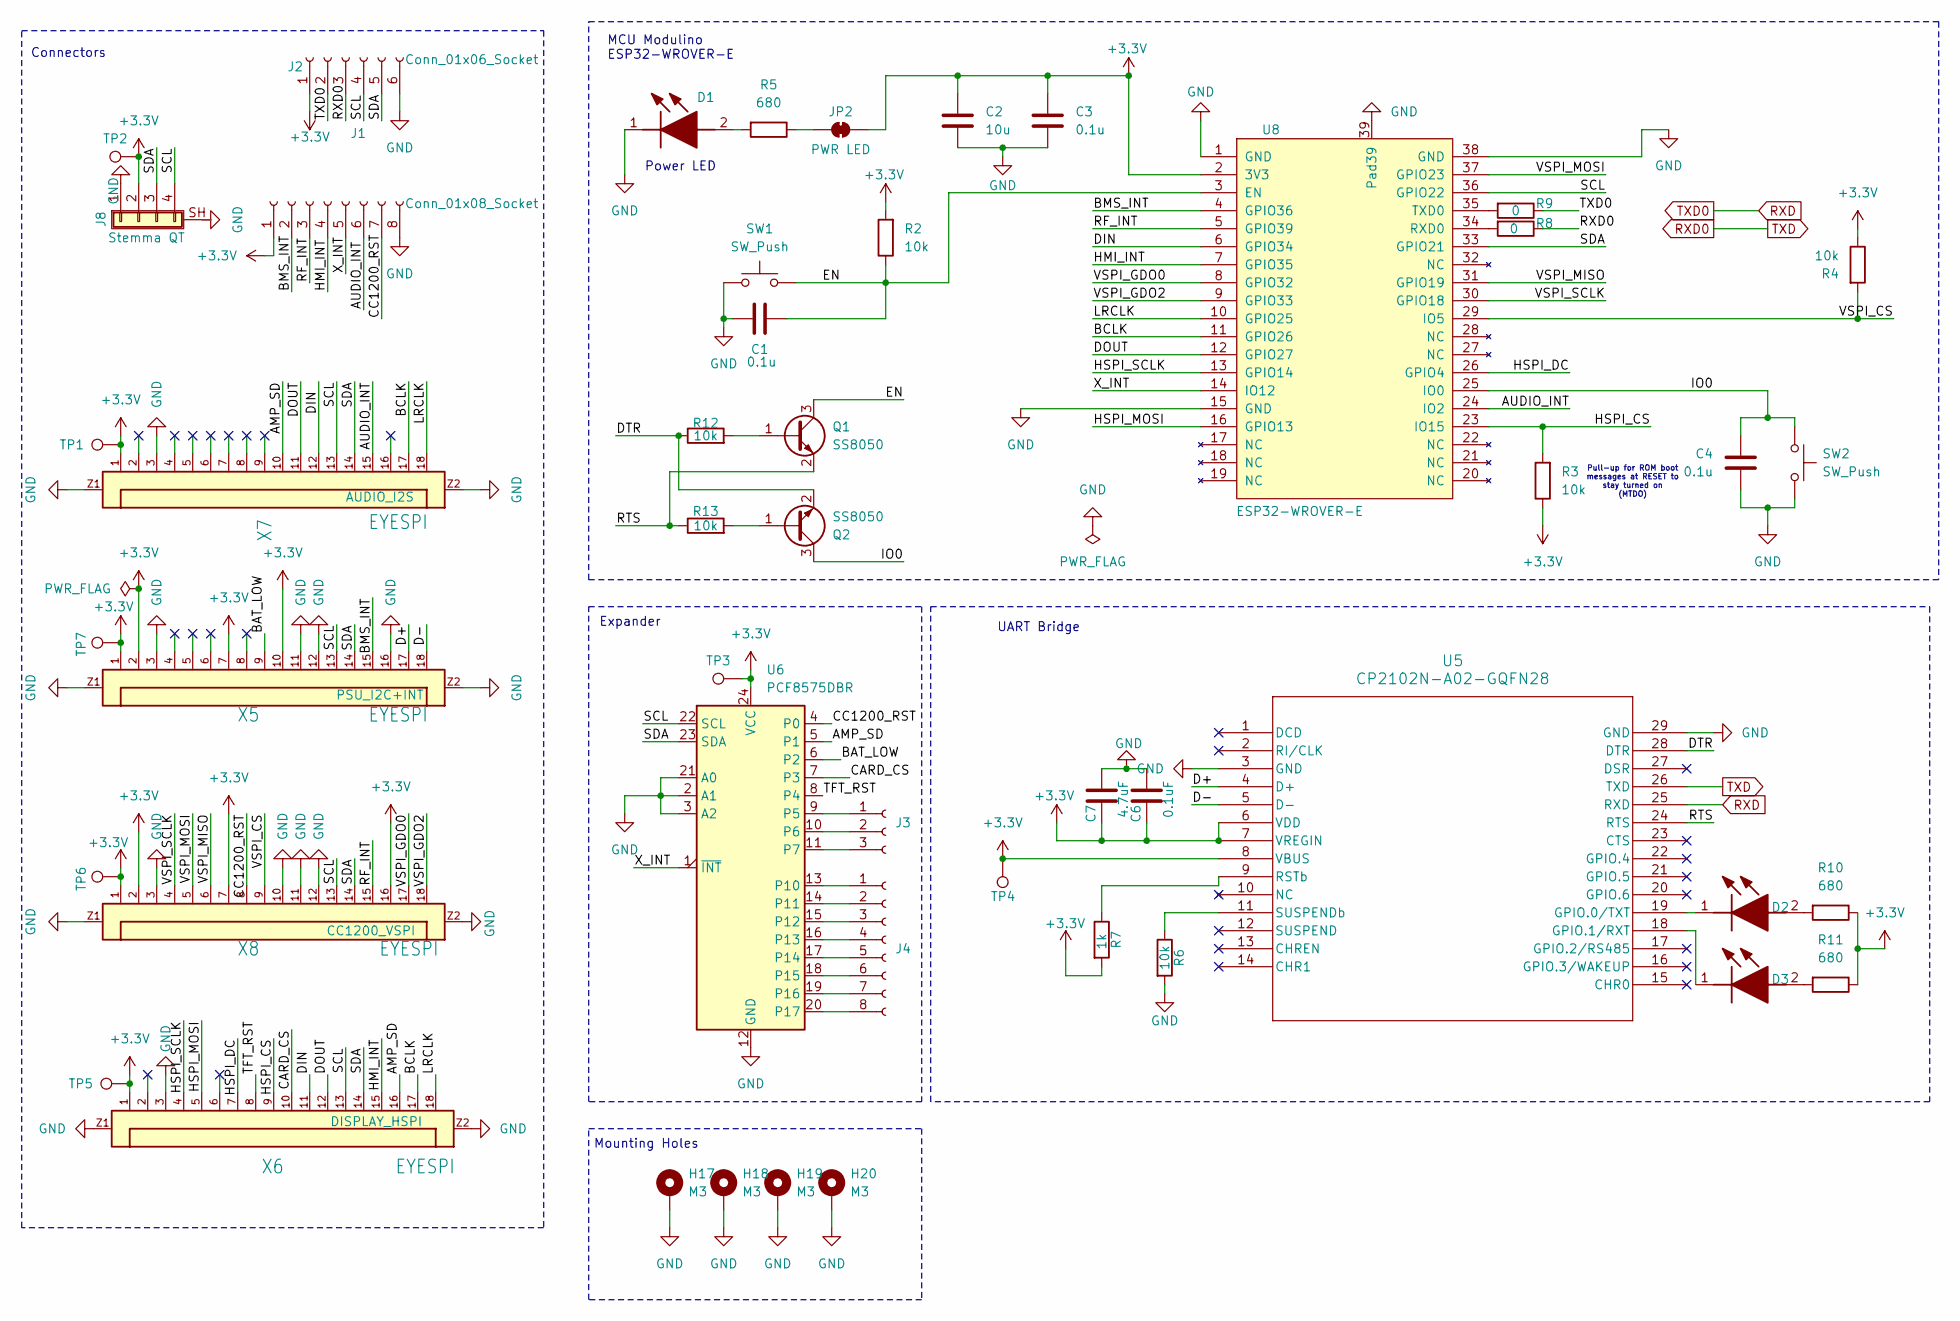
[picture p28: schematic mcu-modulino.kicad_sch]

Parts:
C1, C3, C4: 0.1u; C_0603_1608Metric
C2: 10u; C_0603_1608Metric
C6: 0.1uF; C_0603_1608Metric
C7: 4.7uF; C_0603_1608Metric
D1: LTST-C190KRKT; LED_0603_1608Metric; Mouser Part Number 859-LTST-C190KRKT
D2, D3: LTST-C191GKT; Mouser Part Number 859-LTST-C191GKT
H17, H18, H19, H20: M3; MountingHole_3.2mm_M3_ISO14580_Pad
J1: Conn_01x08_Socket; PinSocket_1x08_P2.54mm_Vertical
J2: Conn_01x06_Socket; PinHeader_1x06_P1.00mm_Vertical
J3: Conn_01x03_Socket; PinSocket_1x03_P1.27mm_Vertical
J4: Conn_01x08_Socket; PinSocket_1x08_P1.27mm_Vertical
J8: Stemma QT; JST_SH_SM04B-SRSS-TB_1x04-1MP_P1.00mm_Horizontal
JP2: PWR LED; SolderJumper-2_P1.3mm_Bridged_RoundedPad1.0x1.5mm
Q1, Q2: SS8050; SOT-23
R2, R3, R4, R6, R12, R13: 10k; R_0603_1608Metric
R5, R10, R11: 680; R_0603_1608Metric
R7: 1k; R_0603_1608Metric
R8, R9: 0; R_0603_1608Metric
SW1, SW2: SW_Push; SW_SPST_EVQP2_MiddlePushTravel_H2.5mm
TP1, TP2, TP3, TP4, TP5, TP6, TP7: TestPoint; TestPoint_Pad_D1.0mm
U5: CP2102N-A02-GQFN28; QFN28_5X5_SIL
U6: PCF8575DBR; SSOP-24_5.3x8.2mm_P0.65mm
U8: ESP32-WROVER-E; ESP32-WROVER-IE
X5, X6, X7, X8: EYESPI; Adafruit EYESPI FPC Connector

Connections:
+3.3V: C2.1, C3.1, C6.2, C7.2, J2.1, J8.2, JP2.2 (B), R2.2, R3.1, R4.1, R7.2, R10.1, R11.1, TP1.1, TP2.1, TP3.1, TP4.1, TP5.1, TP6.1, TP7.1, U5.6 (VDD), U5.7 (VREGIN), U5.8 (VBUS), U6.24 (VCC), U8.2 (3V3), X5.1, X5.2, X5.7, X5.10, X6.1, X7.1, X8.1, X8.2, X8.7, X8.16
/AMP_SD: U6.5 (P1), X6.16, X7.10
/AUDIO_INT: J1.6, U8.24 (IO2), X7.15
/BAT_LOW: U6.6 (P2), X5.9
/BCLK: U8.11 (GPIO26), X6.17, X7.17
/BMS_INT: U8.4 (GPIO36), X5.15
/CARD_CS: U6.7 (P3), X6.10
/CC1200_RST: U6.4 (P0), X8.8
/D+: U5.4 (D+), X5.17
/D-: U5.5 (D-), X5.18
/DIN: U8.6 (GPIO34), X6.11, X7.12
/DOUT: U8.12 (GPIO27), X6.12, X7.11
/DTR: Q2.2 (E), R12.1, U5.28 (DTR)
/EN: C1.2, Q1.3 (C), R2.1, SW1.2, U8.3 (EN)
/HMI_INT: U8.7 (GPIO35), X6.15
/HSPI_CS: R3.2, U8.23 (IO15), X6.9
/HSPI_DC: U8.26 (GPIO4), X6.7
/HSPI_MOSI: U8.16 (GPIO13), X6.5
/HSPI_SCLK: U8.13 (GPIO14), X6.4
/IO0: C4.1, Q2.3 (C), SW2.1, U8.25 (IO0)
/LRCLK: U8.10 (GPIO25), X6.18, X7.18
/RF_INT: U8.5 (GPIO39), X8.15
/RTS: Q1.2 (E), R13.1, U5.24 (RTS)
/SCL: J2.4, J8.4, U6.22 (SCL), U8.36 (GPIO22), X5.13, X6.13, X7.13, X8.13
/SDA: J2.5, J8.3, U6.23 (SDA), U8.33 (GPIO21), X5.14, X6.14, X7.14, X8.14
/TFT_RST: U6.8 (P4), X6.8
/VSPI_CS: R4.2, U8.29 (IO5), X8.9
/VSPI_GDO0: U8.8 (GPIO32), X8.17
/VSPI_GDO2: U8.9 (GPIO33), X8.18
/VSPI_MISO: U8.31 (GPIO19), X8.6
/VSPI_MOSI: U8.37 (GPIO23), X8.5
/VSPI_SCLK: U8.30 (GPIO18), X8.4
/X_INT: J1.5, U6.1 (~INT), U8.14 (IO12)
GND: C1.1, C2.2, C3.2, C4.2, C6.1, C7.1, D1.1 (K), H18.1, H20.1, J2.6, J8.1, J8.SH (Shield), R6.2, SW1.1, SW2.2, U5.3 (GND), U5.29 (GND), U6.2 (A1), U6.3 (A2), U6.12 (GND), U6.21 (A0), U8.1 (GND), U8.15 (GND), U8.38 (GND), U8.39 (Pad39), X5.3, X5.11, X5.12, X5.16, X5.Z1, X5.Z2, X6.3, X6.Z1, X6.Z2, X7.3, X7.Z1, X7.Z2, X8.3, X8.10, X8.11, X8.12, X8.Z1, X8.Z2
unnamed: D1.2 (A), R5.2
unnamed: D2.2 (A), R10.2
unnamed: D2.1 (K), U5.19 (GPIO.0/TXT)
unnamed: D3.2 (A), R11.2
unnamed: D3.1 (K), U5.18 (GPIO.1/RXT)
unnamed: J3.1, U6.9 (P5)
unnamed: J3.2, U6.10 (P6)
unnamed: J3.3, U6.11 (P7)
unnamed: J4.1, U6.13 (P10)
unnamed: J4.2, U6.14 (P11)
unnamed: J4.3, U6.15 (P12)
unnamed: J4.4, U6.16 (P13)
unnamed: J4.5, U6.17 (P14)
unnamed: J4.6, U6.18 (P15)
unnamed: J4.7, U6.19 (P16)
unnamed: J4.8, U6.20 (P17)
unnamed: JP2.1 (A), R5.1
unnamed: Q1.1 (B), R12.2
unnamed: Q2.1 (B), R13.2
unnamed: R7.1, U5.9 (RSTb)
unnamed: R6.1, U5.11 (SUSPENDb)
unnamed: R8.2, U8.34 (RXD0)
unnamed: R9.2, U8.35 (TXD0)
RXD: J2.2, R9.1, U5.25 (RXD)
RXD0: J2.3, R8.1, U5.26 (TXD)

Notes on the sheet:
UART Bridge
Pull-up for ROM boot messages at RESET to stay turned on (MTDO)
Power LED
Connectors
MCU Modulino ESP32-WROVER-E
Expander
Mounting Holes

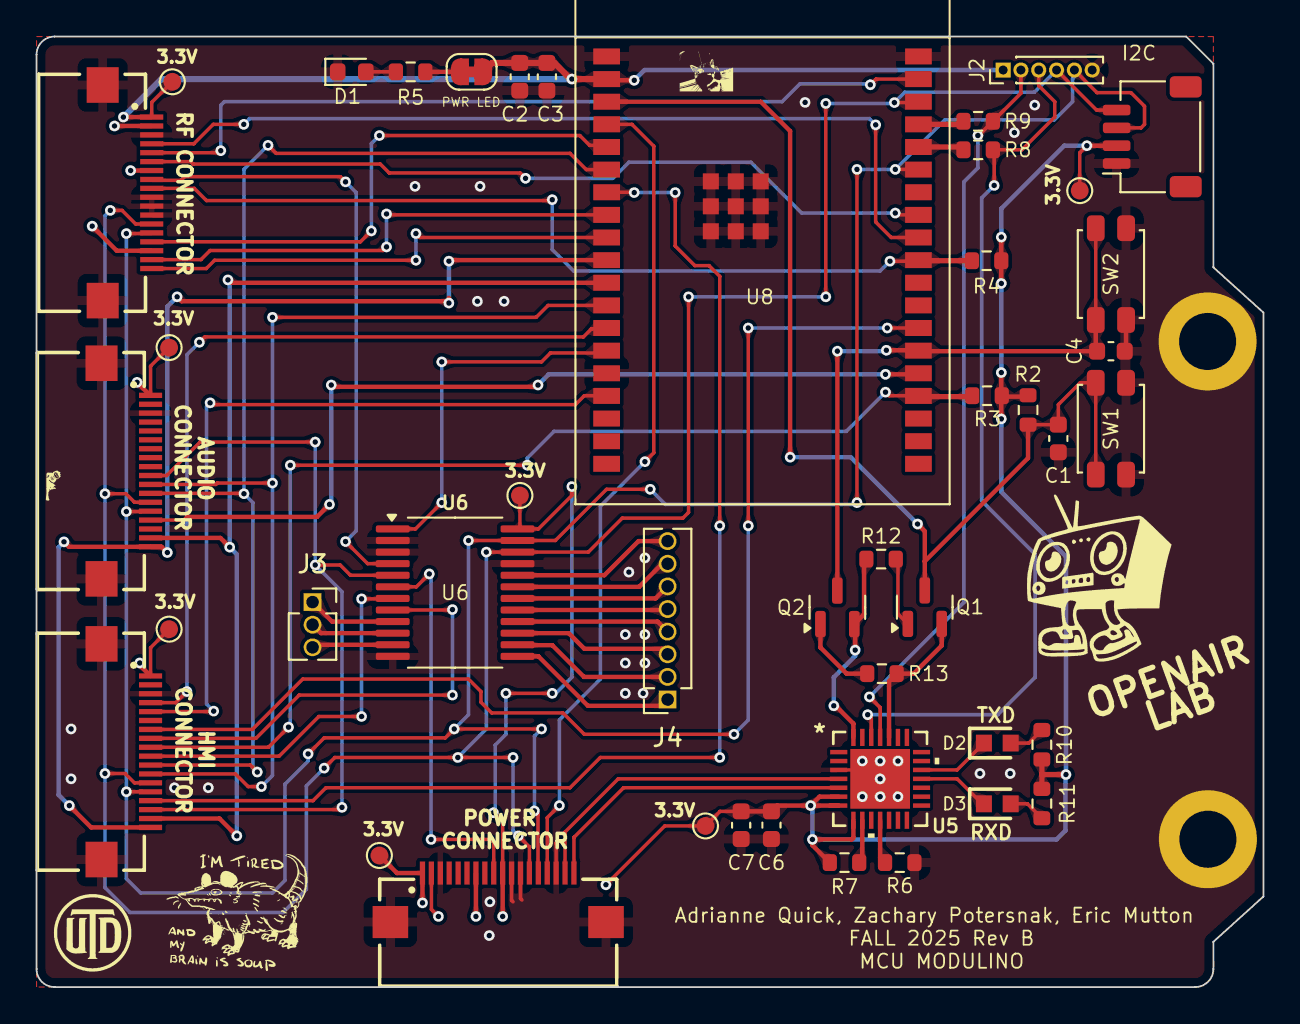
[picture p29: board mcu-modulino.kicad_pcb from above]

Board: 4 copper layers, 68.9 x 53.3 mm, 46 parts (0 on the bottom side), 59 nets.
