OpenAir-Lab/capstone-project/Documentation/Reference Designs/Guerrilla RF/GRF-DFN6-15-23A/GRF-DFN6-15-23A.kicad_pcb

## KiCad design Documentation/Reference Designs/Guerrilla RF/GRF-DFN6-15-23A/GRF-DFN6-15-23A.kicad_pcb (2025-07-19)

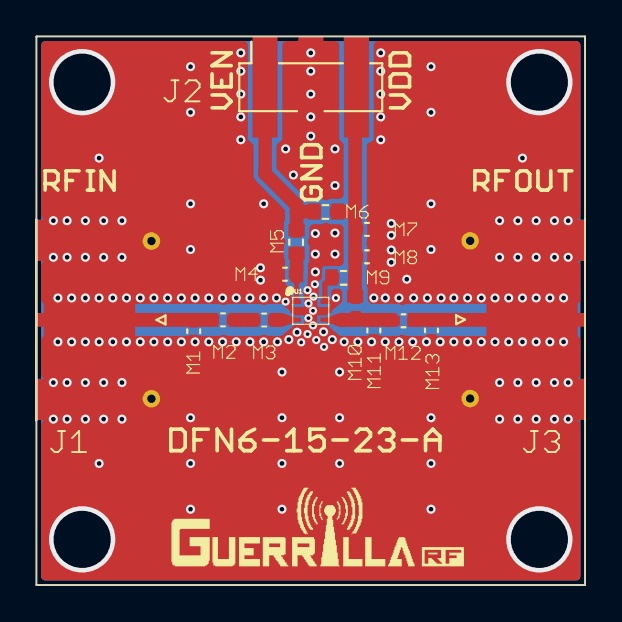
[picture p30: board GRF-DFN6-15-23A.kicad_pcb from above]

Board: 4 copper layers, 30.5 x 30.5 mm, 21 parts (0 on the bottom side), 10 nets.

Parts:
FID0: GRF_LOCAL_FIDUCIAL; Fiducial_0.5mm_Mask1.5mm
FID@1: GRF_LOCAL_FIDUCIAL; Fiducial_0.5mm_Mask1.5mm
J1: MOLEX_KK_HEADER_3-PIN_0.100-INCH; PinSocket_1x03_P2.54mm_Vertical_SMD_Pin1Right
M1, M11, M13: 0.5pF; C_0402_1005Metric
M2, M3, M4, M12: 100pF; C_0402_1005Metric
M5, M6, M9: 0 Ohm; R_0402_1005Metric
M7, M8: 0.1uF; C_0402_1005Metric
M10: 220nH WW; L_0402_1005Metric
RFIN0: SMA-142-0701-801/806; SMA_Molex_73251-1153_EdgeMount_Horizontal
RFOUT0: SMA-142-0701-801/806; SMA_Molex_73251-1153_EdgeMount_Horizontal
U$1: DFN-6_GENERICUPDATED; SON50P150X150X50-7N-D
U$2, U$3: GRF_LOCAL_FIDUCIAL; Fiducial_0.5mm_Mask1.5mm

Connections:
GND: J1.2, M1.2, M4.2, M7.2, M8.2, M11.2, M13.2, RFIN0.2 (Ext), RFOUT0.2 (Ext), U$1.2 (NC_1), U$1.5 (NC_2), U$1.7 (GND)
unnamed: J1.1, M5.2, M6.1
unnamed: J1.3, M6.2, M7.1, M8.1, M9.2, M10.1
unnamed: M2.2, M3.1
unnamed: M1.1, M2.1, RFIN0.1 (In)
unnamed: M12.1, M13.1, RFOUT0.1 (In)
unnamed: M9.1, U$1.6 (NC_3)
unnamed: M3.2, U$1.3 (RFIN)
unnamed: M10.2, M11.1, M12.2, U$1.4 (RFOUT/VD)
unnamed: M4.1, M5.1, U$1.1 (VEN)
