OpenAir-Lab/capstone-project/Documentation/Reference Designs/Texas Instruments/CC1120EM_169/CC1120EM_169.kicad_pcb

## KiCad design Documentation/Reference Designs/Texas Instruments/CC1120EM_169/CC1120EM_169.kicad_pcb (2025-07-19)

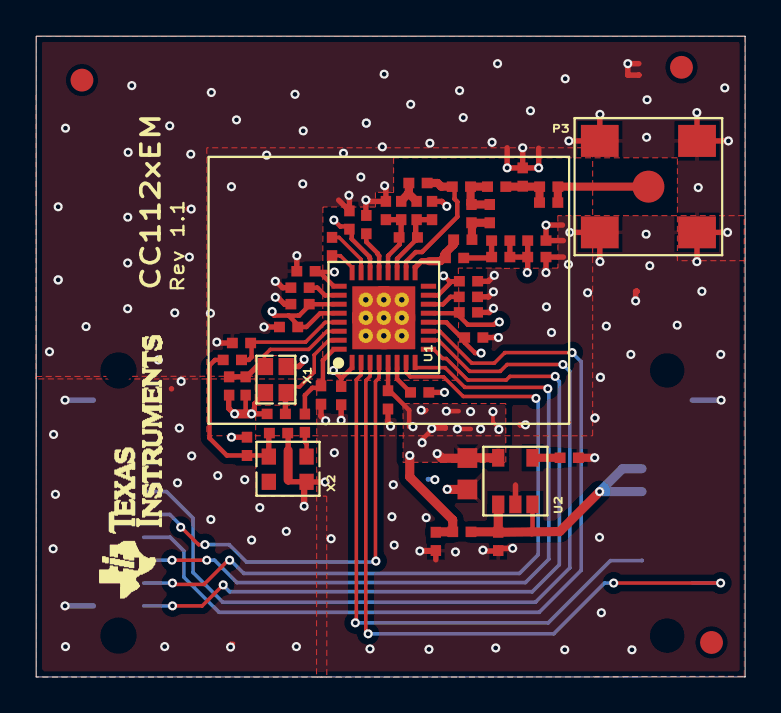
[picture p31: board CC1120EM_169.kicad_pcb from above]

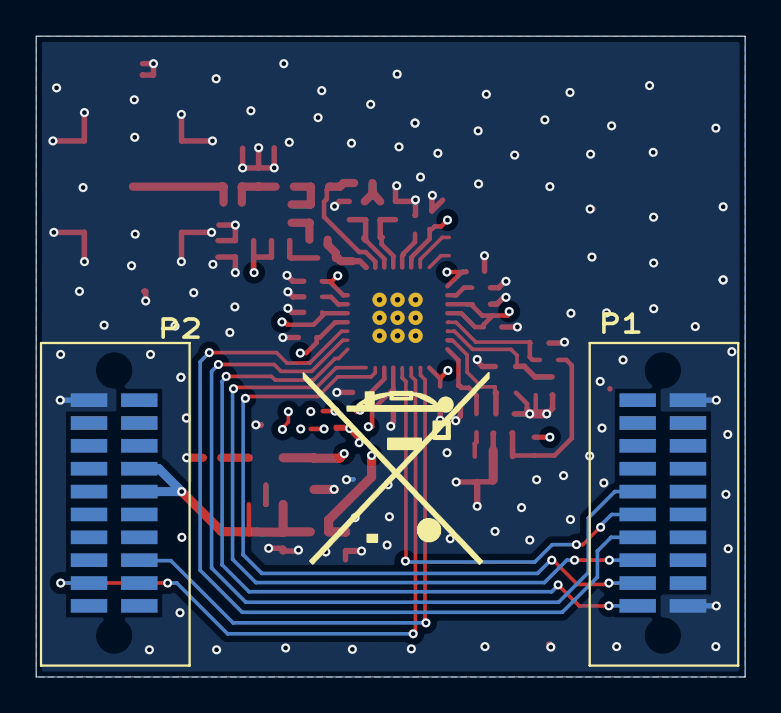
[picture p32: board CC1120EM_169.kicad_pcb from below]

Board: 4 copper layers, 39.4 x 35.6 mm, 57 parts (2 on the bottom side), 34 nets.

Parts:
C11, C51, C121, C131, C151, C221, C251, C261, C271, C281, C291: C_47N_0402_X7R_K_25; 0402 (REFLOW LF)
C12, C321: C_100N_0402_X5R_K_10; 0402 (REFLOW LF)
C41, C171, C211: C_10N_0402_X7R_K_25; 0402 (REFLOW LF)
C52: C_2U2_0603_X5R_K_10; 0603 (REFLOW)
C53, C302: C_0402; 0402 (REFLOW LF)
C61: C_220N_0402_X5R_K_10; 0402 (REFLOW LF)
C172, C173: C_100P_0402_NP0_J_50; 0402 (REFLOW LF)
C174: C_82P_0402_NP0_J_50; 0402 (REFLOW LF)
C175, C301, C311: C_15P_0402_NP0_J_50; 0402 (REFLOW LF)
C176, C181, C191, C201: C_12P_0402_NP0_J_50; 0402 (REFLOW LF)
C177: C_1P2_0402_NP0_B_50; 0402 (REFLOW LF)
C231: C_1N8_0402_U2J_J_10; 0402 (REFLOW LF)
C322: C_22P_0402_NP0_J_50; 0402 (REFLOW LF)
FM1, FM2, FM3: FIDUCIAL_MARK; FIDUCAL_MARK
L1: L_BEAD_102_0402; 0402 (REFLOW LF)
L171: L_220N_0402_J; 0402 (REFLOW LF)
L172: L_18N_0402_J_LQW; 0402 (REFLOW LF)
L173: L_100N_0402_J_LQW; 0402 (REFLOW LF)
L174: L_68N_0402_J_LQW; 0402 (REFLOW LF)
L191: L_150N_0402_J; 0402 (REFLOW LF)
L192, L201: L_82N_0402_J_LQW; 0402 (REFLOW LF)
L193: L_39N_0402_J_LQW; 0402 (REFLOW LF)
P1, P2: SMD_SOCKET_2X10; SFM SMD Socket 2x10
P3: SMA_SMD; SMA_SMD (Extended)
R12, R322: R_0_0402; 0402 (REFLOW LF)
R141: R_56K_0402_F; 0402 (REFLOW LF)
R171: R_22_0402_J; 0402 (REFLOW LF)
R321: R_0402; 0402 (REFLOW LF)
U1: CC112X; QFN32_RHM (DATASHEET)
U2: TPS79930; SOT23-5
X1: X_32.000/10/20/60/10; XTAL_SMD_2x1_6 (2.0x1.6mm no paste reduction)
X2: TG_5021CG; TCXO_TG_5021CG (2.5x2mm)

Connections:
3V3A: C12.1, L1.1, P2.7, P2.9, U2.1, U2.3
AGND: C11.1, C12.2, C41.2, C51.1, C52.2, C53.2, C61.2, C121.1, C131.1, C151.1, C171.2, C172.2, C175.2, C201.2, C211.2, C221.2, C251.1, C261.1, C271.1, C281.1, C291.1, C301.1, C302.1, C311.1, C321.1, L192.1, P1.1, P1.19, P2.2, P3.2, P3.3, P3.4, P3.5, R12.1, R141.2, U1.33, U2.2, X1.2, X1.4, X2.2
CSN: P1.14, U1.11
GPIO0: P1.10, U1.10
GPIO2: P1.12, U1.4
GPIO3: P2.18, U1.3
MISO: P1.20, U1.9
MOSI: P1.18, U1.7
unnamed: C41.1, U2.4
unnamed: C173.1, L171.2, R171.1
unnamed: C174.1, C176.1, L172.2
unnamed: C176.2, C181.2, L172.1, L173.2
unnamed: C201.1, L191.2, L201.2, U1.20
unnamed: C211.1, U1.21
unnamed: C231.1, U1.23
unnamed: C301.2, C302.2, U1.30, X1.3
unnamed: C322.1, X2.3
unnamed: C175.1, C177.1, L173.1, L174.2
unnamed: C191.2, L191.1, L192.2, U1.19
unnamed: C181.1, L193.1, U1.18
unnamed: C191.1, L193.2, L201.1
unnamed: C177.2, L174.1, P3.1
unnamed: C322.2, R12.2, U1.32
unnamed: C291.2, R321.2, U1.29
unnamed: C321.2, R321.1, R322.1, X2.4
unnamed: C61.1, U1.6
unnamed: R141.1, U1.14
unnamed: C174.2, L171.1, U1.17
unnamed: C231.2, U1.24
unnamed: C261.2, U1.26
unnamed: C311.2, U1.31, X1.1
RESET: P2.15, U1.2
SCLK: P1.16, U1.8
VDD_REG: C11.2, C51.2, C52.1, C53.1, C121.2, C131.2, C151.2, C171.1, C172.1, C173.2, C221.1, C251.2, C271.2, C281.2, L1.2, R171.2, R322.2, U1.1, U1.5, U1.12, U1.13, U1.15, U1.22, U1.25, U1.27, U1.28, U2.5
