OpenAir-Lab/capstone-project/Hardware/KiCAD/rf-amplifier-modulino/rf-amplifier-modulino.kicad_pcb

## KiCad design Hardware/KiCAD/rf-amplifier-modulino/rf-amplifier-modulino.kicad_pcb (2025-10-23)

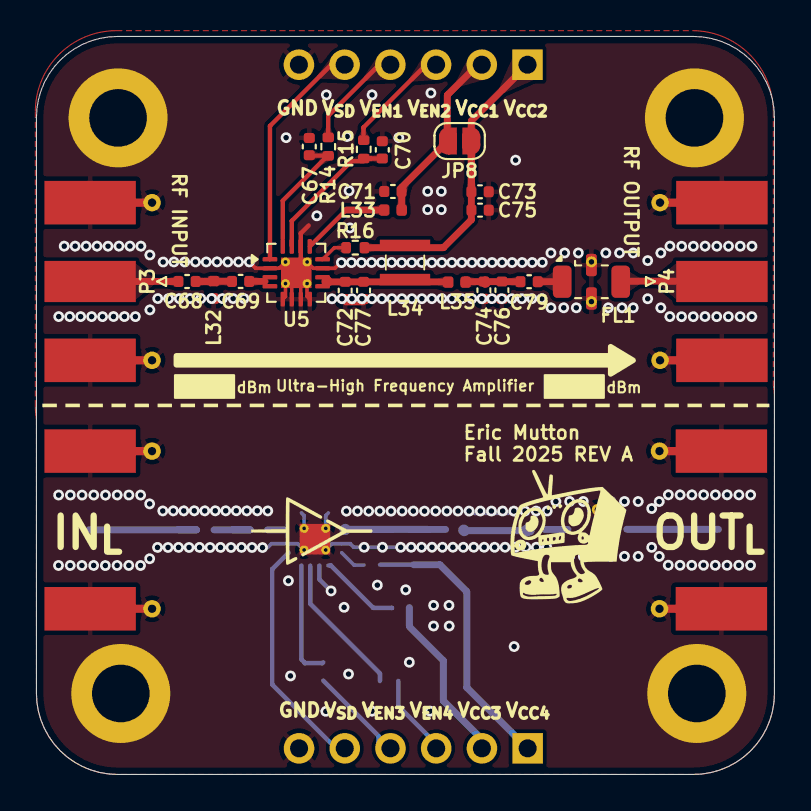
[picture p35: board rf-amplifier-modulino.kicad_pcb from above]

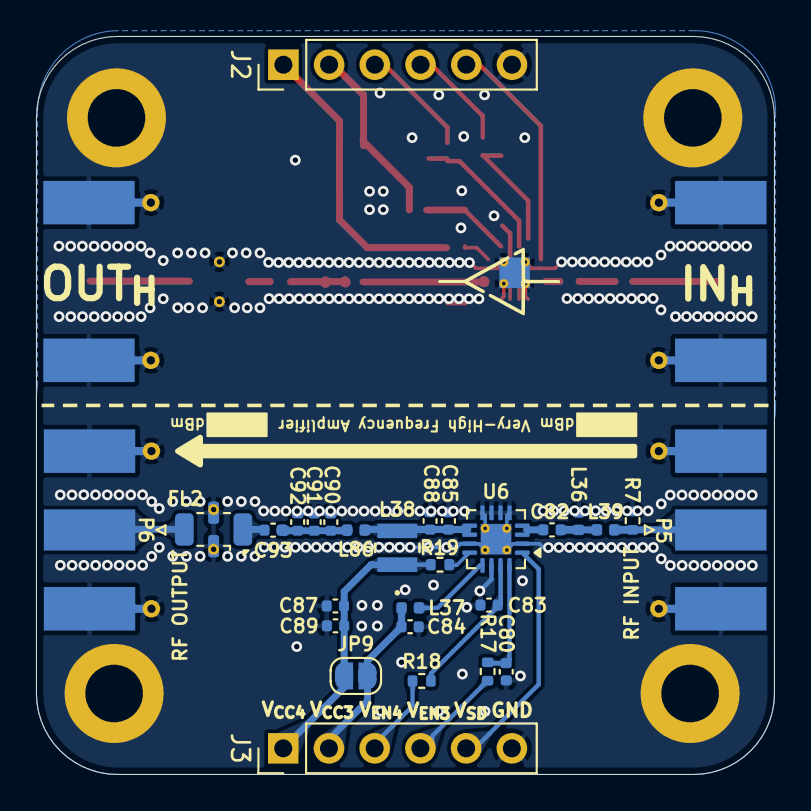
[picture p36: board rf-amplifier-modulino.kicad_pcb from below]

Board: 4 copper layers, 41.0 x 41.0 mm, 56 parts (28 on the bottom side), 32 nets.

Parts:
C67, C70, C75, C80, C83, C89: 1nF; C_0402_1005Metric
C68: 10pF; C_0402_1005Metric
C69, C72: 33pF; C_0402_1005Metric
C71: 0.1uF; C_0402_1005Metric
C73, C87: 10uF; C_0402_1005Metric
C74: 27pF; C_0402_1005Metric
C76: 3pF; C_0402_1005Metric
C77: 6.8pF; C_0402_1005Metric
C79, C88: 100pF; C_0402_1005Metric
C82, C93: 220pF; C_0402_1005Metric
C84: 1uF; C_0402_1005Metric
C85: 270pF; C_0402_1005Metric
C90, C91: 47pF; C_0402_1005Metric
C92: 18pF; C_0402_1005Metric
FL1: LFCN-490; Filter_Mini-Circuits_FV1206
FL2: LFCN-160; Filter_Mini-Circuits_FV1206
H1, H3, H4, H8: M3; MountingHole_3.2mm_M3_ISO14580_Pad
J2, J3: Conn_01x06_Pin; PinHeader_1x06_P2.54mm_Vertical
JP8, JP9: Single V_{CC}; SolderJumper-2_P1.3mm_Open_RoundedPad1.0x1.5mm
L32: 10nH; L_0402_1005Metric
L33: 20nH; L_0402_1005Metric
L34: 23nH; 0908SQ23NGLC
L35: 2.4nH; L_0402_1005Metric
L36: 150nH; L_0402_1005Metric
L37: 56nH; L_0402_1005Metric
L38: 1uH; IND_IMSC1008AZER_VIS
L39: 68nH; L_0402_1005Metric
L86: 9.1nH; L_0402_1005Metric
P3, P4, P5, P6: SMA; SMA_Molex_73251-1153_EdgeMount_Horizontal
R7: 350; R_0402_1005Metric
R14, R17: 1.27k; R_0402_1005Metric
R15, R18: 3.0k; R_0402_1005Metric
R16, R19: 0k; R_0402_1005Metric
U5, U6: GRF5604; QFN-16-1EP_3x3mm_P0.5mm_EP1.7x1.7mm_ThermalVias

Connections:
+3.3V: C71.1, C84.1, J2.2, J3.2, JP8.1 (A), JP9.1 (A), L33.1, L37.1
/RF Subsystem/RF Frontend/UHF 6W PA/RF_{IN}: C68.1, P3.1 (In)
/RF Subsystem/RF Frontend/UHF 6W PA/RF_{OUT}: C79.2, FL1.1 (IN)
/RF Subsystem/RF Frontend/UHF 6W PA/V_{CC2}: C73.1, C75.1, J2.1, JP8.2 (B), L34.1, R16.2
/RF Subsystem/RF Frontend/UHF 6W PA/V_{EN1}: C67.1, R14.1, U5.16 (V_{ENABLE1})
/RF Subsystem/RF Frontend/UHF 6W PA/V_{EN2}: C70.1, R15.1, U5.15 (V_{ENABLE2})
/RF Subsystem/RF Frontend/UHF 6W PA/V_{ENABLE1}: J2.4, R14.2
/RF Subsystem/RF Frontend/UHF 6W PA/V_{ENABLE2}: J2.3, R15.2
/RF Subsystem/RF Frontend/UHF 6W PA/V_{SHUTDOWN}: J2.5, U5.1 (V_{SHUTDOWN})
/RF Subsystem/RF Frontend/VHF 6W PA/RF_{IN}: L39.1, P5.1 (In), R7.2
/RF Subsystem/RF Frontend/VHF 6W PA/RF_{OUT}: C93.2, FL2.1 (IN)
/RF Subsystem/RF Frontend/VHF 6W PA/V_{CC2}: C87.1, C89.1, J3.1, JP9.2 (B), L38.1, R19.2
/RF Subsystem/RF Frontend/VHF 6W PA/V_{EN1}: C80.1, R17.1, U6.16 (V_{ENABLE1})
/RF Subsystem/RF Frontend/VHF 6W PA/V_{EN2}: C83.1, R18.1, U6.15 (V_{ENABLE2})
/RF Subsystem/RF Frontend/VHF 6W PA/V_{ENABLE1}: J3.4, R17.2
/RF Subsystem/RF Frontend/VHF 6W PA/V_{ENABLE2}: J3.3, R18.2
/RF Subsystem/RF Frontend/VHF 6W PA/V_{SHUTDOWN}: J3.5, U6.1 (V_{SHUTDOWN})
GND: C67.2, C70.2, C71.2, C72.2, C73.2, C74.2, C75.2, C76.2, C77.2, C80.2, C83.2, C84.2, C85.2, C87.2, C88.2, C89.2, C90.2, C91.2, C92.2, FL1.2 (GND), FL1.4 (GND), FL2.2 (GND), FL2.4 (GND), H1.1, H3.1, H4.1, H8.1, J2.6, J3.6, L32.2, L36.2, P3.2 (Ext), P4.2 (Ext), P5.2 (Ext), P6.2 (Ext), R7.1, U5.2 (GND/NC), U5.5 (GND/NC), U5.6 (GND/NC), U5.7 (GND/NC), U5.8 (GND/NC), U5.11 (GND/NC), U5.14 (GND/NC), U5.17 (PAD), U6.2 (GND/NC), U6.5 (GND/NC), U6.6 (GND/NC), U6.7 (GND/NC), U6.8 (GND/NC), U6.11 (GND/NC), U6.14 (GND/NC), U6.17 (PAD)
unnamed: C68.2, C69.1, L32.1
unnamed: C69.2, U5.3 (RF_{IN}), U5.4 (RF_{IN})
unnamed: C72.1, C77.1, L34.2, L35.1, U5.9 (RF_{OUT}), U5.10 (RF_{OUT})
unnamed: C74.1, C76.1, C79.1, L35.2
unnamed: C82.1, L36.1, L39.2
unnamed: C82.2, U6.3 (RF_{IN}), U6.4 (RF_{IN})
unnamed: C85.1, C88.1, L38.2, L86.1, U6.9 (RF_{OUT}), U6.10 (RF_{OUT})
unnamed: C90.1, C91.1, C92.1, C93.1, L86.2
unnamed: FL1.3 (OUT), P4.1 (In)
unnamed: FL2.3 (OUT), P6.1 (In)
unnamed: R16.1, U5.12 (V_{BIAS})
unnamed: L33.2, U5.13 (V_{CC1})
unnamed: R19.1, U6.12 (V_{BIAS})
unnamed: L37.2, U6.13 (V_{CC1})
