OpenAir-Lab/capstone-project/Hardware/KiCAD/hmi-modulino/hmi-modulino.kicad_pcb

## KiCad design Hardware/KiCAD/hmi-modulino/hmi-modulino.kicad_pcb (2025-12-09)

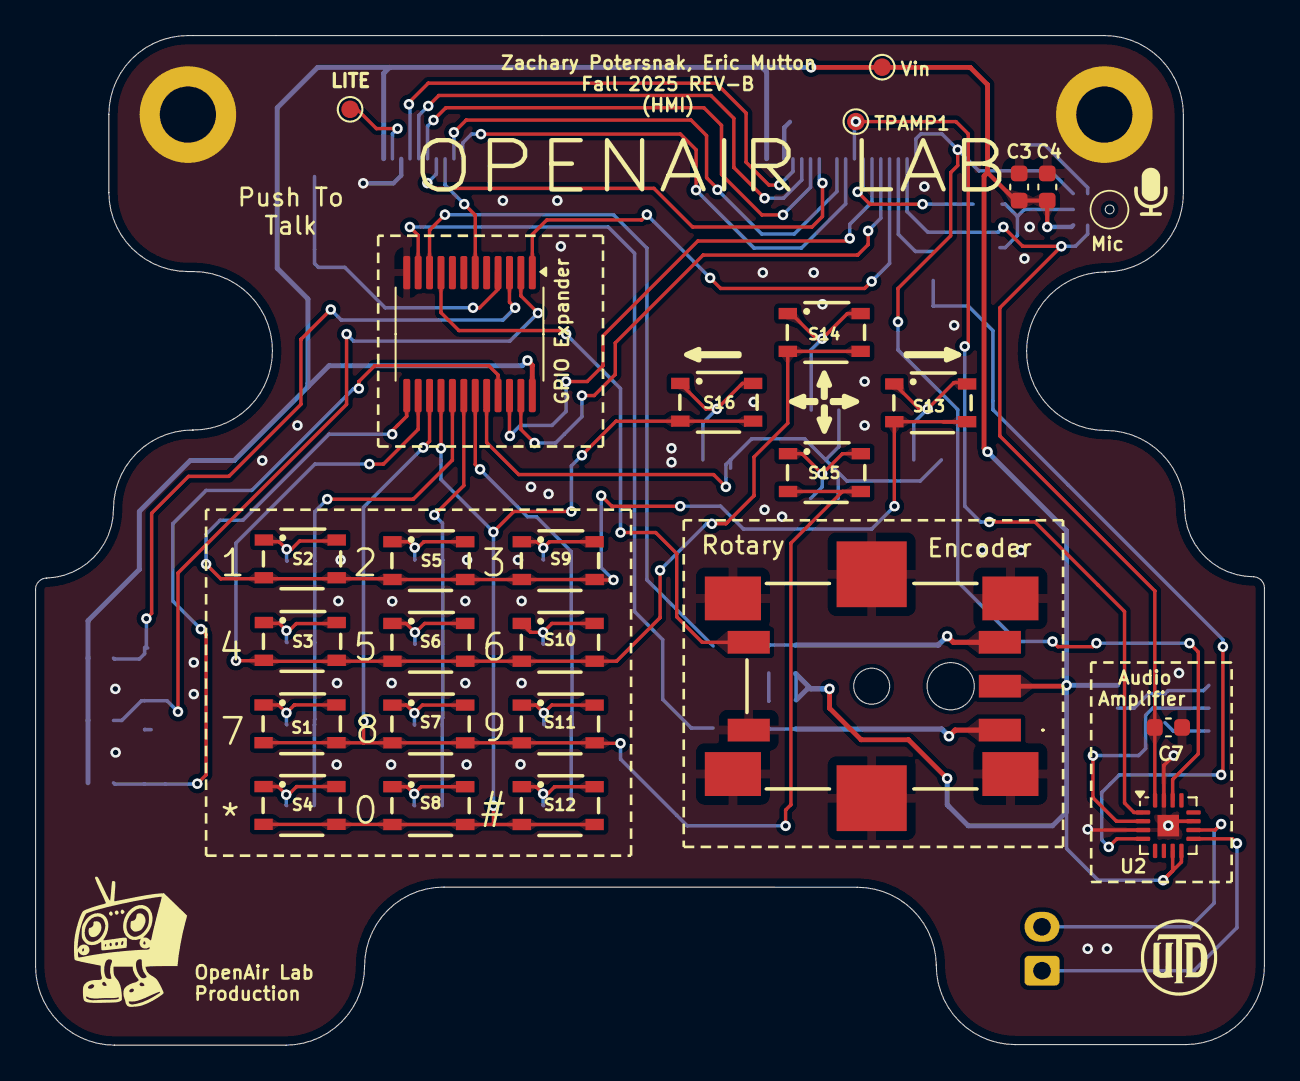
[picture p37: board hmi-modulino.kicad_pcb from above]

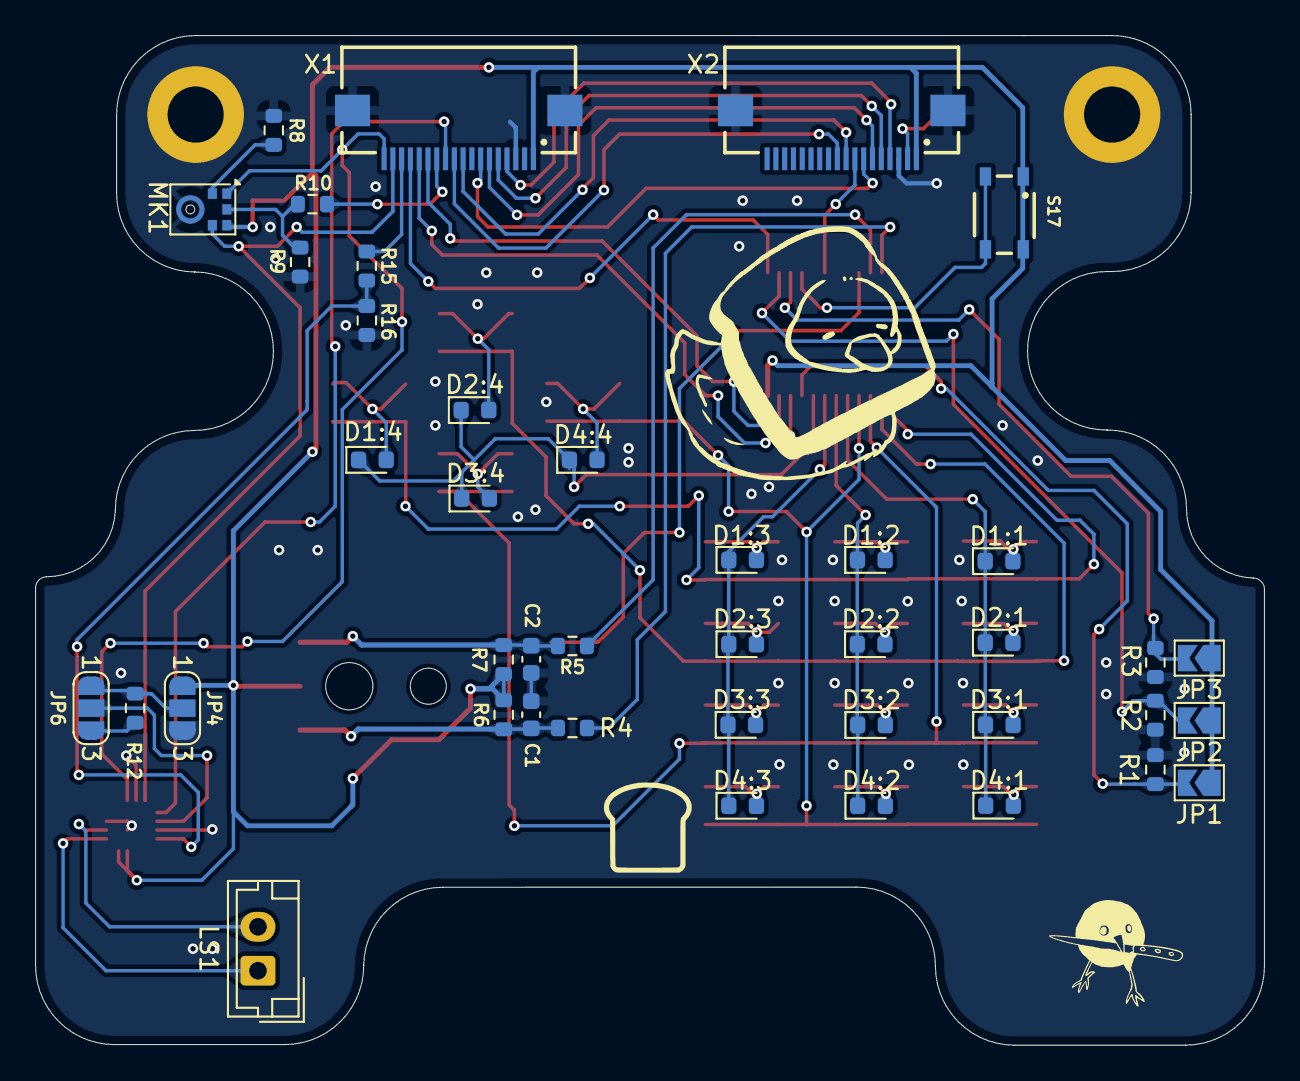
[picture p38: board hmi-modulino.kicad_pcb from below]

Board: 2 copper layers, 70.0 x 57.5 mm, 68 parts (41 on the bottom side), 58 nets.

Parts:
C1, C2: 0.01uF; C_0603_1608Metric
C3: 1uF; C_0603_1608Metric
C4: 0.1uF; C_0603_1608Metric
C7: 22pF; C_0603_1608Metric
D1:1, D1:2, D1:3, D1:4, D2:1, D2:2, D2:3, D2:4, D3:1, D3:2, D3:3, D3:4, D4:1, D4:2, D4:3, D4:4: D; D_0603_1608Metric
H1, H2: M3; MountingHole_3.2mm_M3_ISO14580_Pad
IC1: PCF8575PWR; SSOP-24_5.3x8.2mm_P0.65mm
JP1, JP2, JP3: SolderJumper_2_Open; SolderJumper-2_P1.3mm_Open_TrianglePad1.0x1.5mm
JP4: GAIN_{LOGIC}; SolderJumper-3_P1.3mm_Open_RoundedPad1.0x1.5mm_NumberLabels
JP6: GAIN_{R}; SolderJumper-3_P1.3mm_Open_RoundedPad1.0x1.5mm_NumberLabels
LS1: Speaker; JST_EH_B2B-EH-A_1x02_P2.50mm_Vertical
MK1: ICS-43434; InvenSense_ICS-43434-6_3.5x2.65mm
R1, R2, R3, R4, R5, R6, R7: 10k; R_0603_1608Metric
R8, R9: 47k; R_0603_1608Metric
R10: 68; R_0603_1608Metric
R12: 100k 5%; R_0603_1608Metric
R15: 2k; R_0603_1608Metric
R16: 100k; R_0603_1608Metric
S1, S2, S3, S4, S5, S6, S7, S8, S9, S10, S11, S12, S13, S14, S15, S16, S17: 434133025816
TP1: TestPoint; TestPoint_Pad_D1.0mm
TPAMP1: TestPoint_Pad_D1.0mm
U1: PEC11J-9215F-S0015; PEC11J9215FS0015
U2: MAX98357A; TQFN-16-1EP_3x3mm_P0.5mm_EP1.23x1.23mm
Vin: TestPoint; TestPoint_Pad_D1.0mm
X1, X2: EYESPI; Adafruit EYESPI FPC Connector

Connections:
+3.3V: C3.1, C4.1, IC1.24 (VCC), JP1.1 (A), JP2.1 (A), JP3.1 (A), JP4.1 (A), MK1.5 (VDD), R6.1, R7.2, S17.1, S17.2, U1.C1, U2.7 (VDD), U2.8 (VDD), Vin.1, X1.1, X2.1
/CARDCS: X1.10, X2.10
/Human-Machine Interface/AMP_DIN: TPAMP1.1, U2.1 (DIN), X1.11
/Human-Machine Interface/Audio/GAIN_SLOT: JP6.2 (C), U2.2 (GAIN_SLOT)
/Human-Machine Interface/Audio/~SD_MODE: R15.1, R16.2, U2.4 (~SD_MODE)
/Human-Machine Interface/BCLK: C7.1, MK1.4 (SCK), U2.16 (BCLK), X1.17
/Human-Machine Interface/ENC_CLK: IC1.11 (P7), R4.1
/Human-Machine Interface/ENC_DT: IC1.10 (P6), R5.1
/Human-Machine Interface/ENC_SW: IC1.9 (P5), U1.E1 (NO)
/Human-Machine Interface/Keypad/COL1: D1:1.1 (K), D2:1.1 (K), D3:1.1 (K), D4:1.1 (K), IC1.17 (P14)
/Human-Machine Interface/Keypad/COL2: D1:2.1 (K), D2:2.1 (K), D3:2.1 (K), D4:2.1 (K), IC1.18 (P15)
/Human-Machine Interface/Keypad/COL3: D1:3.1 (K), D2:3.1 (K), D3:3.1 (K), D4:3.1 (K), IC1.19 (P16)
/Human-Machine Interface/Keypad/COL4: D1:4.1 (K), D2:4.1 (K), D3:4.1 (K), D4:4.1 (K), IC1.20 (P17)
/Human-Machine Interface/Keypad/ROW1: IC1.13 (P10), S2.3, S2.4, S5.3, S5.4, S9.3, S9.4, S13.3, S13.4
/Human-Machine Interface/Keypad/ROW2: IC1.14 (P11), S3.3, S3.4, S6.3, S6.4, S10.3, S10.4, S14.3, S14.4
/Human-Machine Interface/Keypad/ROW3: IC1.15 (P12), S1.3, S1.4, S7.3, S7.4, S11.3, S11.4, S15.3, S15.4
/Human-Machine Interface/Keypad/ROW4: IC1.16 (P13), S4.3, S4.4, S8.3, S8.4, S12.3, S12.4, S16.3, S16.4
/Human-Machine Interface/LITE: TP1.1, X2.2
/Human-Machine Interface/LRCLK: MK1.1 (WS), U2.14 (LRCLK), X1.18
/Human-Machine Interface/MIC_DOUT: R10.2, X1.12
/Human-Machine Interface/PCF_A0: IC1.21 (A0), JP1.2 (B), R1.1
/Human-Machine Interface/PCF_A1: IC1.2 (A1), JP2.2 (B), R2.1
/Human-Machine Interface/PCF_A2: IC1.3 (A2), JP3.2 (B), R3.1
/Human-Machine Interface/TFTRST: IC1.6 (P2), X2.8
/Human-Machine Interface/~AMP_SD: R15.2, X1.16
/MISO: X1.6, X2.6
/MOSI: X1.5, X2.5
/SCK: X1.4, X2.4
/SCL: IC1.22 (SCL), X1.13
/SDA: IC1.23 (SDA), X1.14
/TFTCS: X1.9, X2.9
/TFTDC: X1.7, X2.7
GND: C1.2, C2.2, C3.2, C4.2, C7.2, H1.1, H2.1, IC1.12 (GND), JP4.3 (B), MK1.3 (GND), R1.2, R2.2, R3.2, R8.2, R9.2, R16.1, U1.D1 (COM), U1.MP1, U1.MP2, U1.MP3, U1.MP4, U1.MP5, U1.MP6, U2.3 (GND), U2.11 (GND), U2.15 (GND), U2.17 (PAD), X1.3, X1.Z1, X1.Z2, X2.3, X2.Z1, X2.Z2
unnamed: C1.1, R4.2, R6.2, U1.A1
unnamed: C2.1, R5.2, R7.1, U1.B1
unnamed: D1:1.2 (A), S2.1, S2.2
unnamed: D1:2.2 (A), S5.1, S5.2
unnamed: D1:3.2 (A), S9.1, S9.2
unnamed: D1:4.2 (A), S13.1, S13.2
unnamed: D2:1.2 (A), S3.1, S3.2
unnamed: D2:2.2 (A), S6.1, S6.2
unnamed: D2:3.2 (A), S10.1, S10.2
unnamed: D2:4.2 (A), S14.1, S14.2
unnamed: D3:1.2 (A), S1.1, S1.2
unnamed: D3:2.2 (A), S7.1, S7.2
unnamed: D3:3.2 (A), S11.1, S11.2
unnamed: D3:4.2 (A), S15.1, S15.2
unnamed: D4:1.2 (A), S4.1, S4.2
unnamed: D4:2.2 (A), S8.1, S8.2
unnamed: D4:3.2 (A), S12.1, S12.2
unnamed: D4:4.2 (A), S16.1, S16.2
unnamed: IC1.4 (P0), S17.3, S17.4
unnamed: JP4.2 (C), JP6.1 (A), R12.1
unnamed: JP6.3 (B), R12.2
unnamed: MK1.2 (LR), R8.1
unnamed: MK1.6 (SD), R9.1, R10.1
unnamed: LS1.2, U2.10 (OUTN)
unnamed: LS1.1, U2.9 (OUTP)
