OpenAir-Lab/capstone-project/Hardware/KiCAD/mcu-modulino/testbed-mcu.kicad_pcb

## KiCad design Hardware/KiCAD/mcu-modulino/testbed-mcu.kicad_pcb (2025-11-14)

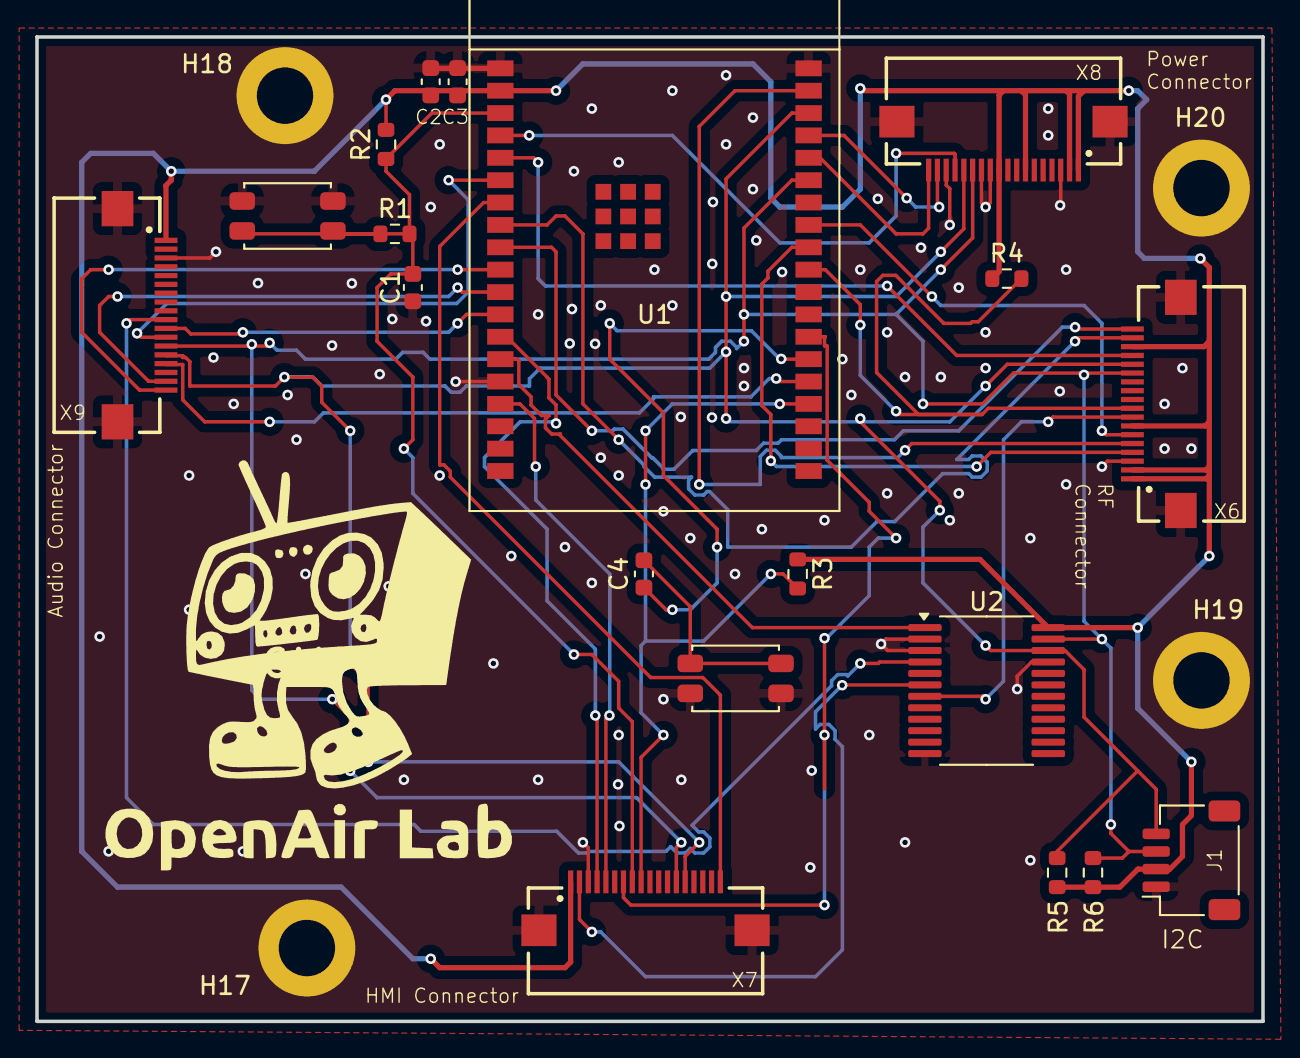
[picture p39: board testbed-mcu.kicad_pcb from above]

Board: 2 copper layers, 69.6 x 55.9 mm, 23 parts (0 on the bottom side), 31 nets.

Parts:
C1, C3, C4: 0.1u; C_0603_1608Metric
C2: 10u; C_0603_1608Metric
H17, H18, H19, H20: MountingHole_Pad; MountingHole_3.2mm_M3_ISO14580_Pad
J1: Stemma QT; JST_SH_SM04B-SRSS-TB_1x04-1MP_P1.00mm_Horizontal
R1, R2, R3, R4: 10k; R_0603_1608Metric
R5, R6: 4.7k; R_0603_1608Metric
SW1, SW2: SW_Push; SW_SPST_EVQP2_MiddlePushTravel_H2.5mm
U1: ESP32-WROVER-E; ESP32-WROVER-IE
U2: PCF8575DBR; SSOP-24_5.3x8.2mm_P0.65mm
X6, X7, X8, X9: EYESPI; Adafruit EYESPI FPC Connector

Connections:
+3.3V: C2.2, C3.2, J1.2, R2.2, R3.1, R4.1, R5.1, R6.1, U1.2 (3V3), U2.24 (VCC), X6.1, X6.2, X6.7, X6.16, X7.1, X8.1, X8.2, X8.7, X8.10, X9.1
/AMP_SD: U2.4 (P0), X9.10
/CC1200_RST: U2.7 (P3), X6.8
/MCU/AUDIO_INT: U1.24 (IO2), X9.15
/MCU/BCLK: U1.11 (GPIO26), X9.17
/MCU/BMS_INT: U1.4 (GPIO36), X8.15
/MCU/DIN: U1.6 (GPIO34), X9.12
/MCU/DOUT: U1.12 (GPIO27), X9.11
/MCU/HMI_INT: U1.7 (GPIO35), X7.18
/MCU/HSPI_CS: R3.2, U1.23 (IO15), X7.9
/MCU/HSPI_DC: U1.26 (GPIO4), X7.7
/MCU/HSPI_MOSI: U1.16 (GPIO13), X7.5
/MCU/HSPI_SCLK: U1.13 (GPIO14), X7.4
/MCU/LRCLK: U1.10 (GPIO25), X9.18
/MCU/RF_INT: U1.5 (GPIO39), X6.15
/MCU/RX0: U1.34 (RXD0), X8.18
/MCU/TX0: U1.35 (TXD0), X8.17
/MCU/VSPI_CS: R4.2, U1.29 (IO5), X6.9
/MCU/VSPI_GDO0: U1.8 (GPIO32), X6.17
/MCU/VSPI_GDO2: U1.9 (GPIO33), X6.18
/MCU/VSPI_MISO: U1.31 (GPIO19), X6.6
/MCU/VSPI_MOSI: U1.37 (GPIO23), X6.5
/MCU/VSPI_SCLK: U1.30 (GPIO18), X6.4
/MCU/X_INT: U1.14 (IO12), U2.1 (~INT)
/TFT_BL_EN: U2.6 (P2), X7.2
EN: C1.2, R1.1, R1.2, R2.1, SW1.2, U1.3 (EN), X7.8
GND: C1.1, C2.1, C3.1, H17.1, H18.1, H19.1, H20.1, J1.1, SW1.1, SW2.2, U1.1 (GND), U1.15 (GND), U1.38 (GND), U2.2 (A1), U2.3 (A2), U2.12 (GND), U2.21 (A0), X6.3, X6.Z1, X6.Z2, X7.3, X7.Z1, X7.Z2, X8.3, X8.11, X8.12, X8.16, X8.Z1, X8.Z2, X9.3, X9.Z1, X9.Z2
unnamed: C4.2, SW2.1
unnamed: C4.1, U1.25 (IO0)
SCL: J1.4, R5.2, U1.36 (GPIO22), U2.22 (SCL), X6.14, X7.14, X8.14, X9.14
SDA: J1.3, R6.2, U1.33 (GPIO21), U2.23 (SDA), X6.13, X7.13, X8.13, X9.13
