OpenAir-Lab/capstone-project/Hardware/KiCAD/rf-switch-modulino/rf-switch-modulino.kicad_pcb

## KiCad design Hardware/KiCAD/rf-switch-modulino/rf-switch-modulino.kicad_pcb (2025-10-23)

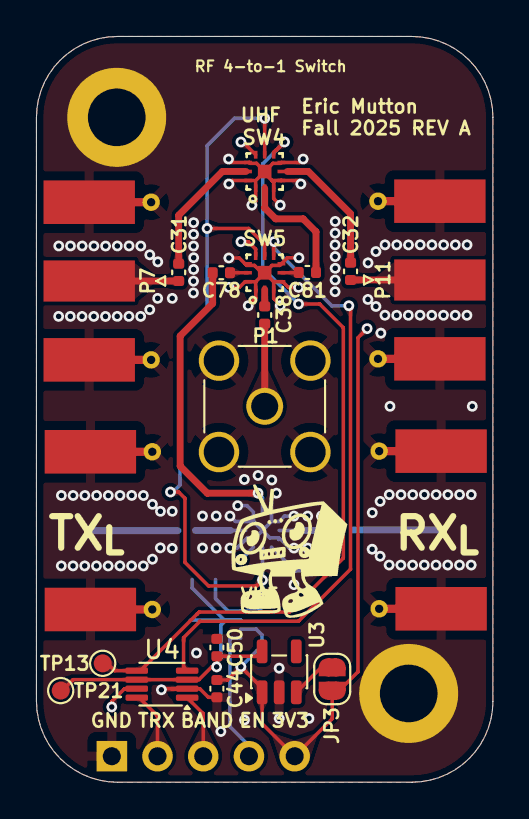
[picture p40: board rf-switch-modulino.kicad_pcb from above]

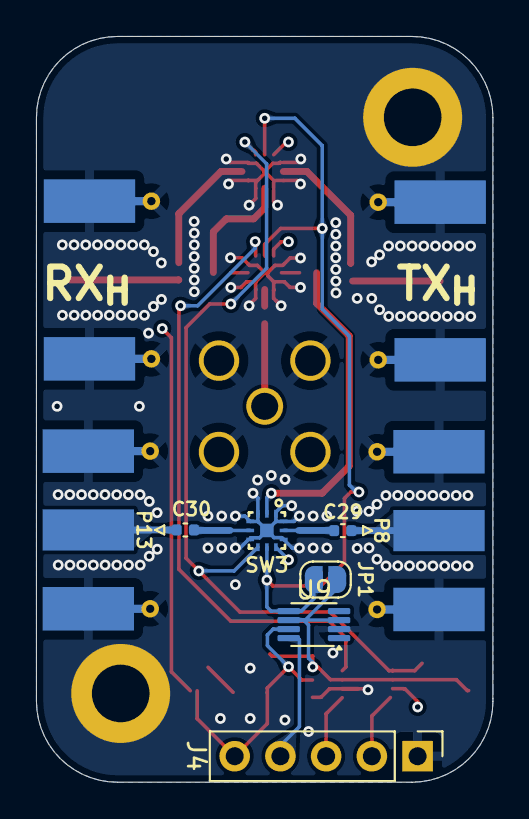
[picture p41: board rf-switch-modulino.kicad_pcb from below]

Board: 4 copper layers, 25.4 x 41.4 mm, 27 parts (8 on the bottom side), 24 nets.

Parts:
C29, C30, C31, C32, C78, C81: 1nF; C_0402_1005Metric
C38: 100pF; C_0402_1005Metric
C44, C50: 1uF; C_0402_1005Metric
H5, H6: M3; MountingHole_3.2mm_M3_ISO14580_Pad
J4: RF Switch; PinHeader_1x05_P2.54mm_Vertical
JP1, JP3: EN; SolderJumper-2_P1.3mm_Open_RoundedPad1.0x1.5mm
P1: SMA; SMA_Amphenol_901-144_Vertical
P7, P8, P11, P13: SMA; SMA_Molex_73251-1153_EdgeMount_Horizontal
SW3, SW4, SW5: SKY13330-397LF
TP13: TRX_SW_{+2.5V}; TestPoint_Pad_D1.0mm
TP21: +2.5V; TestPoint_Pad_D1.0mm
U3: LP5907MFX-2.5; SOT-23-5
U4, U9: TXS0101DBV; VSSOP-8_2.3x2mm_P0.5mm

Connections:
+2.5V: C50.2, JP1.1 (A), TP21.1, U3.5 (OUT), U4.3 (VCCA), U4.6 (OE), U9.3 (VCCA), U9.6 (OE)
+3.3V: C44.2, J4.5, JP3.1 (A), SW3.9 (VDD), SW4.9 (VDD), SW5.9 (VDD), U3.1 (IN), U4.7 (VCCB), U9.7 (VCCB)
/RF Subsystem/EN_{BAND}: JP1.2 (B), SW3.8 (EN), SW4.8 (EN), SW5.8 (EN), U9.5 (A1)
/RF Subsystem/RF Frontend/RX_{UHF}: C32.1, P11.1 (In)
/RF Subsystem/RF Frontend/RX_{VHF}: C30.1, P13.1 (In)
/RF Subsystem/RF Frontend/TX_{UHF}: C31.1, P7.1 (In)
/RF Subsystem/RF Frontend/TX_{VHF}: C29.1, P8.1 (In)
/RF Subsystem/RFSW_{BAND}: J4.3, U4.1 (B2)
/RF Subsystem/RFSW_{EN}: J4.4, U9.8 (B1)
/RF Subsystem/RFSW_{TRX}: J4.2, U4.8 (B1)
/RF Subsystem/SW_BAND: SW5.7 (CTRL), U4.4 (A2)
/RF Subsystem/SW_TRX: SW3.7 (CTRL), SW4.7 (CTRL), TP13.1, U4.5 (A1)
GND: C44.1, C50.1, H5.1, H6.1, J4.1, P1.2 (Ext), P7.2 (Ext), P8.2 (Ext), P11.2 (Ext), P13.2 (Ext), SW3.1 (GND), SW3.3 (GND), SW3.4 (GND), SW3.6 (GND), SW3.10 (GND), SW3.12 (GND), SW3.13 (GND), SW4.1 (GND), SW4.3 (GND), SW4.4 (GND), SW4.6 (GND), SW4.10 (GND), SW4.12 (GND), SW4.13 (GND), SW5.1 (GND), SW5.3 (GND), SW5.4 (GND), SW5.6 (GND), SW5.10 (GND), SW5.12 (GND), SW5.13 (GND), U3.2 (GND), U4.2 (GND), U9.2 (GND)
unnamed: JP3.2 (B), U3.3 (EN)
unnamed: C38.1, P1.1 (In)
unnamed: C78.1, SW3.2 (RF1_COM)
unnamed: C29.2, SW3.11 (RF2)
unnamed: C30.2, SW3.5 (RF3)
unnamed: C81.1, SW4.2 (RF1_COM)
unnamed: C31.2, SW4.11 (RF2)
unnamed: C32.2, SW4.5 (RF3)
unnamed: C38.2, SW5.2 (RF1_COM)
unnamed: C78.2, SW5.11 (RF2)
unnamed: C81.2, SW5.5 (RF3)
