OpenAir-Lab/capstone-project/Hardware/KiCAD/audio-modulino/Audio PCB.kicad_pcb

## KiCad design Hardware/KiCAD/audio-modulino/Audio PCB.kicad_pcb (2025-11-06)

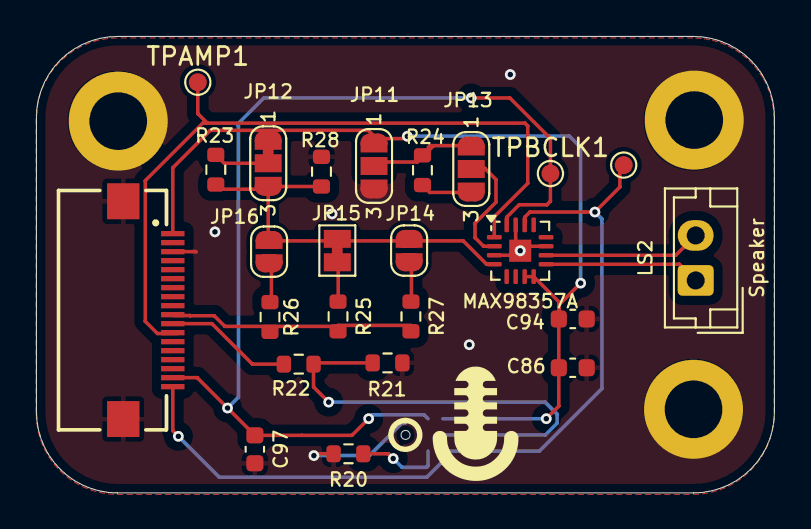
[picture p42: board Audio PCB.kicad_pcb from above]

Board: 2 copper layers, 41.0 x 25.4 mm, 28 parts (1 on the bottom side), 19 nets.

Parts:
C86: 1uF; C_0603_1608Metric
C94: 0.1uF; C_0603_1608Metric
C97: 22pF; C_0603_1608Metric
H13, H15, H16: M3; MountingHole_3.2mm_M3_ISO14580_Pad
JP11: GAIN_{LOGIC}; SolderJumper-3_P1.3mm_Open_RoundedPad1.0x1.5mm_NumberLabels
JP12: Driver; SolderJumper-3_P1.3mm_Bridged12_RoundedPad1.0x1.5mm_NumberL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
JP13: GAIN_{R}; SolderJumper-3_P1.3mm_Open_RoundedPad1.0x1.5mm_NumberLabels
JP14: CH_LEFT; SolderJumper-2_P1.3mm_Open_RoundedPad1.0x1.5mm
JP15: CH_MONO_MIX; SolderJumper-2_P1.3mm_Bridged_Pad1.0x1.5mm
JP16: CH_RIGHT; SolderJumper-2_P1.3mm_Open_RoundedPad1.0x1.5mm
LS2: Speaker; JST_EH_B2B-EH-A_1x02_P2.50mm_Vertical
MK2: ICS-43434; InvenSense_ICS-43434-6_3.5x2.65mm
R20, R21: 47k; R_0603_1608Metric
R22: 68; R_0603_1608Metric
R23, R27: 2k; R_0603_1608Metric
R24: 100k 5%; R_0603_1608Metric
R25: 634k; R_0603_1608Metric
R26: 330k; R_0603_1608Metric
R28: 100k; R_0603_1608Metric
TPAMP1: TestPoint_Pad_D1.0mm
TPBCLK1: TestPoint_Pad_D1.0mm
TPLRCLK1: TestPoint_Pad_D1.0mm
U7: MAX98357A; TQFN-16-1EP_3x3mm_P0.5mm_EP1.23x1.23mm
X2: EYESPI; Adafruit EYESPI FPC Connector

Connections:
+3.3V: C86.1, C94.1, JP11.1 (A), JP12.1 (A), MK2.5 (VDD), U7.7 (VDD), U7.8 (VDD), X2.1
/AMP_DIN: TPAMP1.1, U7.1 (DIN), X2.12
/Audio Subsystem/GAIN_SLOT: JP13.2 (C), U7.2 (GAIN_SLOT)
/Audio Subsystem/~SD_MODE: JP12.3 (B), JP14.2 (B), JP15.2 (B), JP16.2 (B), R23.2, R28.2, U7.4 (~SD_MODE)
/BCLK: C97.1, MK2.4 (SCK), TPBCLK1.1, U7.16 (BCLK), X2.17
/LRCLK: MK2.1 (WS), TPLRCLK1.1, U7.14 (LRCLK), X2.18
/MIC_DOUT: R22.2, X2.11
/~AMP_SD: R25.2, R26.1, R27.2, X2.10
GND: C86.2, C94.2, C97.2, H13.1, H15.1, H16.1, JP11.3 (B), MK2.3 (GND), R20.2, R21.2, R28.1, U7.3 (GND), U7.11 (GND), U7.15 (GND), U7.17 (PAD), X2.3, X2.Z1, X2.Z2
unnamed: JP11.2 (C), JP13.1 (A), R24.1
unnamed: JP12.2 (C), R23.1
unnamed: JP13.3 (B), R24.2
unnamed: JP14.1 (A), R27.1
unnamed: JP15.1 (A), R25.1
unnamed: JP16.1 (A), R26.2
unnamed: MK2.2 (LR), R20.1
unnamed: MK2.6 (SD), R21.1, R22.1
unnamed: LS2.2, U7.10 (OUTN)
unnamed: LS2.1, U7.9 (OUTP)
