OpenAir-Lab/capstone-project/Documentation/Reference Designs/Texas Instruments/BOOSTXL-BATPAKMKII/Hardware/BOOSTXL-BATPAKMKII.brd

## EAGLE design Documentation/Reference Designs/Texas Instruments/BOOSTXL-BATPAKMKII/Hardware/BOOSTXL-BATPAKMKII.brd (2025-07-19)

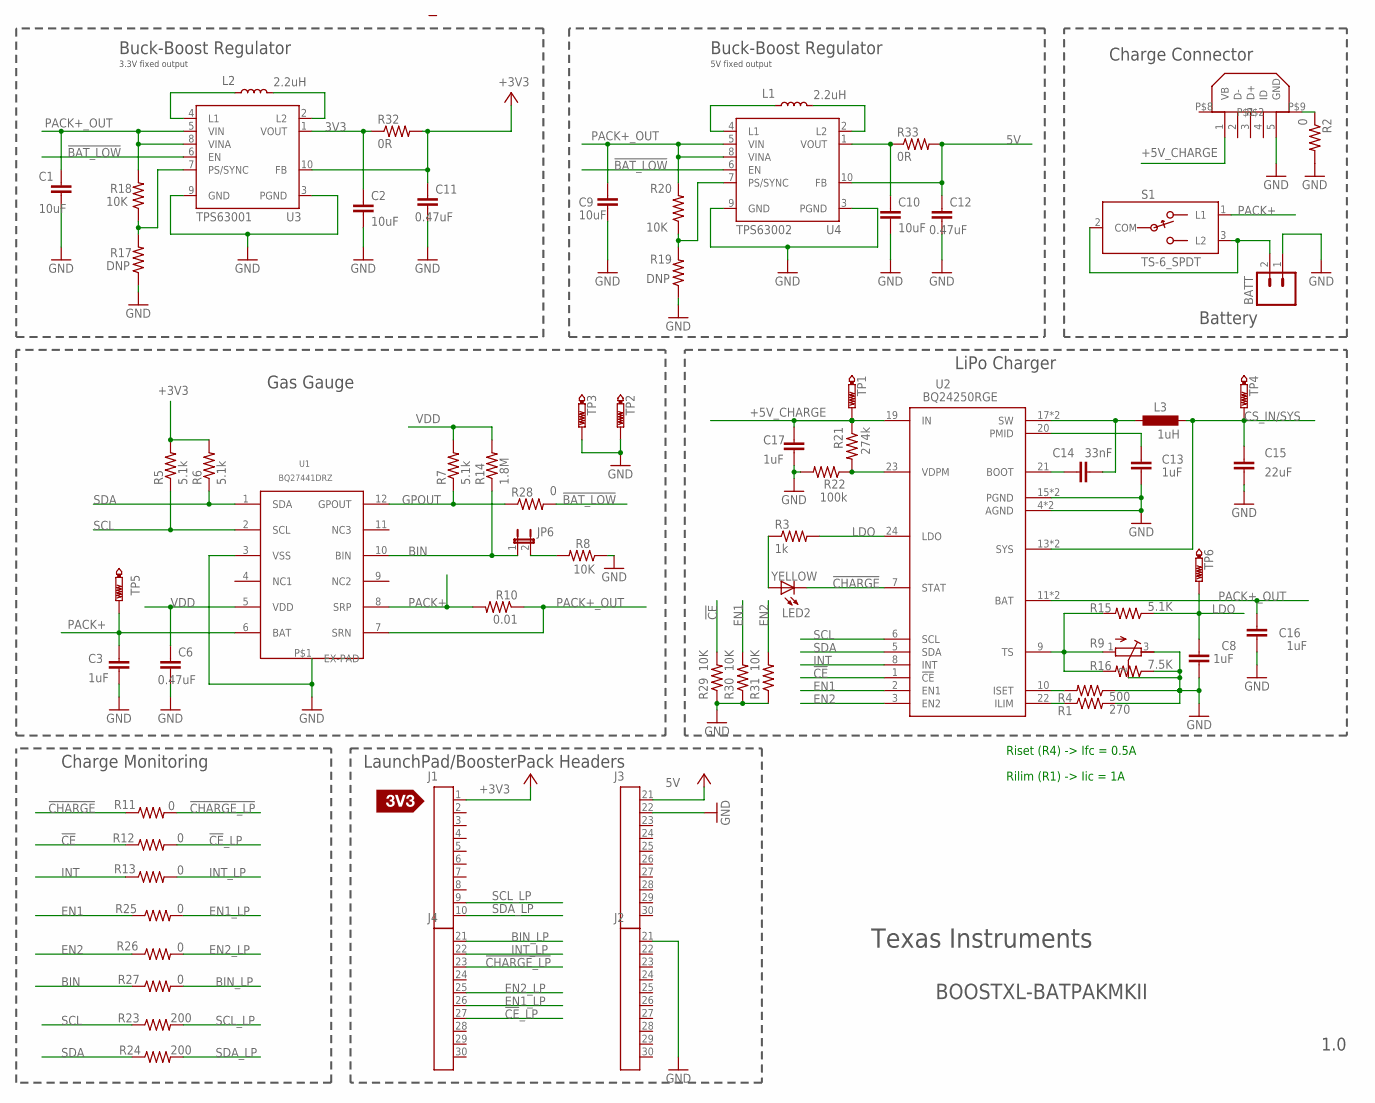
[picture p43: schematic BOOSTXL-BATPAKMKII.sch]

Parts:
BATT: M02-JST-2MM-SMT; JST-2-SMD
C1, C2, C9, C10: 10uF; C0603
C3, C8, C13, C16, C17: 1uF; C0603
C6, C11, C12: 0.47uF; C0603
C14: 33nF; C0603
C15: 22uF; C0603
J1: HEADER1X10; 1X10
J2, J3, J4: HEADER1X10-J3; 1X10-J3
JP6: JP1E; JP1
L1, L2: 2.2uH; VLF4102A
L3: 1uH; L3216C
LED2: YELLOW; RIGHTANGLE_1208
R1: 270; R0603
R2, R11, R12, R13, R25, R26, R27, R28: 0; R0603
R3: 1k; R0603
R4: 500; R0603
R5, R6, R7: 5.1k; R0603
R8, R18, R20, R29, R30, R31: 10K; R0603
R9: R-TRIMM3296W; RTRIM3296W
R10: 0.01; R1206
R14: 1.8M; R0603
R15: 5.1K; R0603
R16: 7.5K; R0603
R17, R19: DNP; R0603
R21: 274k; R0603
R22: 100k; R0603
R23, R24: 200; R0603
R32, R33: 0R; R0805
S1: TS-6_SPDT
TP1, TP2, TP3, TP4, TP5, TP6: PTR1PAD1-13; P1-13
U1: BQ27441DRZ; DRZ12
U2: BQ24250RGE; TI_RGE24
U3: TPS63001; DRC-S-PVSON-N10
U4: TPS63002; DRC-S-PVSON-N10
U$1: SILK_3V3_TAG
U$2: MS_(TM)
USB: CONN_USB_MICRO_B; USB_MICRO_B_SMT

Connections:
3V3: C2.1, R32.1, U3.1 (VOUT)
5V: C12.1, J3.21 (1), R33.2, U4.10 (FB)
!BAT_LOW: R28.2, U3.6 (EN), U4.6 (EN)
!CE: R12.1, R29.2, U2.1 (!CE)
!CE!_LP: J4.27 (7), R12.2
!CHARGE: LED2.CATHODE (C), R11.1, U2.7 (STAT)
!CHARGE_LP: J4.23 (3), R11.2
+3V3: C11.1, J1.1, R5.2, R6.2, R32.2, U3.10 (FB)
+5V_CHARGE: C17.1, R21.1, TP1.TP, U2.19 (IN), USB.1 (VB)
BIN: JP6.1, R14.1, R27.1, U1.10 (BIN)
BIN_LP: J4.21 (1), R27.2
CS_IN/SYS: C15.1, L3.2, TP4.TP, U2.13 (SYS), U2.14 (SYS)
EN1: R25.1, R30.2, U2.2 (EN1)
EN1_LP: J4.26 (6), R25.2
EN2: R26.1, R31.2, U2.3 (EN2)
EN2_LP: J4.25 (5), R26.2
GND: BATT.1, C1.2, C2.2, C3.2, C6.2, C8.2, C9.2, C10.2, C11.2, C12.2, C13.2, C15.2, C16.2, C17.2, J2.21 (1), J3.22 (2), R1.2, R2.2, R4.1, R8.1, R9.2 (S), R9.3 (A), R16.1, R17.1, R19.1, R22.2, R29.1, R30.1, R31.1, TP2.TP, TP3.TP, U1.3 (VSS), U1.P$1 (EX-PAD), U2.4 (AGND), U2.15 (PGND), U2.16 (PGND), U2.P$1 (AGND), U3.3 (PGND), U3.9 (GND), U4.3 (PGND), U4.9 (GND), USB.5 (GND)
GPOUT: R7.1, R28.1, U1.12 (GPOUT)
INT: R13.1, U2.8 (INT)
INT_LP: J4.22 (2), R13.2
LDO: C8.1, R3.2, R15.1, TP6.TP, U2.24 (LDO)
unnamed: L2.P$3, U3.4 (L1)
unnamed: L2.P$1, U3.2 (L2)
unnamed: L1.P$3, U4.4 (L1)
unnamed: JP6.2, R8.2
unnamed: LED2.ANODE (A), R3.1
unnamed: L1.P$1, U4.2 (L2)
unnamed: R9.1 (E), R15.2, R16.2, U2.9 (TS)
unnamed: R21.2, R22.1, U2.23 (VDPM)
unnamed: C13.1, U2.20 (PMID)
unnamed: C14.1, U2.21 (BOOT)
unnamed: C14.2, L3.1, U2.17 (SW), U2.18 (SW)
unnamed: BATT.2, S1.2 (COM), S1.3 (L2)
unnamed: R4.2, U2.10 (ISET)
unnamed: R2.1, USB.P$9
unnamed: R17.2, R18.1, U3.7 (PS/SYNC)
unnamed: R19.2, R20.1, U4.7 (PS/SYNC)
unnamed: R1.1, U2.22 (ILIM)
unnamed: C10.1, R33.1, U4.1 (VOUT)
PACK+: C3.1, R10.2, S1.1 (L1), TP5.TP, U1.6 (BAT), U1.8 (SRP)
PACK+_OUT: C1.1, C9.1, C16.1, R10.1, R18.2, R20.2, U1.7 (SRN), U2.11 (BAT), U2.12 (BAT), U3.5 (VIN), U3.8 (VINA), U4.5 (VIN), U4.8 (VINA)
SCL: R5.1, R23.1, U1.2 (SCL), U2.6 (SCL)
SCL_LP: J1.9, R23.2
SDA: R6.1, R24.1, U1.1 (SDA), U2.5 (SDA)
SDA_LP: J1.10, R24.2
VDD: C6.1, R7.2, R14.2, U1.5 (VDD)

Notes on the sheet:
LiPo Charger
Battery
Gas Gauge
Buck-Boost Regulator
3.3V fixed output
5V fixed output
Charge Connector
Charge Monitoring
1.0
LaunchPad/BoosterPack Headers
Riset (R4) -> Ifc = 0.5A
Rilim (R1) -> Iic = 1A

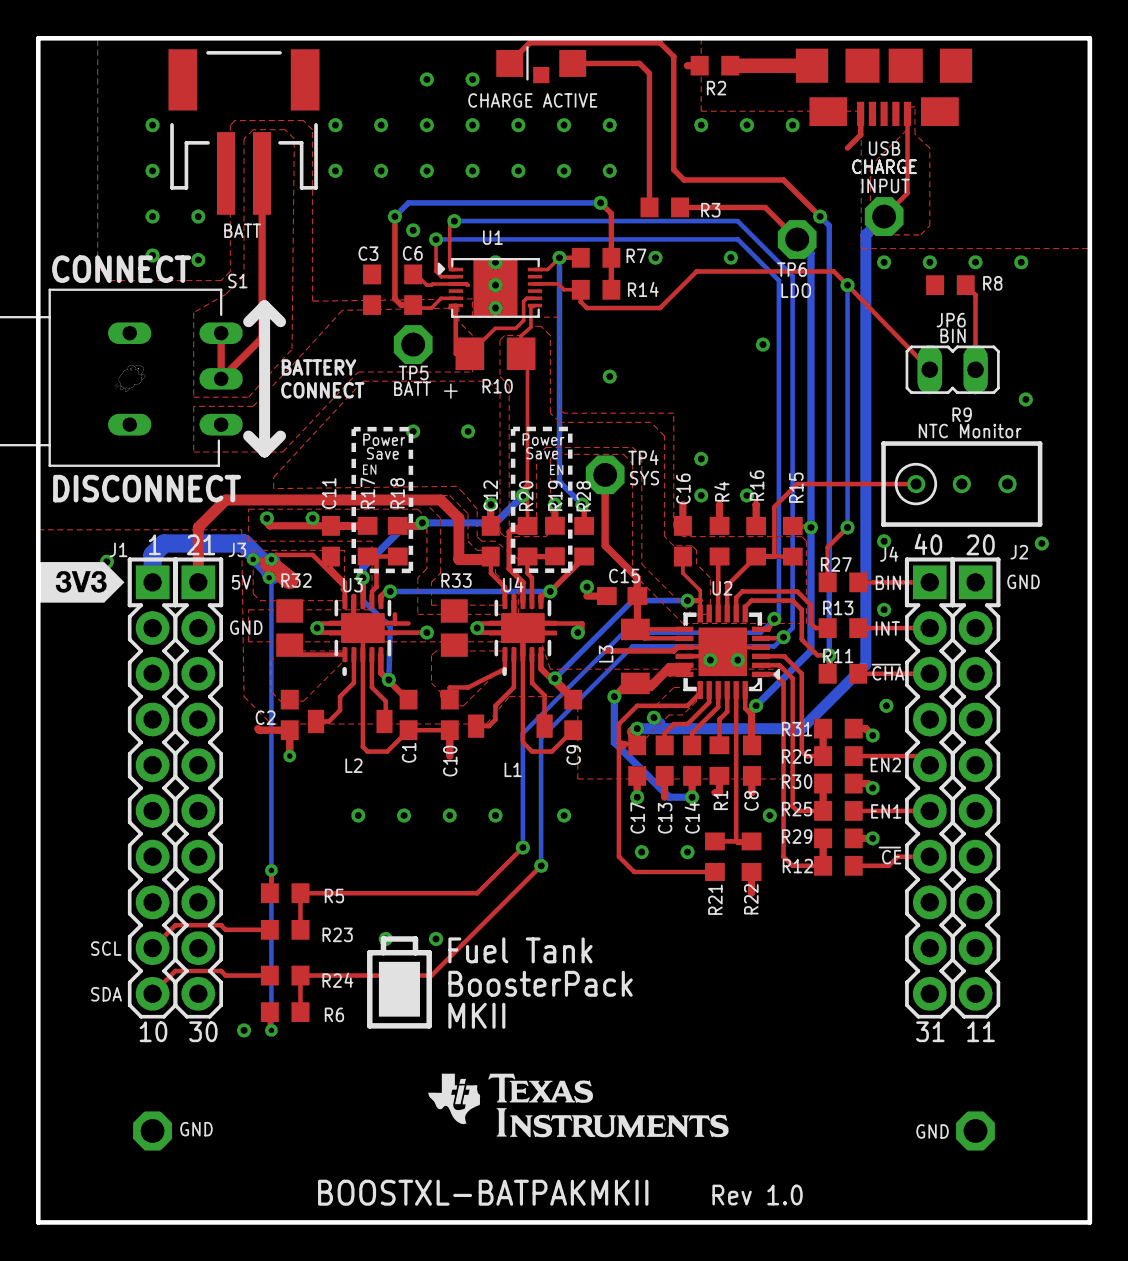
[picture p44: board BOOSTXL-BATPAKMKII.brd from above]

Board: 2 copper layers, 58.4 x 65.8 mm, 73 parts (0 on the bottom side), 46 nets.

Other parts of the board:
DRAW3: LOGO-ROCKET-10X7MM-BRD
U$4: LOGO16_TPLACE
