OpenAir-Lab/capstone-project/Documentation/Reference Designs/Guerrilla RF/GRF-DFN6-15-23A/DFN6-15-23-A.brd

## EAGLE design Documentation/Reference Designs/Guerrilla RF/GRF-DFN6-15-23A/DFN6-15-23-A.brd (2025-07-19)

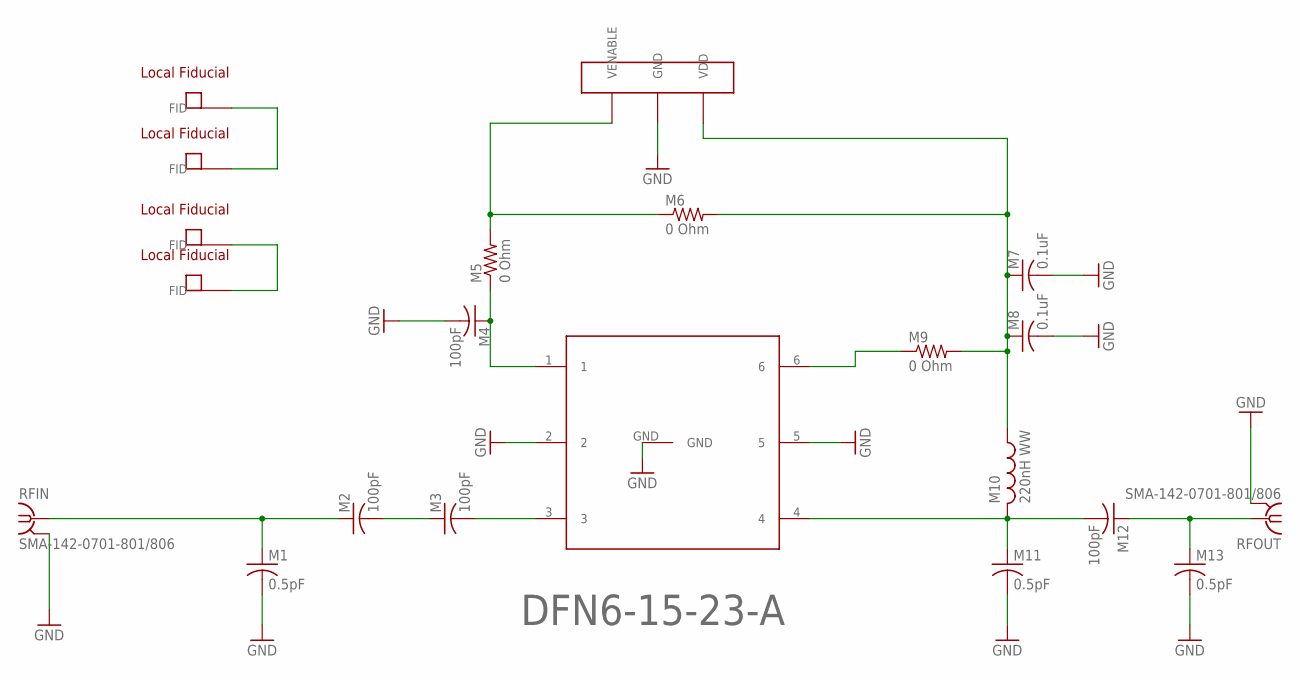
[picture p45: schematic DFN6-15-23-A.sch]

Parts:
FID: GRF_LOCAL_FIDUCIAL
FID@1: GRF_LOCAL_FIDUCIAL
J1: MOLEX_KK_HEADER_3-PIN_0.100-INCH
M1, M11, M13: 0.5pF; RCL_C0402_GRF
M2, M3, M12: 100pF; RCL_C0402_GRF
M4: 100pF; C0402
M5, M6, M9: 0 Ohm; R0402
M7, M8: 0.1uF; C0402
M10: 220nH WW; L0402
RFIN: SMA-142-0701-801/806; J502-ND-142-0701-801/806
RFOUT: SMA-142-0701-801/806; J502-ND-142-0701-801/806
U$1: DFN-6_GENERICUPDATED; DFN-6_1.5X1.5MM_FIXED
U$2, U$3: GRF_LOCAL_FIDUCIAL

Connections:
FID: FID.FID, FID@1.FID
FID1: U$2.FID, U$3.FID
GND: J1.GND, M1.2, M4.2, M7.2, M8.2, M11.2, M13.2, RFIN.G@1 (2), RFIN.G@2 (2), RFIN.G@3 (2), RFIN.G@4 (2), RFOUT.G@1 (2), RFOUT.G@2 (2), RFOUT.G@3 (2), RFOUT.G@4 (2), U$1.2, U$1.5, U$1.GND
unnamed: M3.2, U$1.3
unnamed: J1.VENABLE, M5.2, M6.1
unnamed: M1.1, M2.1, RFIN.1
unnamed: M4.1, M5.1, U$1.1
unnamed: M10.2, M11.1, M12.2, U$1.4
unnamed: M12.1, M13.1, RFOUT.1
unnamed: M9.1, U$1.6
unnamed: J1.VDD, M6.2, M7.1, M8.1, M9.2, M10.1
unnamed: M2.2, M3.1

Notes on the sheet:
DFN6-15-23-A

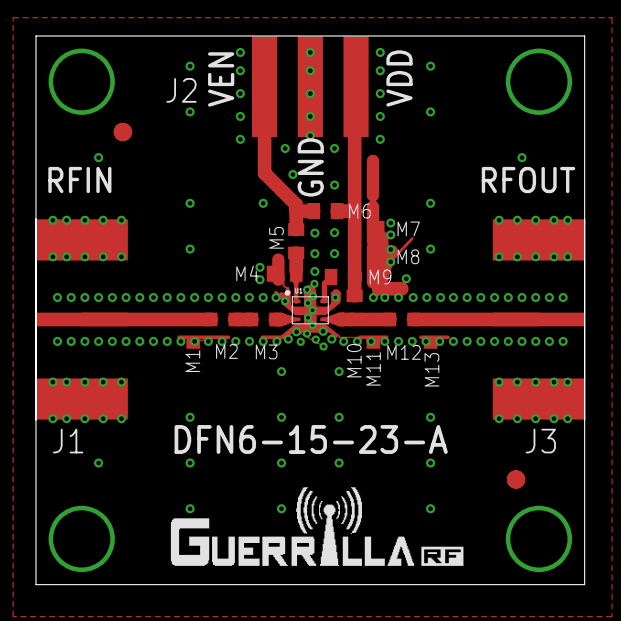
[picture p46: board DFN6-15-23-A.brd from above]

Board: 4 copper layers, 30.5 x 30.5 mm, 22 parts (0 on the bottom side), 12 nets.

Other parts of the board:
DRILEGEND: DRILEGEND
