OpenAir-Lab/capstone-project/Documentation/RF Subsystem/Radio Transceiver/cc1200/nc_param.txt

INTEGER-PLACES         2
DECIMAL-PLACES         3
X-OFFSET               0.000000
Y-OFFSET               0.000000
FEEDRATE               1
COORDINATES            ABSOLUTE
OUTPUT-UNITS           ENGLISH
TOOL-ORDER             INCREASING
REPEAT-CODES           YES
SUPPRESS-LEAD-ZEROES   NO
SUPPRESS-TRAIL-ZEROES  NO
SUPPRESS-EQUAL         NO
TOOL-SELECT            YES
OPTIMIZE_DRILLING      NO
ENHANCED_EXCELLON      NO
HEADER                 none
LEADER                 12
CODE                   ASCII
SEPARATE               YES
DRILLING               LAYER-PAIR
BACKDRILL              NO
CAVITY                 NO
