OpenAir-Lab/capstone-project/(commit log)

2025-07-19 feat: begin recapture & document RF Power Amplifier
    [DFN6-15-23-A.brd, DFN6-15-23-A.sch, GRF-DFN6-15-23A.kicad_pcb, GRF-DFN6-15-23A.kicad_sch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]
2025-07-19 feat: begin recapture & document RF Transceiver
    [CC-Antenna-DK - Rev 1_0_2 BOM and XY Coordinates.xls, CC1120EM_169.kicad_pcb, CC1120EM_169.kicad_sch, CC1120EM_169_Partlist.xls, CC112xEM.pcb, CC1200EMK-420-470.kicad_pcb, CC1200EMK-420-470.kicad_sch, CC120X vs CC112X.xlsx]
2025-07-19 feat: recapture and documentation on BMS IC's
    [BMS_Schematics.kicad_sch, BOOSTXL-BATPAKMKII.brd, BOOSTXL-BATPAKMKII.kicad_pcb, BOOSTXL-BATPAKMKII.kicad_sch, BOOSTXL-BATPAKMKII.sch, BOOSTXL-BATPAKMKII.xls]
2025-07-22 feat: begin annotating eval module BoM #7
    [CC120X vs CC112X.xlsx]
2025-08-18 feat: begin system testbed schematic capture
    [system-testbed.kicad_pcb, system-testbed.kicad_sch]
2025-08-19 chore: co-locate vendor evaluation recaptures #6
    [BOOSTXL-BATPAKMKII.brd, BOOSTXL-BATPAKMKII.kicad_pcb, BOOSTXL-BATPAKMKII.kicad_sch, BOOSTXL-BATPAKMKII.sch, BOOSTXL-BATPAKMKII.xls, CC1120EM_169.kicad_pcb, CC1120EM_169.kicad_sch, CC1200EMK-420-470.kicad_pcb]
2025-08-19 feat: recapture I2S Amp and begin I2S Mic #13
    [audio-subsystem.kicad_sch]
2025-08-19 feat: capture Switched Analog Volume Potentometer and Switched Quadrate Rotary Encoder #15
    [human-machine-interface.kicad_sch]
2025-08-19 feat: capture 4x4 Keypad Module #15
    [keypad.kicad_sch]
2025-08-19 feat: begin importing Battery Management System capture in new power subsystem sheet #3 #21
    [power-subsystem.kicad_sch, system-testbed.kicad_sch]
2025-08-19 feat: begin RF subsystem capture #7 #16
    [rf-power-amplifier.kicad_sch, rf-subsystem.kicad_sch]
2025-08-19 fix: phase out obselete microphone module
    [audio-subsystem.kicad_sch]
2025-08-20 feat: complete recapture of Adafruit Mic Module
    [audio-subsystem.kicad_sch]
2025-08-21 feat: begin dedicated sheets for RF switch throws, refine PA RFIC symbol #34
    [rf-power-amplifier-uhf.kicad_sch, rf-power-amplifier-vhf.kicad_sch, rf-subsystem.kicad_sch]
2025-08-22 feat: refine rf subsystem sheet, specify band selection from two tuned PAs #34
    [rf-power-amplifier-uhf.kicad_sch, rf-power-amplifier-vhf.kicad_sch, rf-subsystem.kicad_sch, rf-switch.kicad_sch]
2025-08-25 chore: clear power subsystem schematic, restructure subsheets
    [power-subsystem.kicad_sch, system-testbed.kicad_sch]
2025-08-25 chore: revise RF switch symbol description #34
2025-08-25 feat: complete RF switches, revise RF sheet structure #34
    [rf-frontend.kicad_sch, rf-power-amplifier-uhf.kicad_sch, rf-power-amplifier-vhf.kicad_sch, rf-subsystem.kicad_sch, rf-switch.kicad_sch]
2025-08-25 feat: assign RF netclass to RF signal paths #34
    [rf-power-amplifier-uhf.kicad_sch, rf-power-amplifier-vhf.kicad_sch, rf-subsystem.kicad_sch]
2025-08-29 docs: begin recapture of Adafruit EYESPI display #15
    [Display.kicad_pcb, Display.kicad_sch]
2025-08-29 feat: capture EYESPI display connectors #15
    [Display.kicad_sch, human-machine-interface.kicad_sch, system-testbed.kicad_sch]
2025-08-29 feat: re-sized PSU box KiCAD Runthrough Fixes #30
    [system-testbed.kicad_sch]
2025-09-02 feat: Power Subsystem Power Supply PCB Fixes #31
    [power-subsystem.kicad_sch, system-testbed.kicad_sch]
2025-09-03 feat: testing commit
    [system-testbed.kicad_sch]
2025-09-03 feat: import board stackup of OSHPark Prototype Service #57
    [system-testbed.kicad_pcb]
2025-09-03 fix: create real EYESPI FPC connector symbol and footprint #57
    [human-machine-interface.kicad_sch, rf-subsystem.kicad_sch]
2025-09-03 feat: assign 0603 passive component footprints #32 #34
    [audio-subsystem.kicad_sch, rf-frontend.kicad_sch, rf-power-amplifier-uhf.kicad_sch, rf-power-amplifier-vhf.kicad_sch]
2025-09-04 docs: draft recapture of Modulino for Templating #57
    [ABX00110.step, ABX00110_DXF_ALL.DXF, ABX00110_DXF_BOTTOM ASSEMBLY.DXF, ABX00110_DXF_BOTTOM SOLDER.DXF, ABX00110_DXF_BOTTOM.DXF, ABX00110_DXF_OUTLINE.DXF, ABX00110_DXF_TOP ASSEMBLY.DXF, ABX00110_DXF_TOP SOLDER.DXF]
2025-09-04 feat: create real Stemma QT connector symbol
2025-09-04 fix: move port expander over to HMI schematic #15 #33
    [human-machine-interface.kicad_sch, keypad.kicad_sch, system-testbed.kicad_sch]
2025-09-04 fix: relabel TRX GPIOs to breakout over EYESPI #34 #65
    [rf-subsystem.kicad_sch]
2025-09-04 docs: Pin Mapping Table for MCU and all interconnected subsystems
2025-09-04 Rename Pin Mapping Table to Pin Mapping Table.md
    markdown file
2025-09-05 feat: Update to PSU Power Supply PCB Fixes #31
    [power-subsystem.kicad_sch, system-testbed.kicad_sch]
2025-09-05 feat: Testing Sync
    [system-testbed.kicad_sch]
2025-09-06 datasheets and added esp32 symbol
2025-09-06 feat: begin mcu schematic #63
    [MCU.kicad_sch]
2025-09-06 fix: added WROVER symbol to project library and schematic
    [MCU.kicad_sch, system-testbed.kicad_sch]
2025-09-07 Update Pin Mapping Table.md
    need to find alternative for STUSB4500 GPIO
2025-09-08 audio-subsystem schematic update Audio PCB Fixes #32
    [audio-subsystem.kicad_sch]
2025-09-09 feat: update MCU schematic
    [MCU.kicad_sch]
2025-09-09 feat: begin footprints for STEMMA QT, Display, RF Switch, 24-bit Port Expander
2025-09-09 fix: add power devices to library
    [power-subsystem.kicad_sch]
2025-09-09 fix: relocate sheets on testbench
    [system-testbed.kicad_sch]
2025-09-10 Feat(Library): Add batch of new power ICs
2025-09-11 chore: remove local footprint libraries from table
2025-09-11 feat: add RF switch with built-in decoder #65
2025-09-11 chore: pin project footprint library
2025-09-11 fix: remove mounting holes for unused HW-834 keypad #69
    [keypad.kicad_sch]
2025-09-11 fix: standardize size symbol pins of RF switch to 2.54mm #65
2025-09-11 feat: utilize root sheet for Modulino interconnects #57
    [system-testbed.kicad_sch]
2025-09-11 feat: begin use of discrete diplexers over band select switches #65 feat: redraw rx/tx switching with built-in decode plus level shifting #34 feat: begin RF modulino testpoints #45
    [rf-subsystem.kicad_sch]
2025-09-12 feat: capture Audio PCB #32 feat: begin I2S Pin Mapping and Interconnects #53
    [audio-subsystem.kicad_sch]
2025-09-12 feat: assign inputs and output for I2S #53
    [MCU.kicad_sch]
2025-09-12 fix: clarify labellng and pin head #32
    [audio-subsystem.kicad_sch, system-testbed.kicad_sch]
2025-09-12 fix: rename #32
    [system-testbed.kicad_sch]
2025-09-12 fix: import RF sheet contents #65
    [rf-frontend.kicad_sch, rf-power-amplifier-uhf.kicad_sch, rf-power-amplifier-vhf.kicad_sch, rf-subsystem.kicad_sch]
2025-09-12 feat: move modulino interconnects to root sheet #57
    [system-testbed.kicad_sch]
2025-09-12 fix: begin reannotations #65 #70
    [audio-subsystem.kicad_sch, rf-power-amplifier-uhf.kicad_sch, rf-power-amplifier-vhf.kicad_sch, rf-subsystem.kicad_sch]
2025-09-12 fix: correct input and output for labels #51
    [power-subsystem.kicad_sch]
2025-09-12 fix: remove EYESPI from HMI sheet #69
    [human-machine-interface.kicad_sch]
2025-09-12 feat: pin relabel #63
    [MCU.kicad_sch]
2025-09-12 feat: hierarchical labels #63
    [MCU.kicad_sch]
2025-09-12 fix: reannotate and resolve power nets #51
    [power-subsystem.kicad_sch]
2025-09-12 feat: schematic capture #63
    [MCU.kicad_sch, power-subsystem.kicad_sch, system-testbed.kicad_sch]
2025-09-13 fix: Cleaned up structure of BMS PSU Schematic Capture Fixes #51
    [power-subsystem.kicad_sch]
2025-09-13 Create Workflow Runthrough #3.md
    summary of workflow 3 - blank modulino template in PCB editor
2025-09-13 Create Workflow Runthrough #4.md
    summary of workflow 4 - advanced PCB tools
2025-09-13 feat: added WROVER footprint to project library & symbol
    [MCU.kicad_sch, system-testbed.kicad_sch]
2025-09-13 feat: added WROVER footprint to project library & symbol - MCU Schematic capture Fixes #63
    [MCU.kicad_sch]
2025-09-13 feat: MCU changes to root labels & passive component sizes #63
    [MCU.kicad_sch, system-testbed.kicad_sch]
2025-09-13 fix: fixing labels PSU Schematic Capture Fixes #51
    [power-subsystem.kicad_sch]
2025-09-13 fix: reannotate schematics for pcb editor use #55
    [audio-subsystem.kicad_sch, human-machine-interface.kicad_sch, keypad.kicad_sch, rf-frontend.kicad_sch, rf-power-amplifier-uhf.kicad_sch, rf-power-amplifier-vhf.kicad_sch, rf-subsystem.kicad_sch, system-testbed.kicad_pcb]
2025-09-14 Feat: Added ICs & Completed schematic for the other blocks
    [Other Blocks.kicad_sch]
2025-09-14 Revert "Feat: Added ICs & Completed schematic for the other blocks"
    This reverts commit 5ccb9a6ab9d8f693594799fe98ca877545035d56.
    [Other Blocks.kicad_sch]
2025-09-14 Feat: Add Regulators & Power distribution Schematics, and new power IC libraries
    [Other Blocks.kicad_sch, power-subsystem.kicad_sch]
2025-09-14 Fix: Changed IC positions
    [Other Blocks.kicad_sch, power-subsystem.kicad_sch]
2025-09-14 Feat: Added footprint for TVS Diode
    [power-subsystem.kicad_sch]
2025-09-18 fix: remove unused mounting holes for HW #69 fix: edit symbol fields of button matrix #69
    [keypad.kicad_sch]
2025-09-18 fix: recover MCU schematic and esp32 module footprint #60
    [MCU.kicad_sch]
2025-09-18 fix: recover audio schematic #70
    [audio-subsystem.kicad_sch]
2025-09-18 feat: swap to vertical rotary encoder used by Modulino Knob #69
    [human-machine-interface.kicad_sch]
2025-09-23 fix: allow for DRC use in PCB editor by successful reannotation
    [MCU.kicad_sch, Other Blocks.kicad_sch, human-machine-interface.kicad_sch, power-subsystem.kicad_sch, rf-frontend.kicad_sch, rf-power-amplifier-uhf.kicad_sch, rf-power-amplifier-vhf.kicad_sch, rf-subsystem.kicad_sch]
2025-09-24 feat: begin arduino framework instead of arduino component compatibility #12
2025-09-24 feat: include SMA through-hole connector 3d model #34
2025-09-24 feat: begin transceiver driver and capture command strobes #12
2025-10-02 feat: update pinouts for mcu #53
    [MCU.kicad_sch, system-testbed.kicad_sch]
2025-10-22 chore: co-locate reference design files
    [ABX00110.step, ABX00110_DXF_ALL.DXF, ABX00110_DXF_BOTTOM ASSEMBLY.DXF, ABX00110_DXF_BOTTOM SOLDER.DXF, ABX00110_DXF_BOTTOM.DXF, ABX00110_DXF_OUTLINE.DXF, ABX00110_DXF_TOP ASSEMBLY.DXF, ABX00110_DXF_TOP SOLDER.DXF]
2025-10-22 chore: remove unused BMS KiCAD project version
    [BMS_Schematics.kicad_sch]
2025-10-22 chore: migrate Adafruit reference design to documentation
    [Display.kicad_pcb, Display.kicad_sch]
2025-10-22 chore: move TI reference designs to documentation
    [BOOSTXL-BATPAKMKII.brd, BOOSTXL-BATPAKMKII.kicad_pcb, BOOSTXL-BATPAKMKII.kicad_sch, BOOSTXL-BATPAKMKII.sch, BOOSTXL-BATPAKMKII.xls, CC1120EM_169.kicad_pcb, CC1120EM_169.kicad_sch, CC1200EMK-420-470.kicad_pcb]
2025-10-22 chore: move KiCAD footprint library to root of KiCAD projects directory
2025-10-22 feat: use symlinks to common project KiCAD footprint library
2025-10-22 feat: include interactive bill of materials for all REV A modulinos
2025-10-22 chore: move Guerrilla RF reference designs to documentation
    [GRF-DFN6-15-23A.kicad_pcb, GRF-DFN6-15-23A.kicad_sch, GRF-QFN16-30-21-A.kicad_pcb, GRF-QFN16-30-21-A.kicad_sch, GRF-QFN16-30-46-A.kicad_sch]
2025-10-22 chore: replot system testbed schematic describing all modulinos #55
2025-10-22 feat: separate RF subsystem boards into separate KiCAD projects #34
    [rf-amplifier-modulino.kicad_pcb, rf-switch-modulino.kicad_pcb, rf-transceiver-modulino.kicad_pcb, rf-transceiver-modulino.kicad_sch]
2025-10-22 feat: begin all modulino board directories
2025-10-22 feat: separate RF subsystems for testing using SMA edge launches in testbed KiCAD project #65 #34 #45
    [rf-frontend.kicad_sch, rf-power-amplifier-uhf.kicad_sch, rf-power-amplifier-vhf.kicad_sch, rf-subsystem.kicad_sch, system-testbed.kicad_pcb, system-testbed.kicad_sch]
2025-10-22 docs: begin describing reference design use and "schematic recapture" process #57 #48
2025-10-24 fix: clarify naming of sck pin configuration #82
    [main.cpp]
2025-10-29 chore: added MCU modulino Rev A PCB files to testbed
2025-10-29 Update Pin Mapping Table.md
    fix: changed reassigned pin numbers
2025-10-31 chore: added additional Rev A PCB file to MCU modulino
    [testbed-mcu.kicad_pcb]
2025-10-31 doc: added MCU docs and notes
    [MCU.kicad_sch]
2025-11-01 feat: create skyworks switch driver #45 #82
2025-11-03 chore: moved Adafruit display sample code from main #86
2025-11-03 feat: draft simplified display driver #86
2025-11-03 feat: refine switch demo and begin amplifier demo #45 #82
2025-11-04 chore: test code for WROVER - i2c, spi, cores, gpios MCU Testing #83
2025-11-06 Audio PCB Modulino
2025-11-07 feat: move I2C scan debugging into port expander initialization
2025-11-14 Revert "doc: added MCU docs and notes"
    [MCU.kicad_sch]
2025-11-15 feat: get SPI transactions working for register access #81
2025-11-15 fix: migrate display updates away from switching logic #82
2025-11-15 feat: establish display init and config chore: rename folder to display driver chip name
2025-11-15 Update Pin Mapping Table.md
2025-11-16 feat: rewrite most demos for one-time device inits #82
2025-11-19 feat: improve debug printing and include more fonts #86
2025-11-19 feat: better integrate I2C scanner, improve debug printing, allow for storing name of expander #83 #86 #82
2025-11-19 feat: refactor device initialization routines for clarity, remove unused display demo code #86 feat: improve debug printing format and content for demo selection #12 #55
2025-11-19 feat: improve switch demo visuals and debug printing #82
2025-11-19 feat: improve debug printing, relocate interface setup routine #82
2025-11-24 feat: add hmi and mcu modulinos
    [audio-subsystem.kicad_sch, hmi-modulino.kicad_pcb, human-machine-interface.kicad_sch, keypad.kicad_sch, mcu-modulino.kicad_pcb, mcu-modulino.kicad_sch]
2025-11-27 feat: begin I2S device drivers
2025-12-02 feat: improve driver interfacing, continue frequency programming #82
2025-12-06 docs: organized REV A and REV B pcb and schematic files and put them into their relavent folders
    [Audio PCB.kicad_pcb, Other Blocks.kicad_sch, audio-modulino-REV-A.kicad_pcb, audio-modulino-REV-A.kicad_sch, audio-subsystem.kicad_sch, hmi-modulino-REV-A.kicad_sch, hmi-modulino.kicad_pcb, hmi_REV_A.kicad_pcb]
2025-12-06 docs: added power modulino schematics for Rev A and Rev B
    [power-modulino-REV-A.kicad_sch, power-modulino-REV-B.kicad_sch]
2025-12-06 docs: include device and connector datasheets
2025-12-06 feat: allow rotation config, display spi speed in MHz #86
2025-12-06 fix: use C string over std::string in printf
2025-12-06 fix: correct RF expander and I2S0 pin assigment, set display rotation
    [main.cpp]
2025-12-06 feat: refine cc1200 driver interface, begin I2S helpers #45
2025-12-06 docs: update all system schematics for project uniformity
    [audio-subsystem.kicad_sch, human-machine-interface.kicad_sch, keypad.kicad_sch, mcu-modulino-REV-A.kicad_sch, power-subsystem.kicad_sch, rf-amplifier-modulino-uhf.kicad_sch, rf-amplifier-modulino-vhf.kicad_sch, rf-power-amplifier-uhf.kicad_sch]
2025-12-07 fix: provide return for playback #91
    [rf-frontend.kicad_sch, rf-transceiver-modulino-frontend.kicad_sch]
2025-12-07 feat: write manual calibration routine #82
2025-12-09 feat: begin RSSI freeRTOS timer and task, begin MainTask switch
2025-12-09 fix: change 3D model paths to be in project footprint library
    [hmi-modulino.kicad_pcb]
2025-12-21 Revert "docs: organized REV A and REV B pcb and schematic files and put them into their relavent folders"
    [Audio PCB.kicad_pcb, MCU.kicad_sch, Other Blocks.kicad_sch, audio-modulino-REV-A.kicad_pcb, audio-modulino-REV-A.kicad_sch, audio-subsystem.kicad_sch, hmi-modulino.kicad_pcb, hmi_REV_A.kicad_pcb]
2026-02-16 feat: utilize fuel gauge and bms libraries
2026-02-16 chore: refactor and abstract display driver use
