OpenAir-Lab/capstone-project/(notices)

Notices in the files:
parts and their libraries:
SparkFun: Licensing: CC v3.0 Share-Alike You are welcome to use this library for commercial purposes.
TI-LaunchPad-Eagle: As far as I know the LaunchPad rocket is released by TI under the Creative Commons license.
